willbearfruits/samplooler/app/screenshots/board-samplooler.png

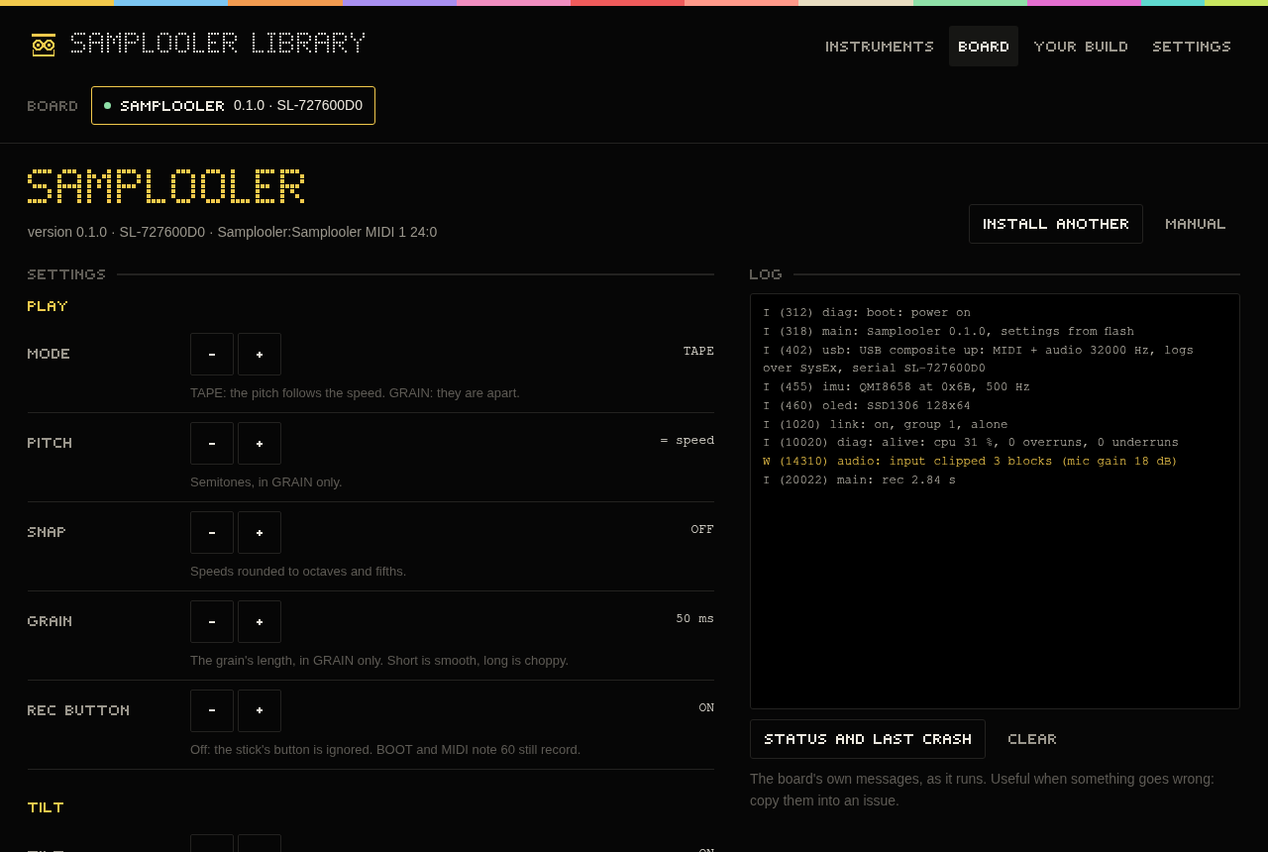
app/screenshots/board-samplooler.png
