willbearfruits/samplooler/app/screenshots/board.png

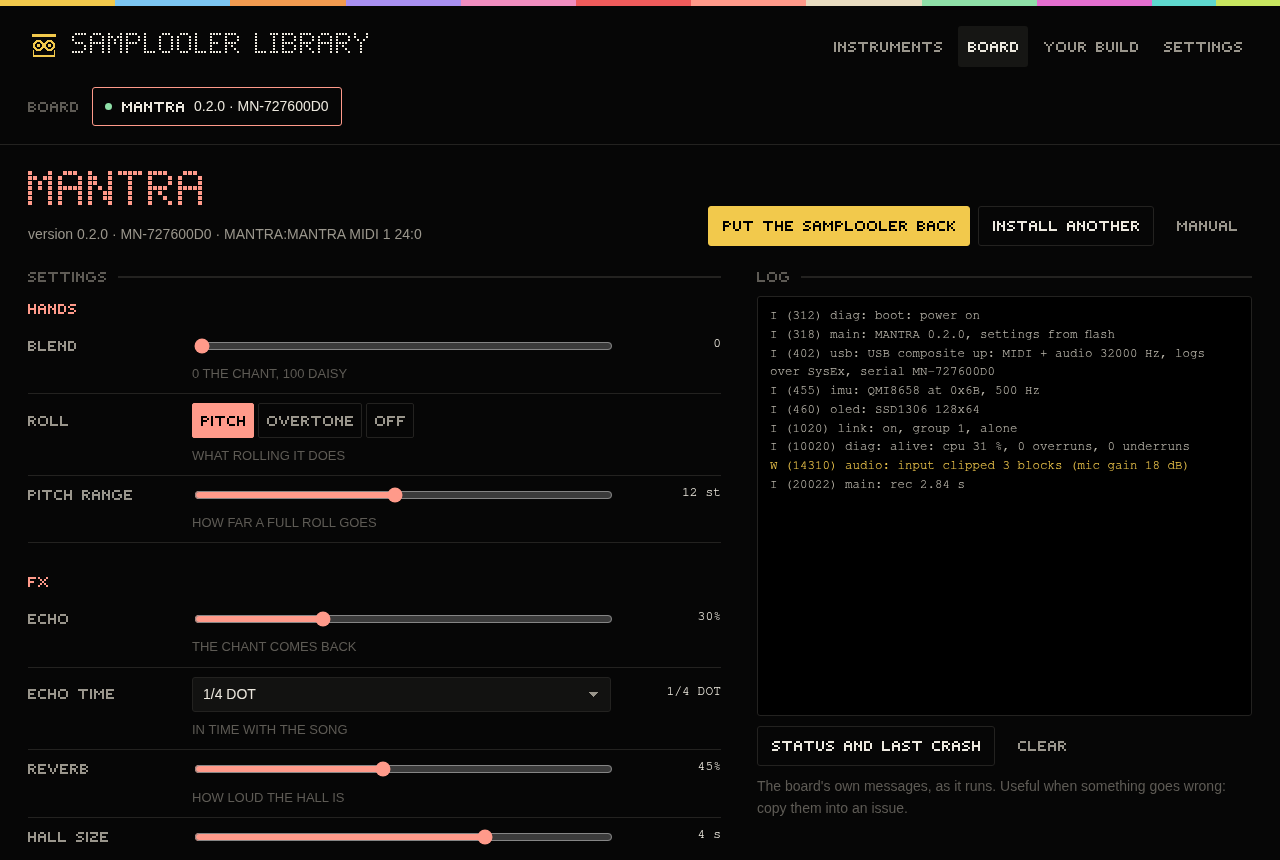
app/screenshots/board.png
