willbearfruits/samplooler/app/screenshots/instrument.png

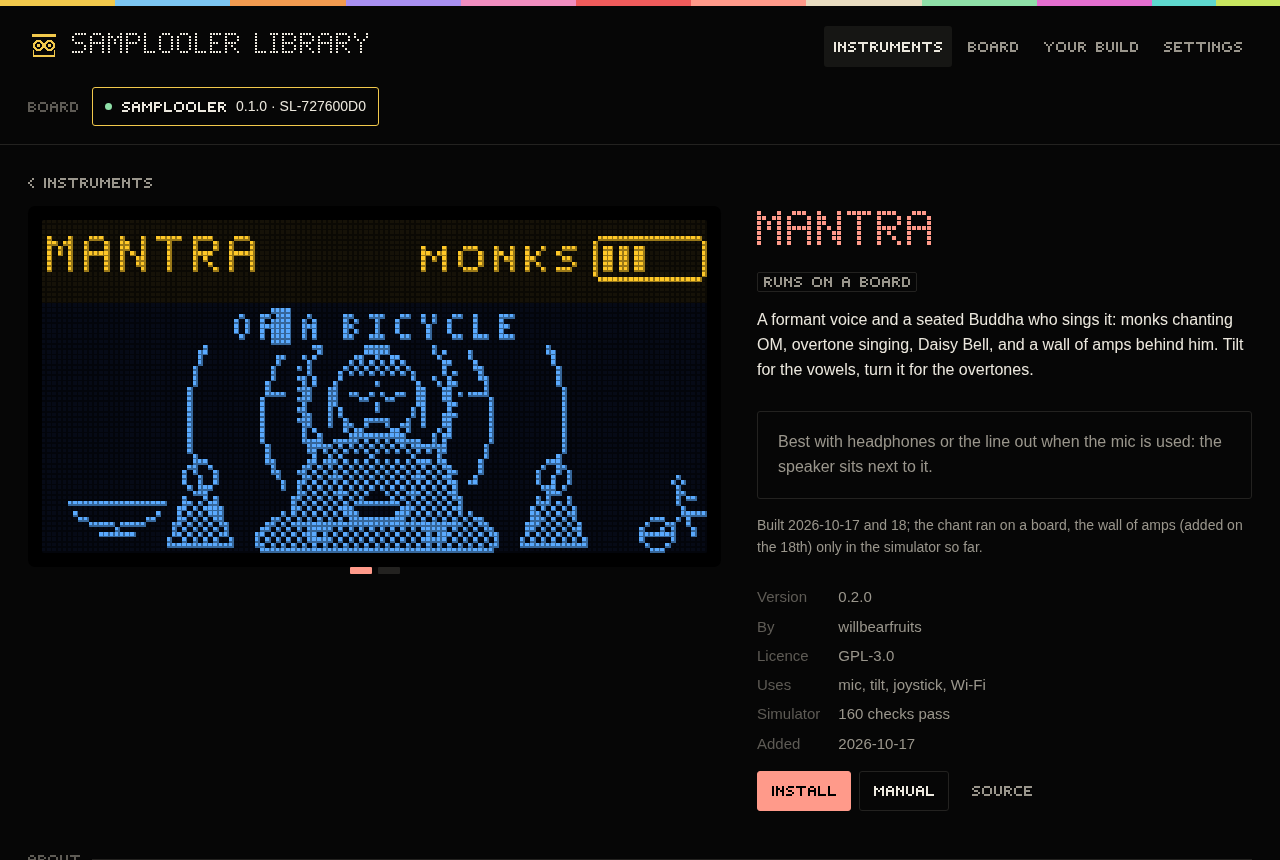
app/screenshots/instrument.png
