willbearfruits/samplooler/app/screenshots/library-update.png

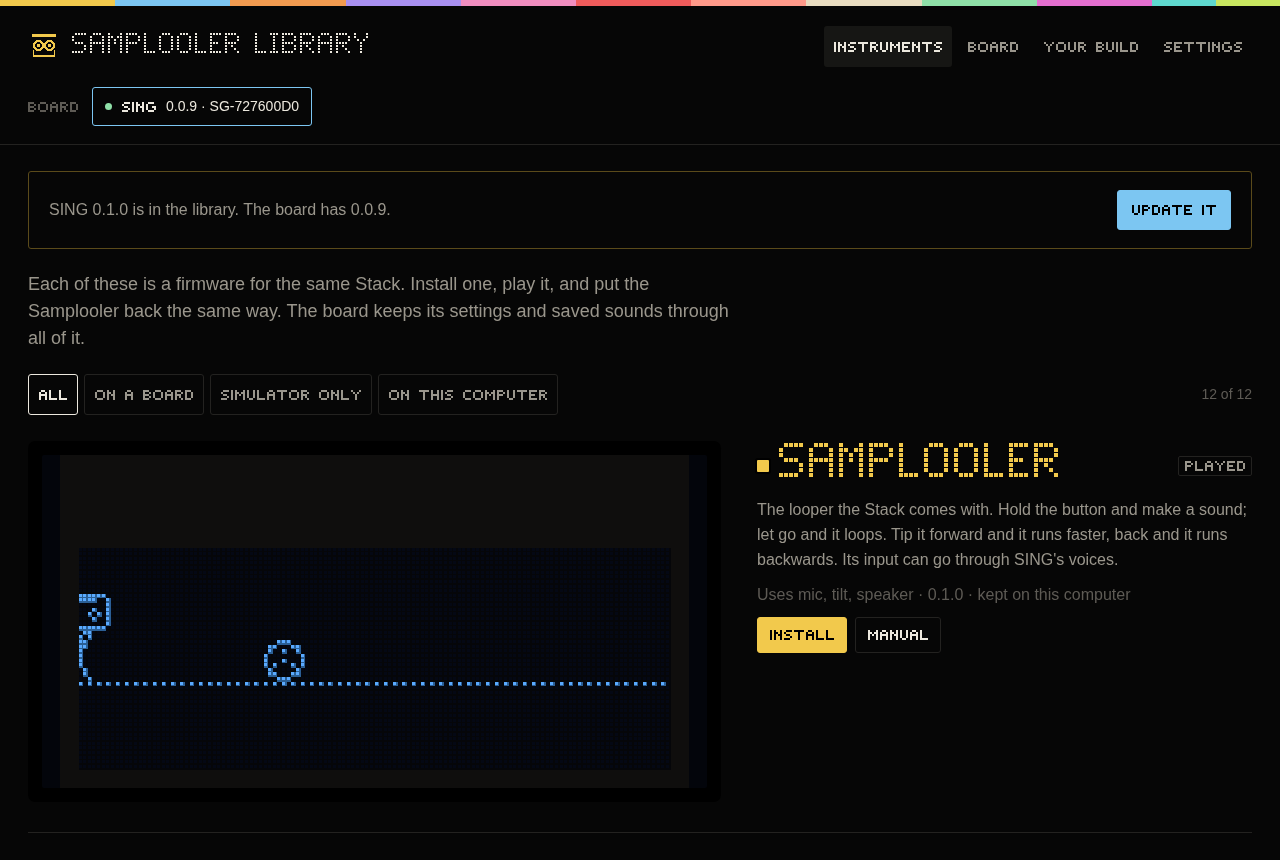
app/screenshots/library-update.png
