willbearfruits/samplooler/app/screenshots/settings.png

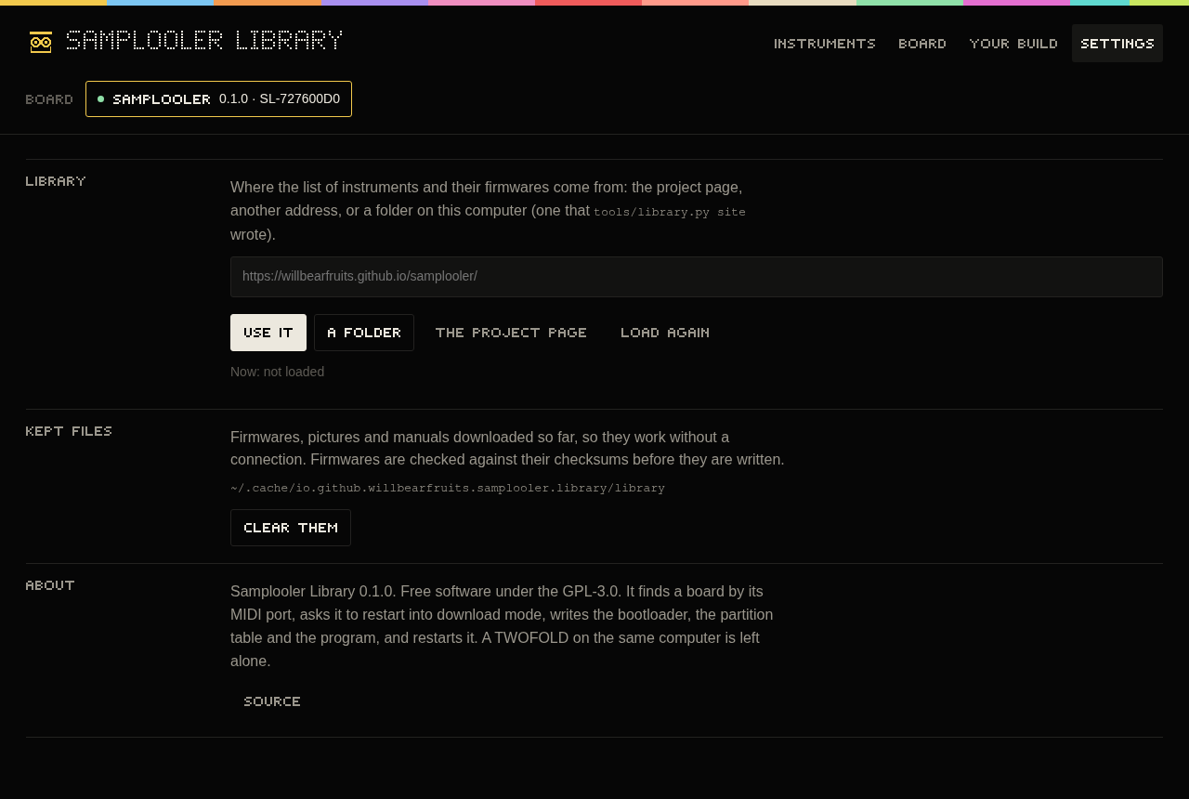
app/screenshots/settings.png
