willbearfruits/samplooler/app/screenshots/window-real.png

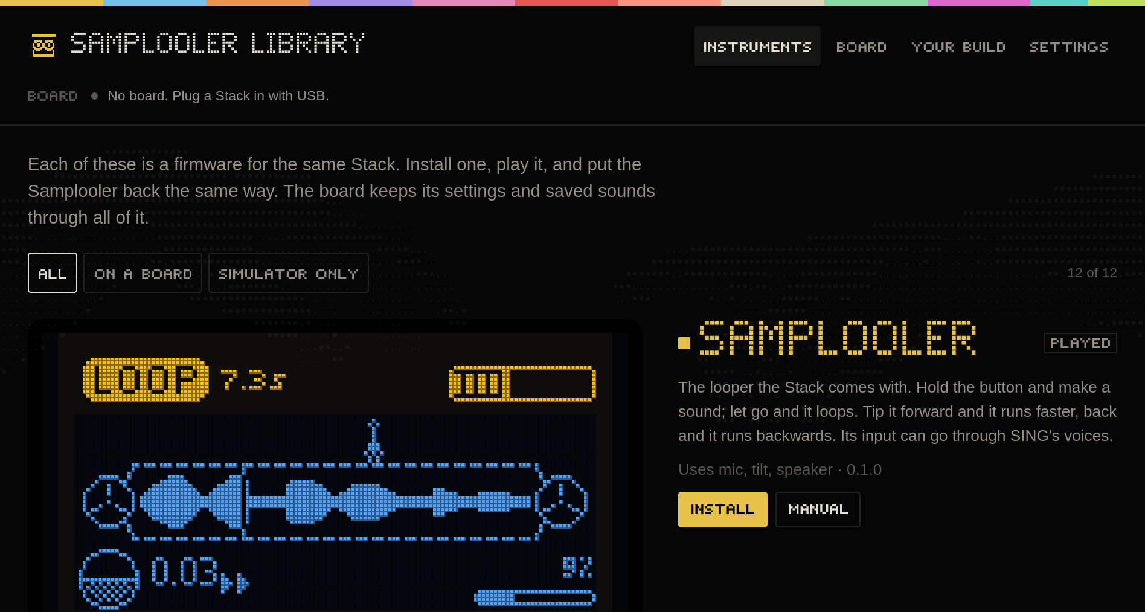
app/screenshots/window-real.png
