willbearfruits/samplooler/docs/pinout-1098.webp

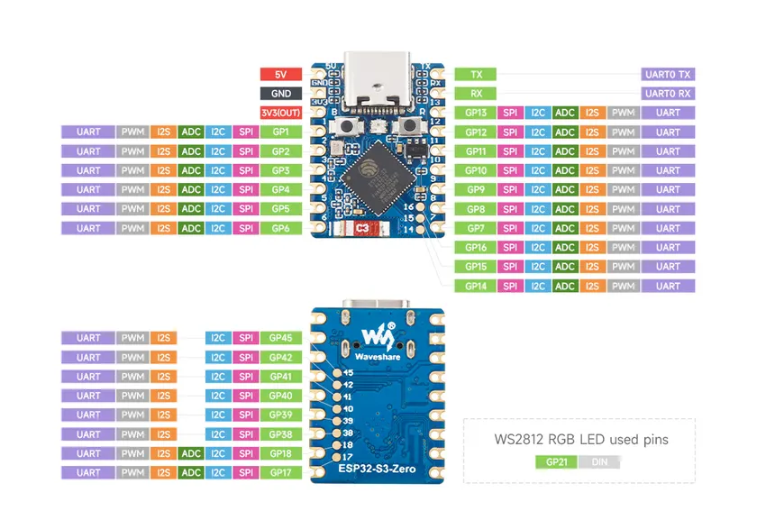
docs/pinout-1098.webp
