willbearfruits/samplooler/enclosure/out/plate_top.png

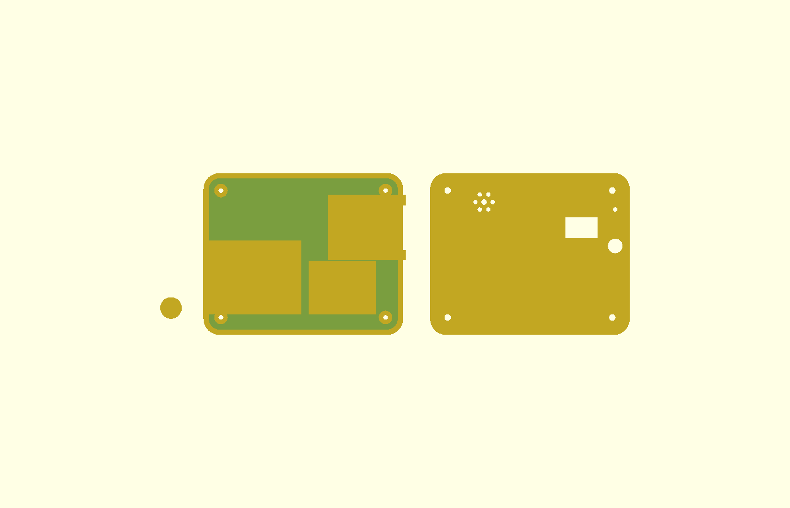
enclosure/out/plate_top.png
