willbearfruits/samplooler/enclosure/out/top.png

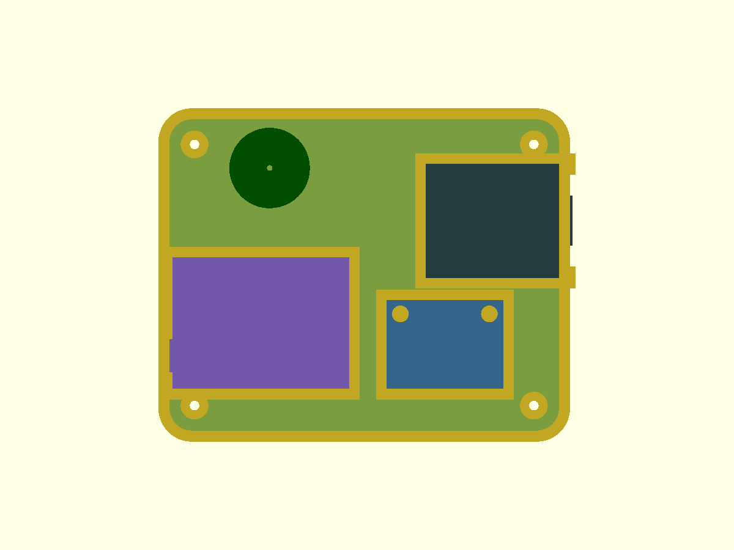
enclosure/out/top.png
