willbearfruits/samplooler/hardware/images/boards-plan.png

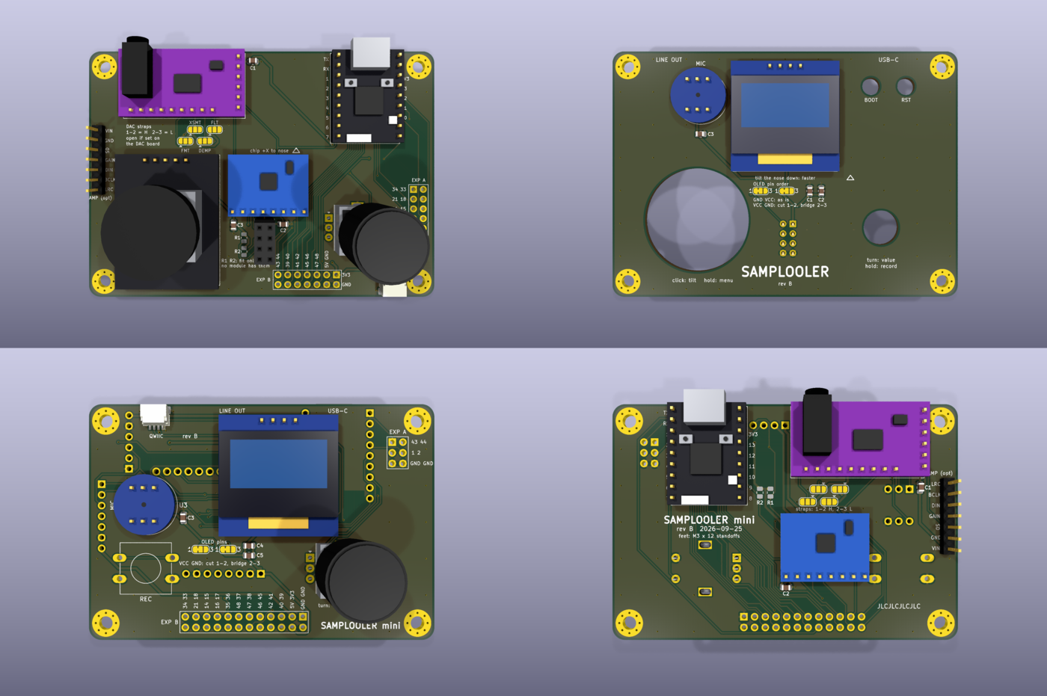
hardware/images/boards-plan.png
