willbearfruits/samplooler/hardware/images/bottom-3d.png

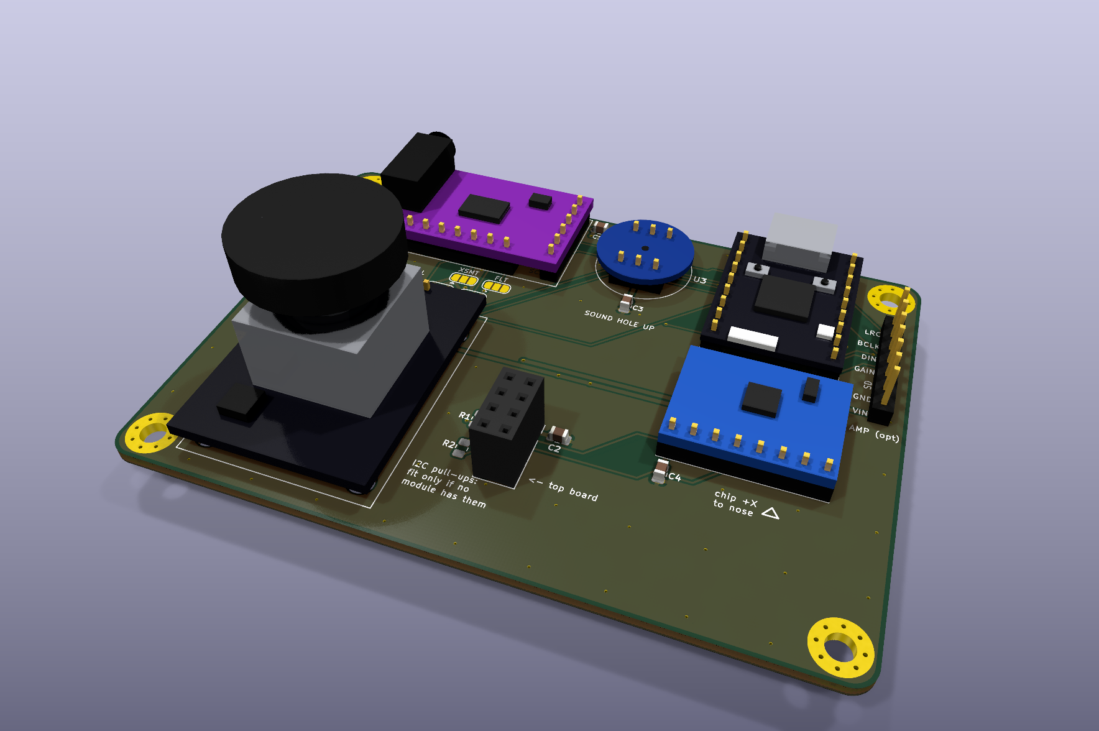
hardware/images/bottom-3d.png
