willbearfruits/samplooler/hardware/images/bottom-plan.png

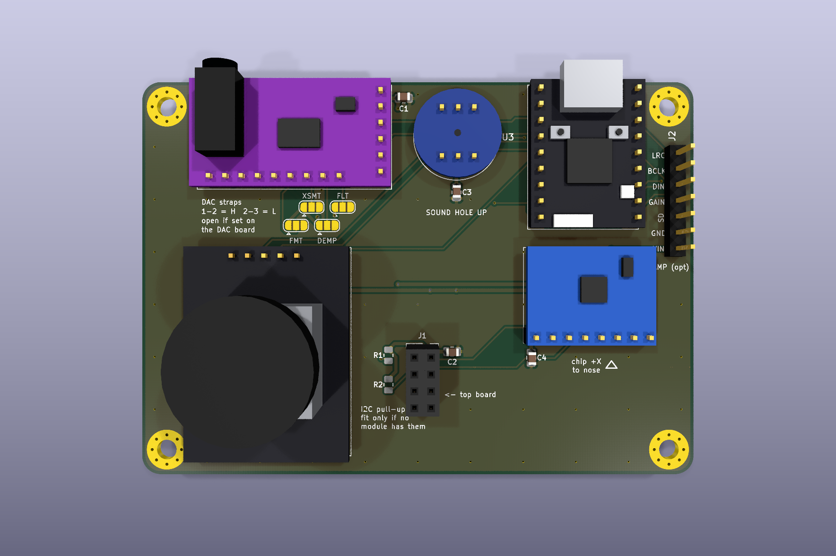
hardware/images/bottom-plan.png
