willbearfruits/samplooler/hardware/images/mini-3d-front-back.png

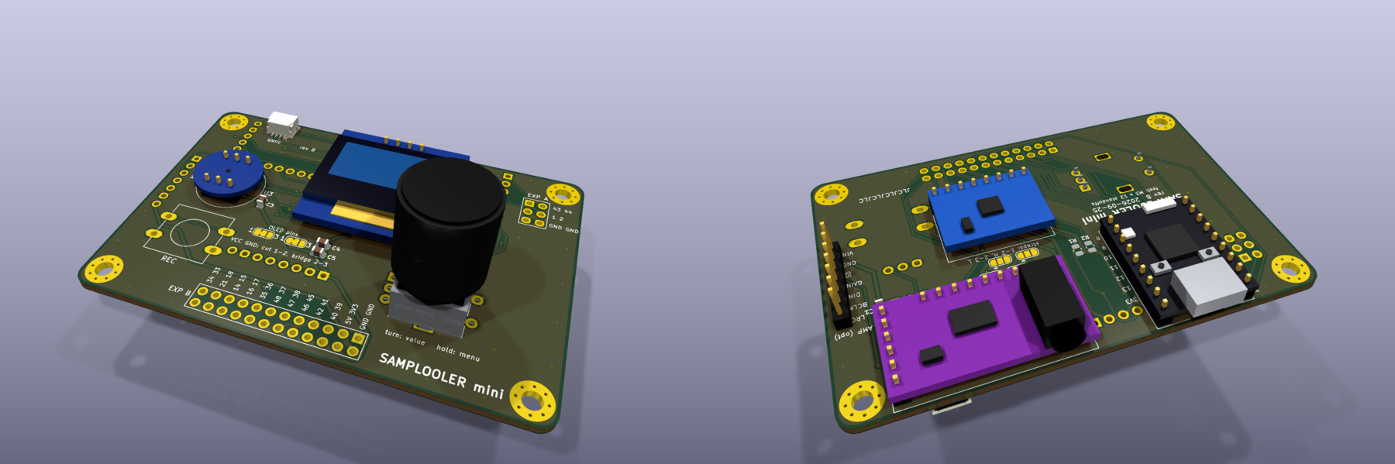
hardware/images/mini-3d-front-back.png
