willbearfruits/samplooler/hardware/images/mini-back-3d.png

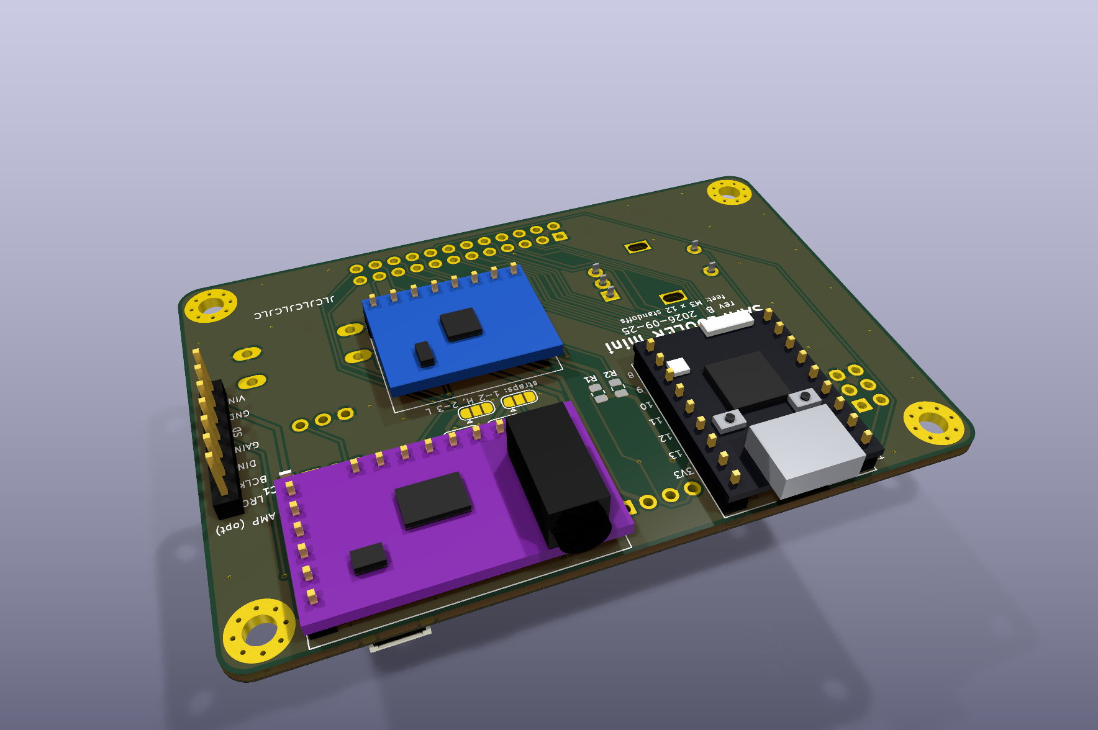
hardware/images/mini-back-3d.png
