willbearfruits/samplooler/hardware/images/mini-back-plan.png

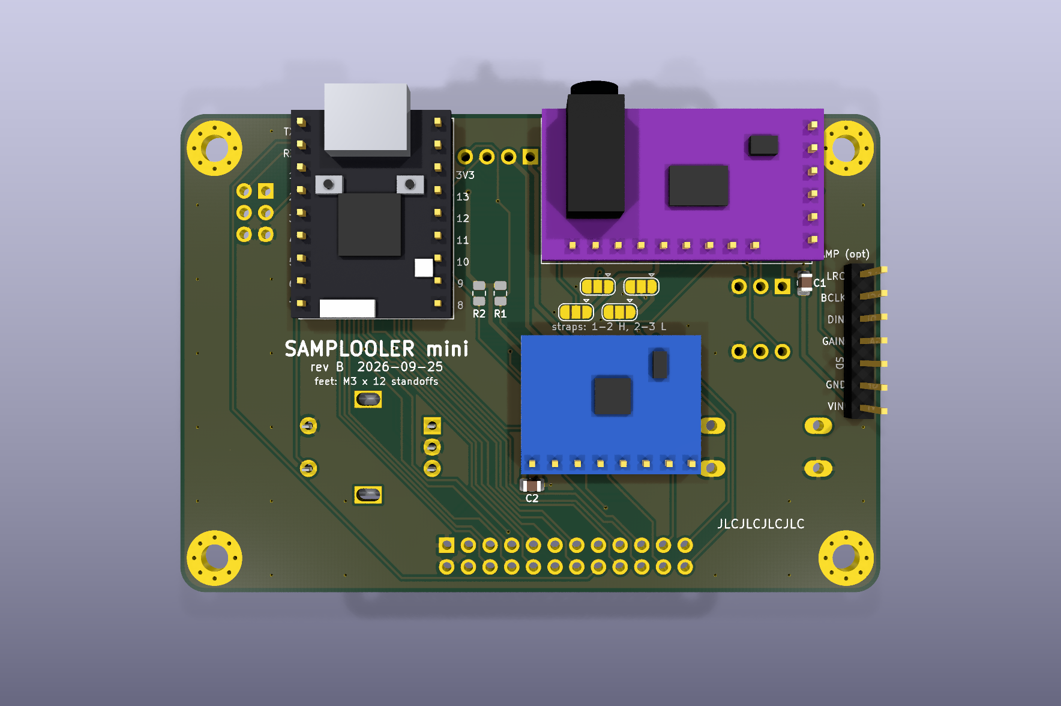
hardware/images/mini-back-plan.png
