willbearfruits/samplooler/hardware/images/mini-front-3d.png

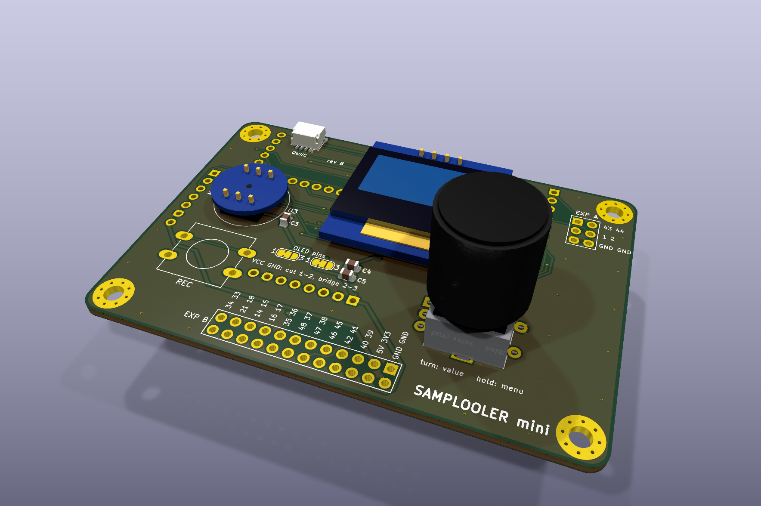
hardware/images/mini-front-3d.png
