willbearfruits/samplooler/hardware/images/mini-front-plan.png

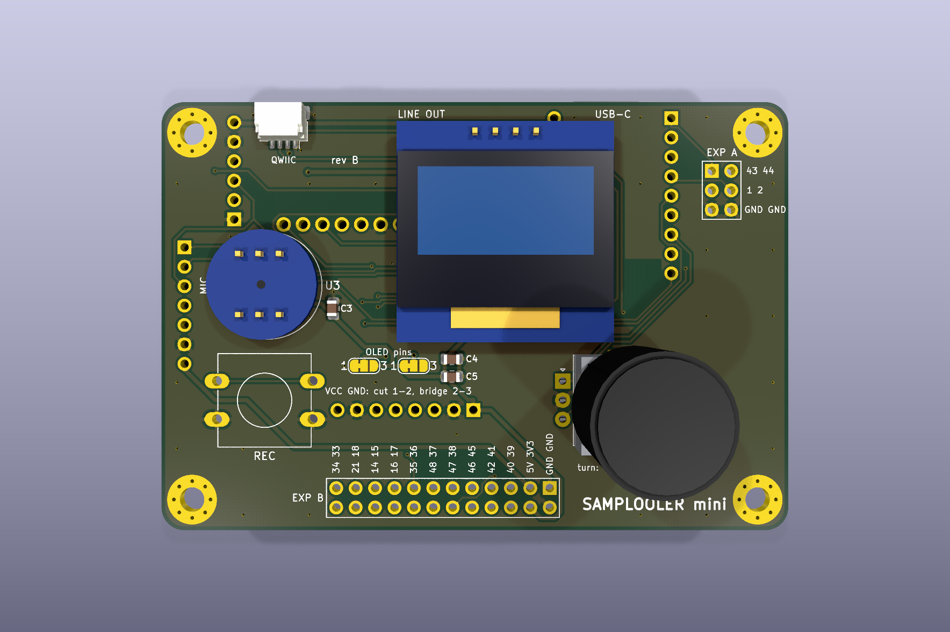
hardware/images/mini-front-plan.png
