willbearfruits/samplooler/hardware/images/mini-side.png

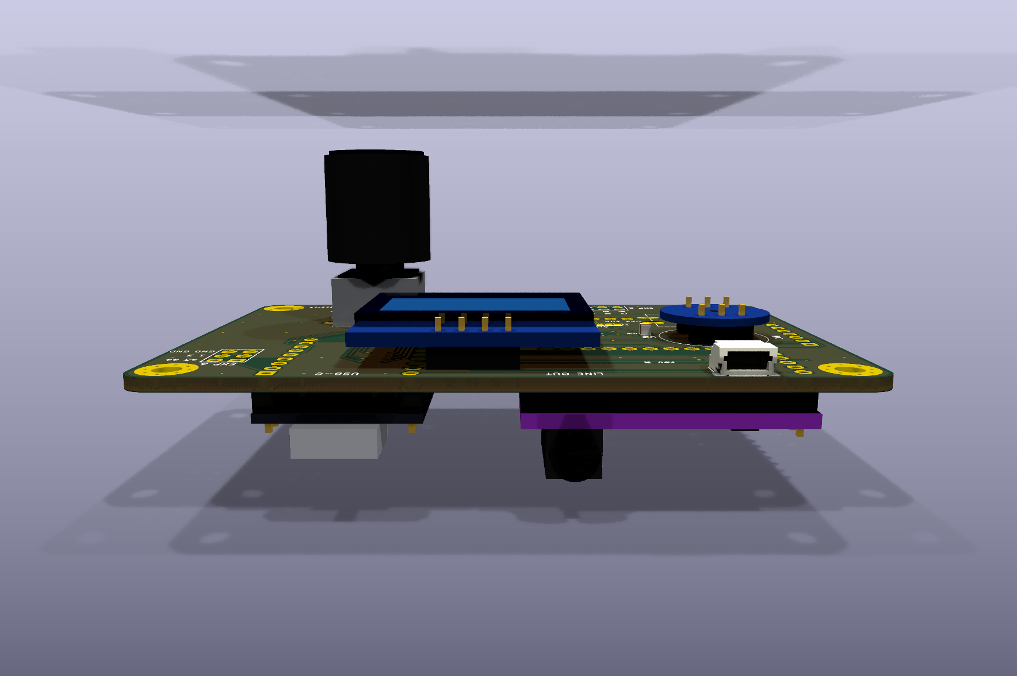
hardware/images/mini-side.png
