willbearfruits/samplooler/hardware/images/panel-mini-back.png

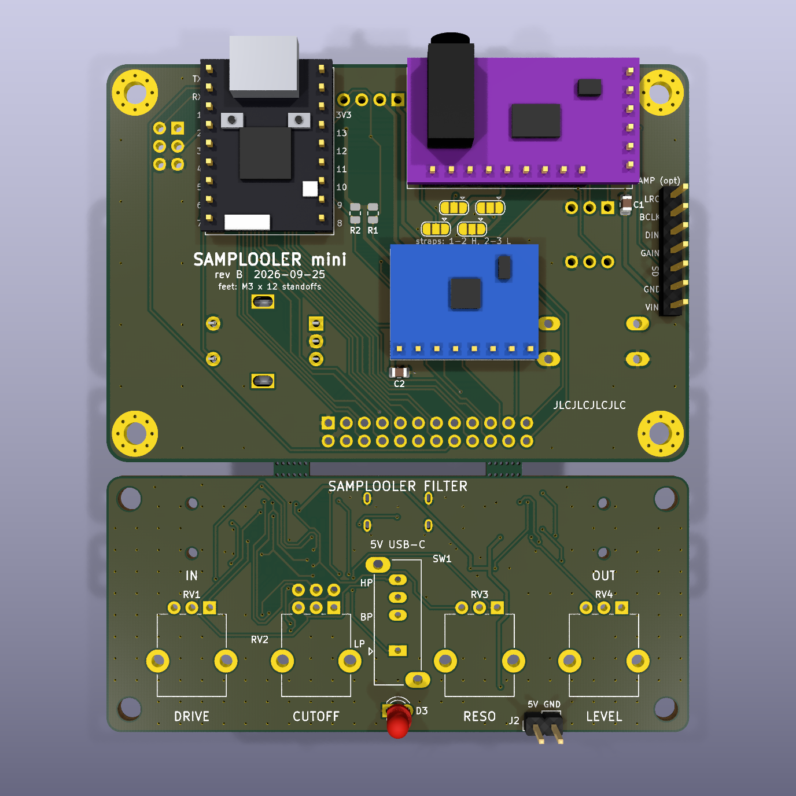
hardware/images/panel-mini-back.png
