willbearfruits/samplooler/hardware/images/panel-mini.png

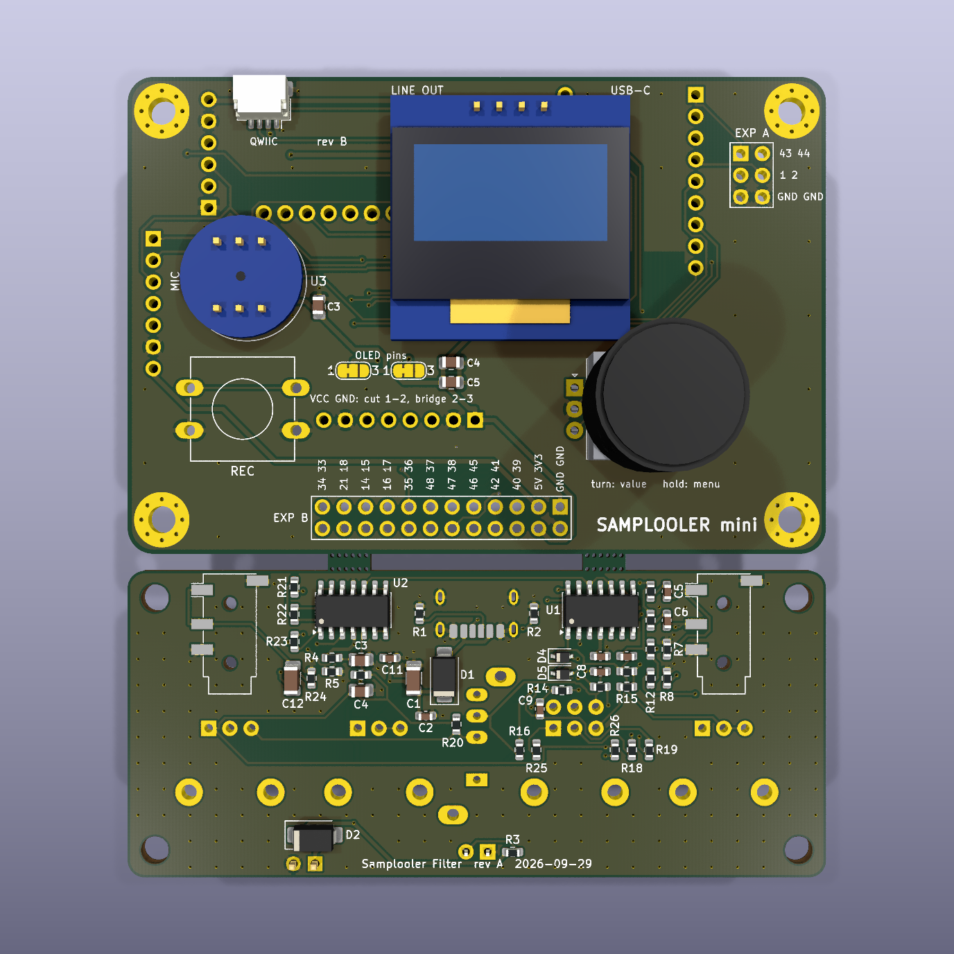
hardware/images/panel-mini.png
