willbearfruits/samplooler/hardware/images/panel-stack-back.png

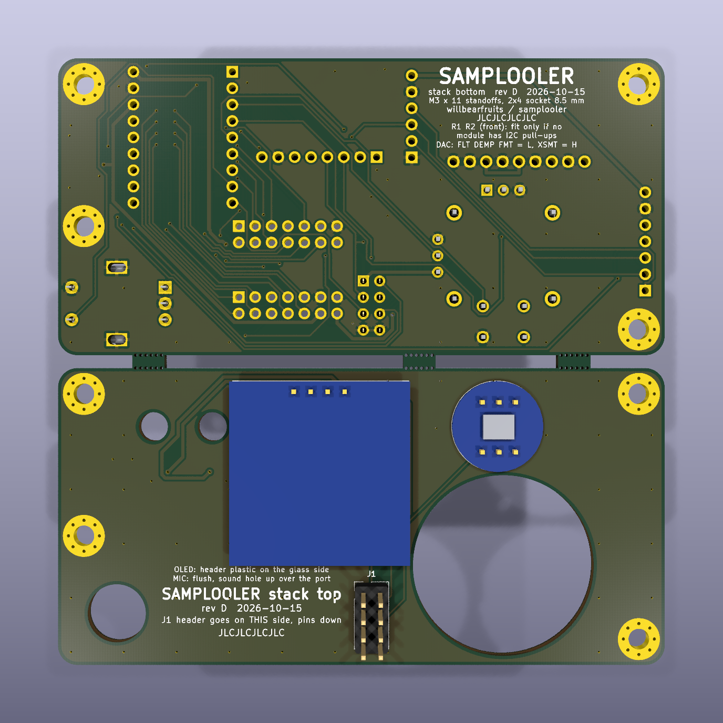
hardware/images/panel-stack-back.png
