willbearfruits/samplooler/hardware/images/top-3d.png

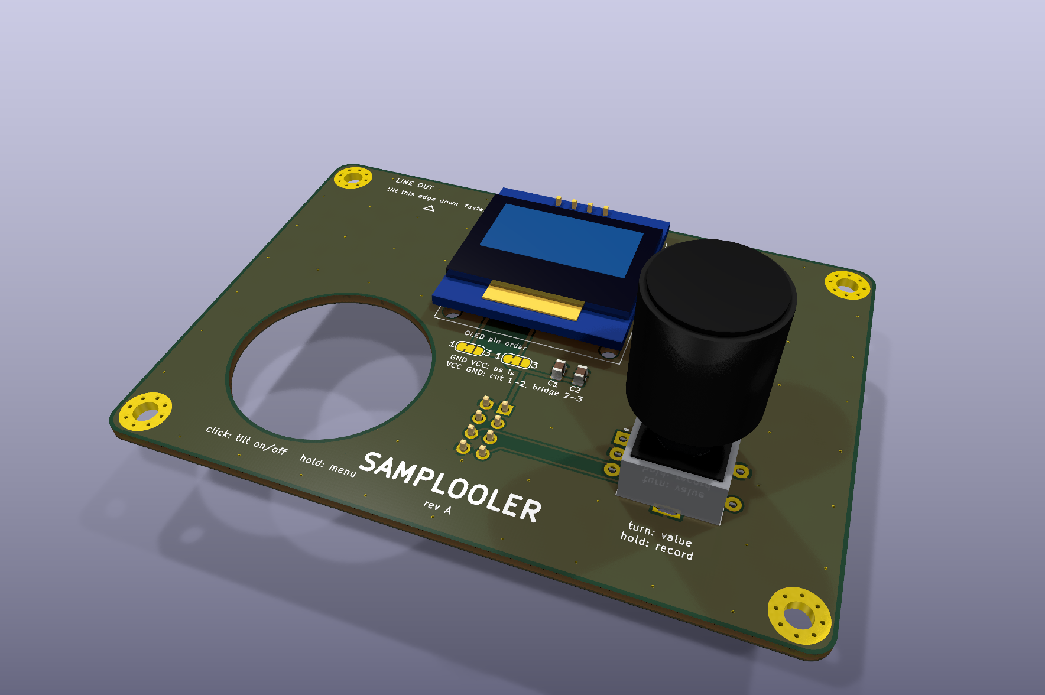
hardware/images/top-3d.png
