willbearfruits/samplooler/hardware/images/top-plan.png

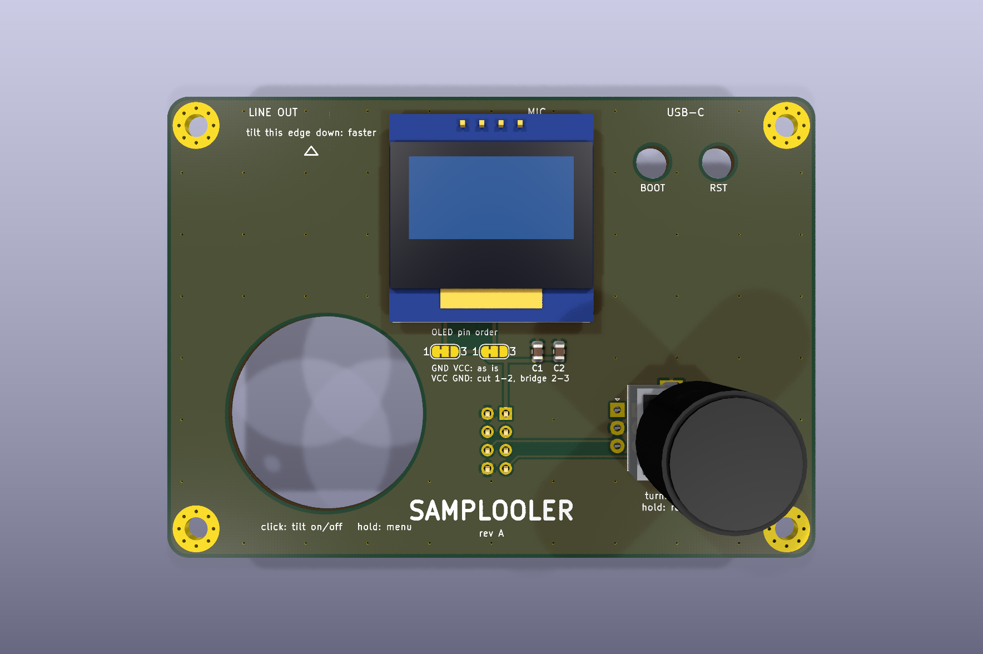
hardware/images/top-plan.png
