willbearfruits/samplooler/images/screens-c3.png

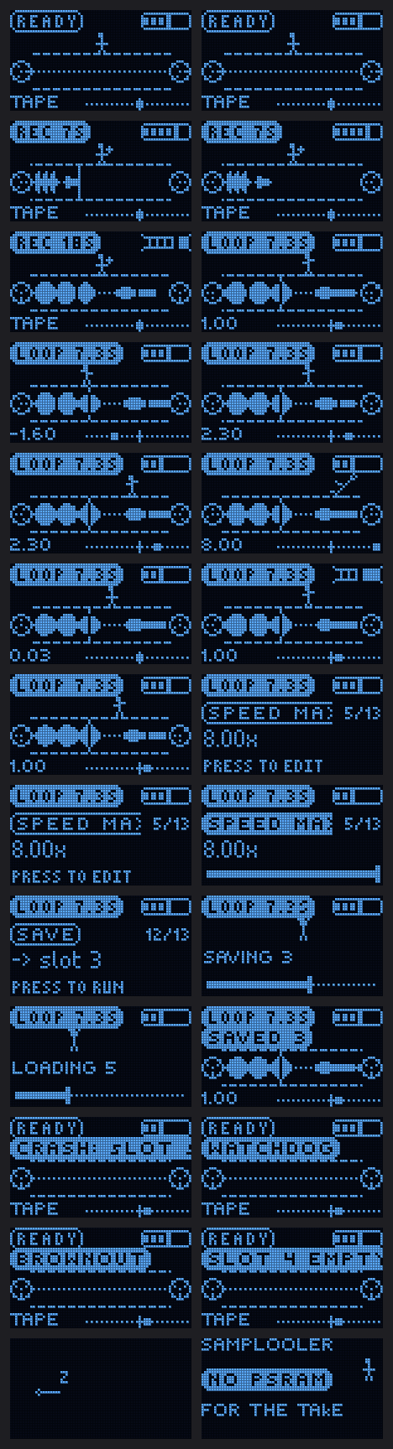
images/screens-c3.png
