willbearfruits/samplooler/images/screens-s3.png

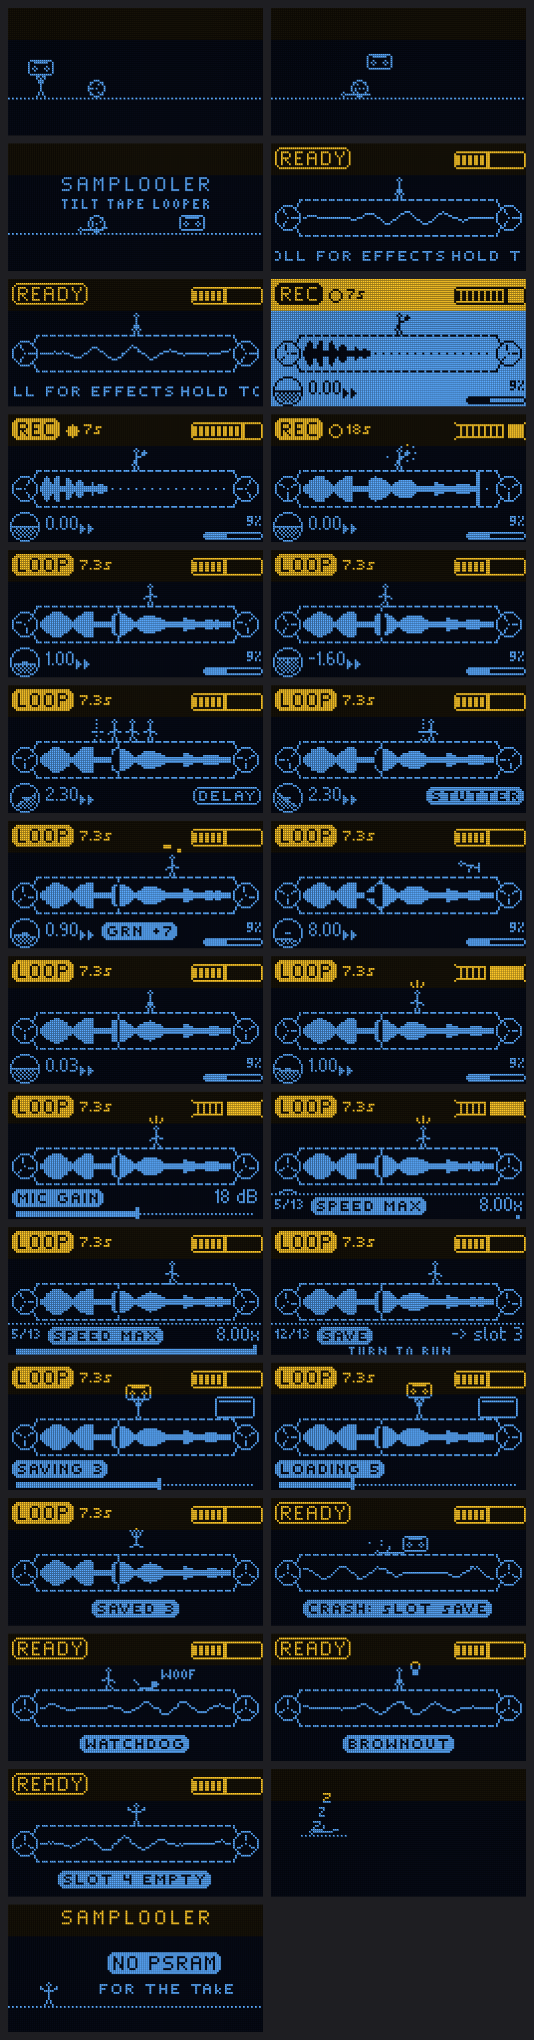
images/screens-s3.png
