willbearfruits/samplooler/instruments/band/images/band-bass-follow.gif

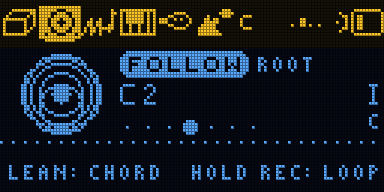
instruments/band/images/band-bass-follow.gif
