willbearfruits/samplooler/instruments/band/images/band-breath.gif

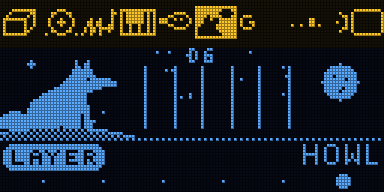
instruments/band/images/band-breath.gif
