willbearfruits/samplooler/instruments/band/images/band-drums.gif

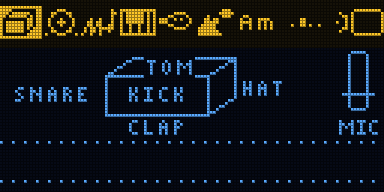
instruments/band/images/band-drums.gif
