willbearfruits/samplooler/instruments/band/images/band-howl_layer.gif

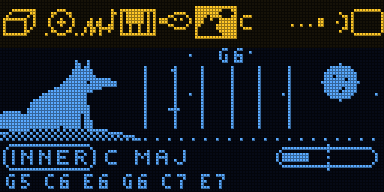
instruments/band/images/band-howl_layer.gif
