willbearfruits/samplooler/instruments/band/images/band-keys-comp.gif

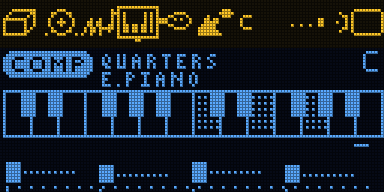
instruments/band/images/band-keys-comp.gif
