willbearfruits/samplooler/instruments/band/images/band-keys-sounds.gif

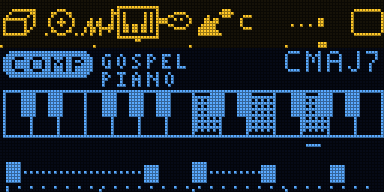
instruments/band/images/band-keys-sounds.gif
