willbearfruits/samplooler/instruments/band/images/band-lead-arp.gif

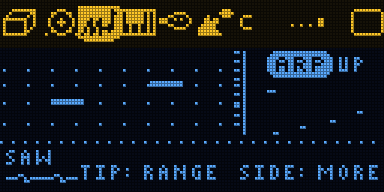
instruments/band/images/band-lead-arp.gif
