willbearfruits/samplooler/instruments/band/images/band-together.gif

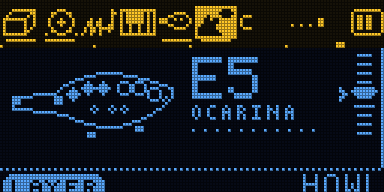
instruments/band/images/band-together.gif
