willbearfruits/samplooler/instruments/band/images/screens.png

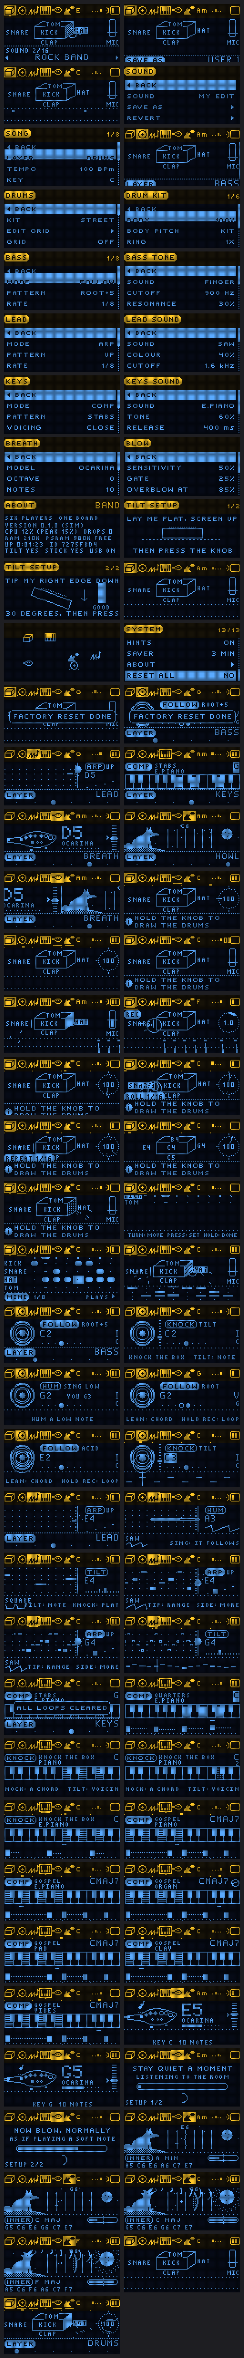
instruments/band/images/screens.png
