willbearfruits/samplooler/instruments/chirp/images/arrive.gif

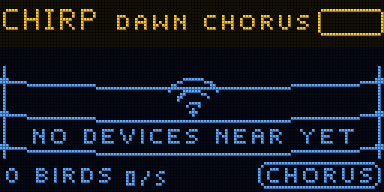
instruments/chirp/images/arrive.gif
