willbearfruits/samplooler/instruments/chirp/images/screens.png

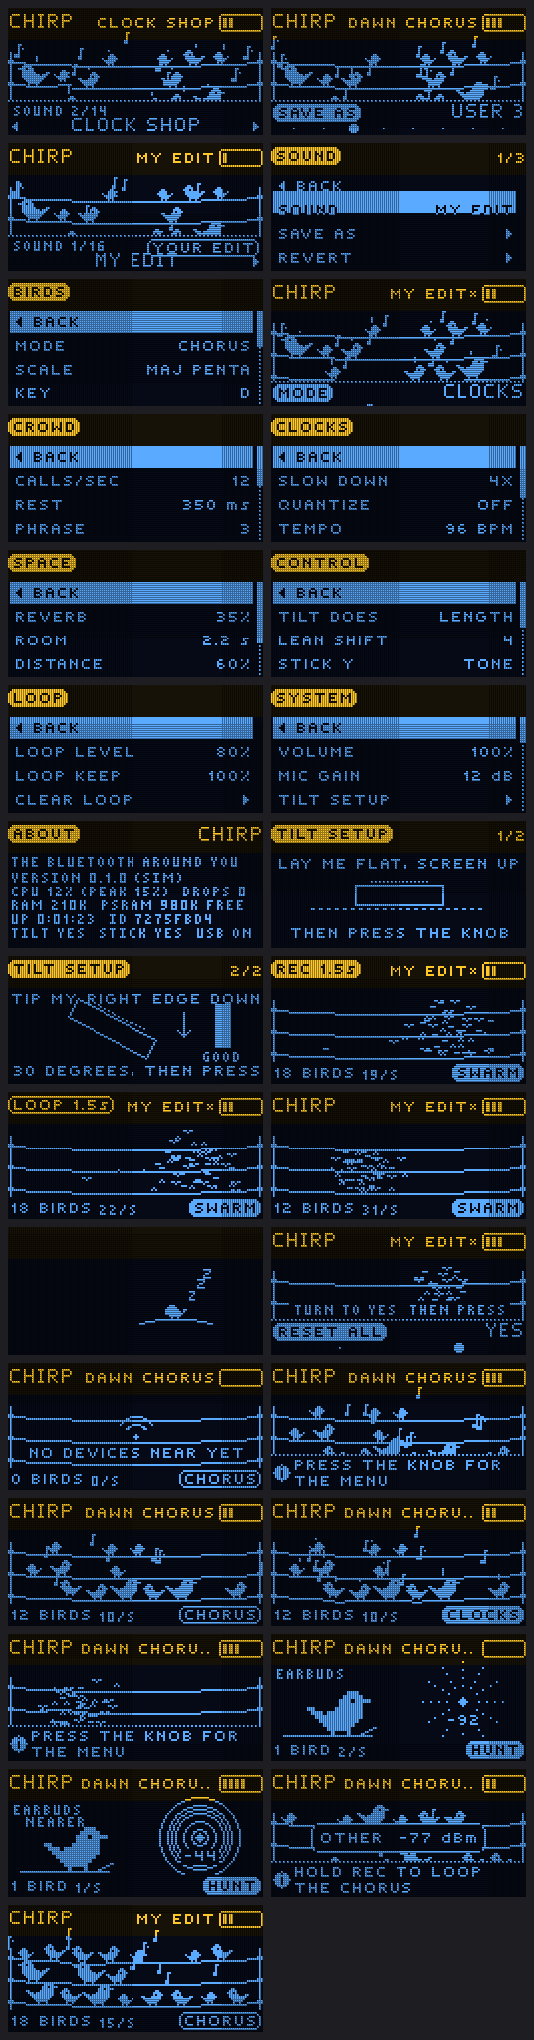
instruments/chirp/images/screens.png
