willbearfruits/samplooler/instruments/ether/images/hunt.gif

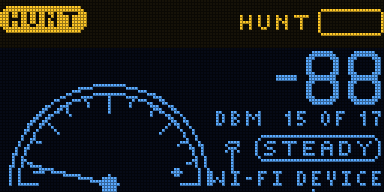
instruments/ether/images/hunt.gif
