willbearfruits/samplooler/instruments/ether/images/storm.gif

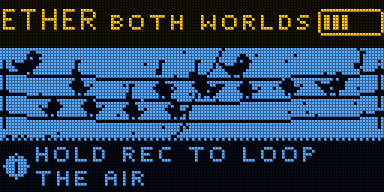
instruments/ether/images/storm.gif
