willbearfruits/samplooler/instruments/howl/images/play.gif

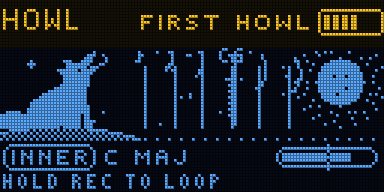
instruments/howl/images/play.gif
