willbearfruits/samplooler/instruments/howl/images/shepard.gif

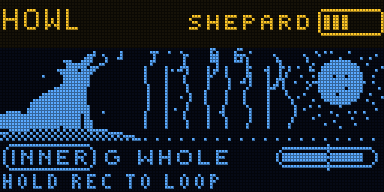
instruments/howl/images/shepard.gif
