willbearfruits/samplooler/instruments/huff/images/screens.png

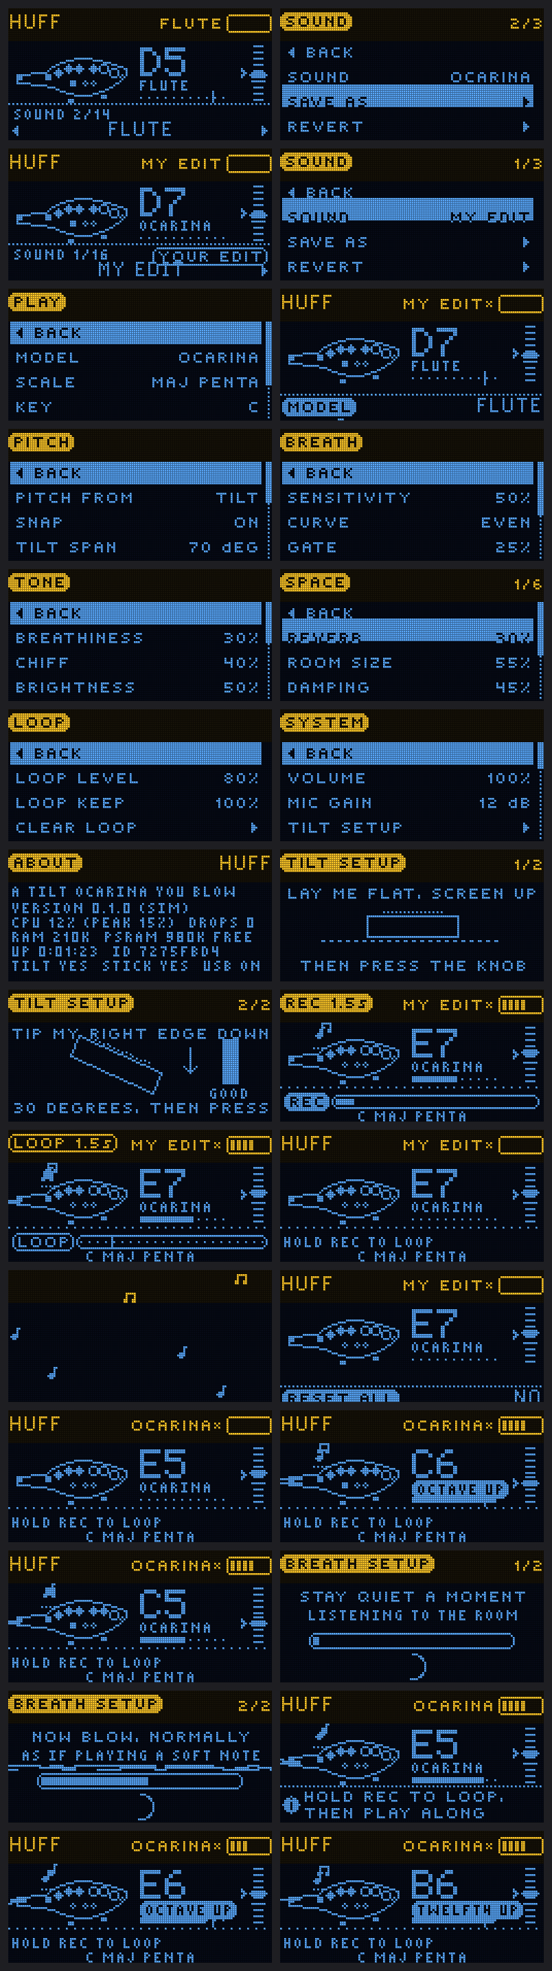
instruments/huff/images/screens.png
