willbearfruits/samplooler/instruments/jam/images/jam-bass-follow.gif

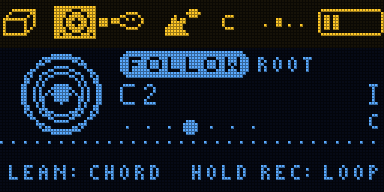
instruments/jam/images/jam-bass-follow.gif
