willbearfruits/samplooler/instruments/jam/images/jam-breath.gif

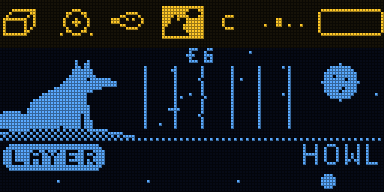
instruments/jam/images/jam-breath.gif
