willbearfruits/samplooler/instruments/jam/images/jam-drums-stick.gif

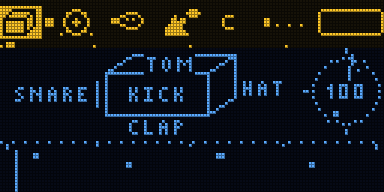
instruments/jam/images/jam-drums-stick.gif
