willbearfruits/samplooler/instruments/jam/images/jam-drums.gif

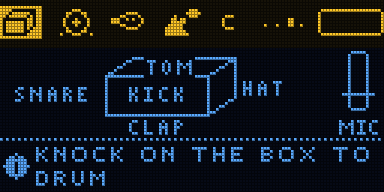
instruments/jam/images/jam-drums.gif
