willbearfruits/samplooler/instruments/jam/images/jam-howl_layer.gif

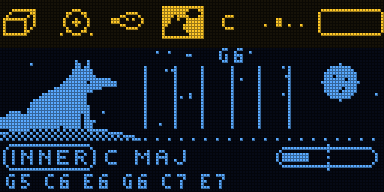
instruments/jam/images/jam-howl_layer.gif
