willbearfruits/samplooler/instruments/jam/images/screens.png

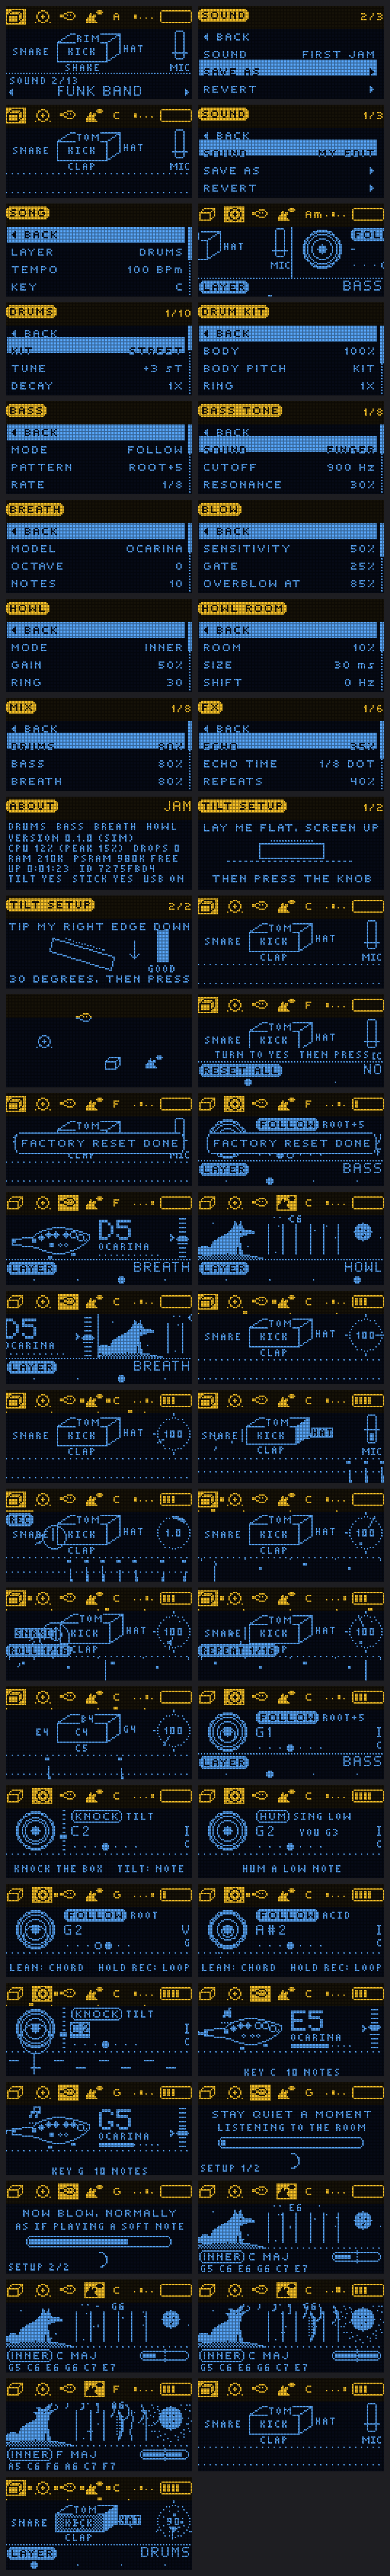
instruments/jam/images/screens.png
