willbearfruits/samplooler/instruments/knock/images/knock-marimba.gif

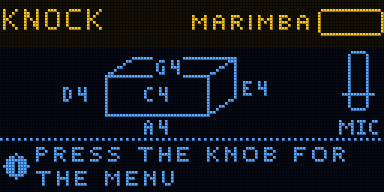
instruments/knock/images/knock-marimba.gif
