willbearfruits/samplooler/instruments/knock/images/knock-stick.gif

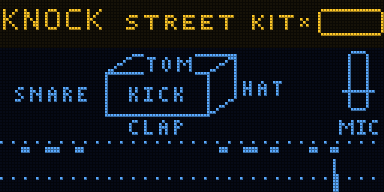
instruments/knock/images/knock-stick.gif
