willbearfruits/samplooler/instruments/knock/images/screens.png

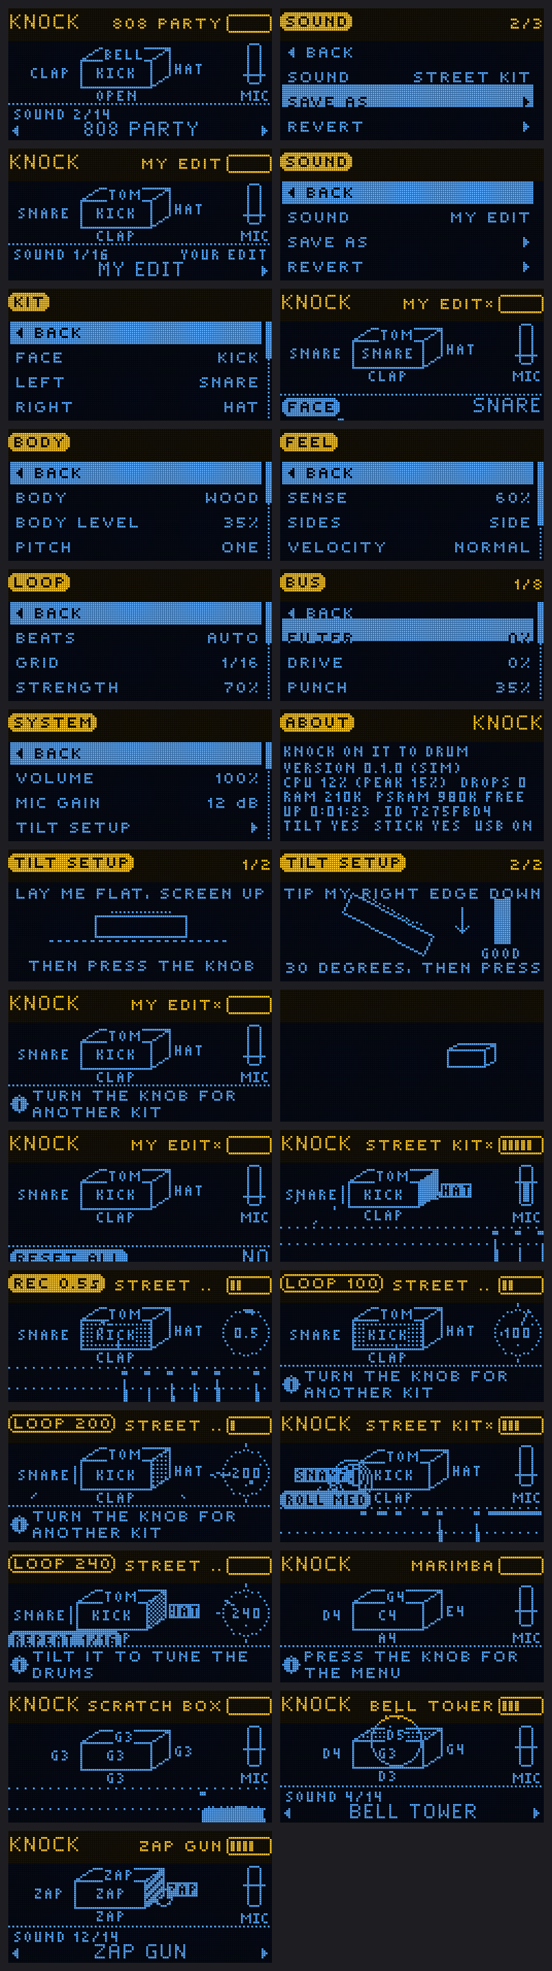
instruments/knock/images/screens.png
