willbearfruits/samplooler/instruments/mantra/images/mantra-daisy.gif

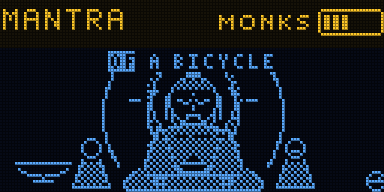
instruments/mantra/images/mantra-daisy.gif
