willbearfruits/samplooler/instruments/sing/images/screens.png

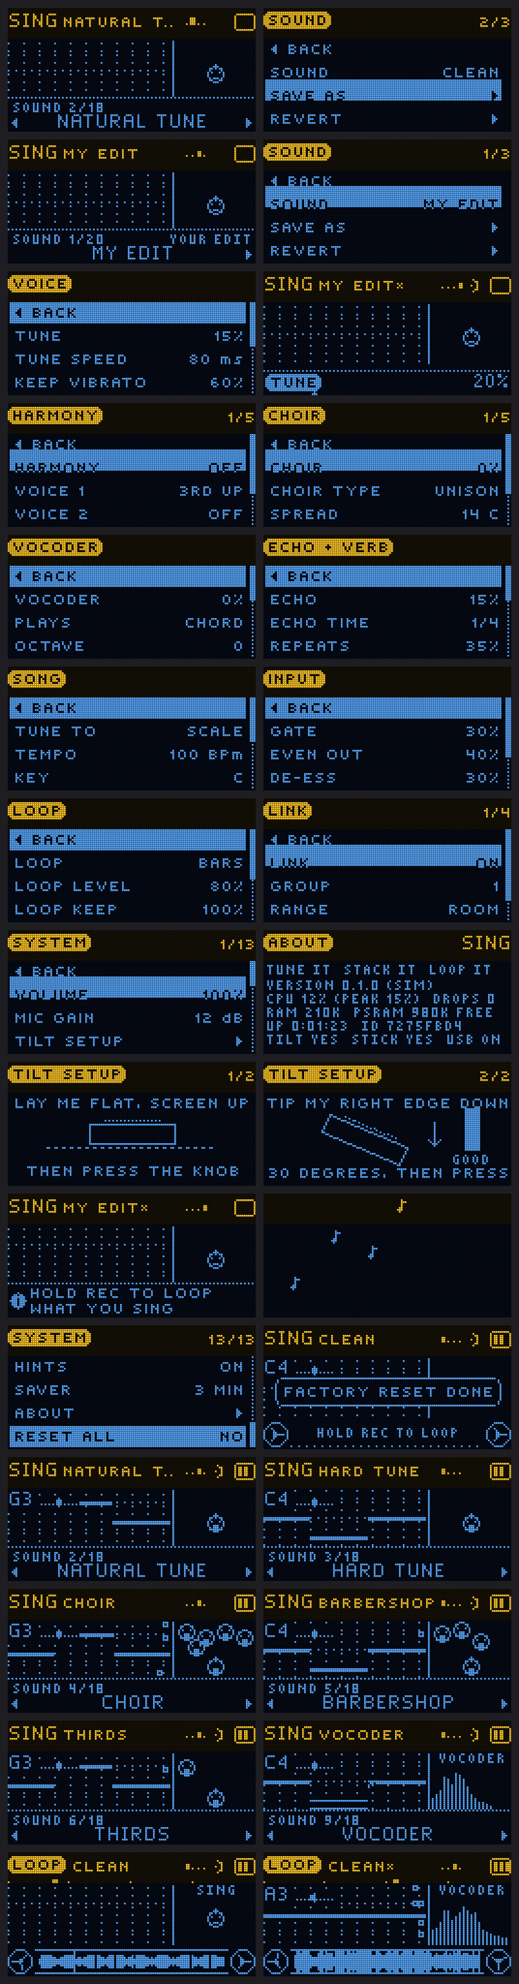
instruments/sing/images/screens.png
