willbearfruits/samplooler/instruments/sing/images/sing-sing.gif

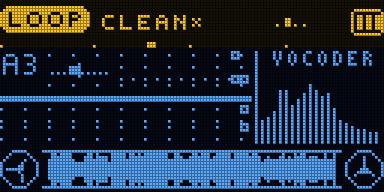
instruments/sing/images/sing-sing.gif
