willbearfruits/samplooler/instruments/sing/images/sing-tilt.gif

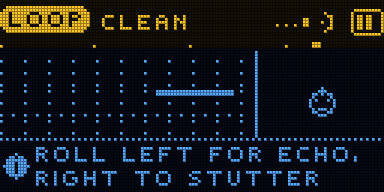
instruments/sing/images/sing-tilt.gif
