willbearfruits/samplooler/instruments/sniff/images/ghost.gif

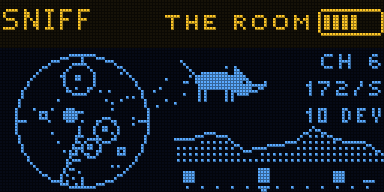
instruments/sniff/images/ghost.gif
