willbearfruits/samplooler/instruments/sniff/images/play-screens.png

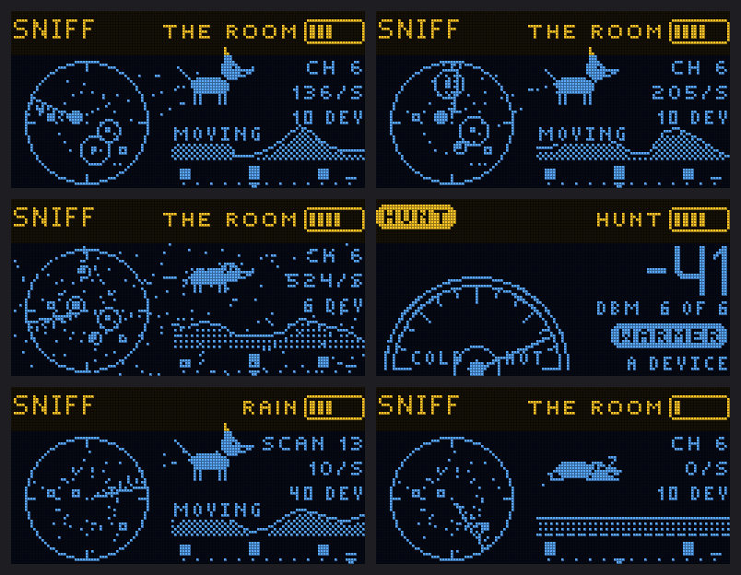
instruments/sniff/images/play-screens.png
