willbearfruits/samplooler/instruments/sniff/images/storm.gif

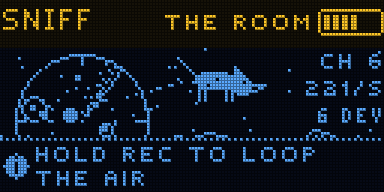
instruments/sniff/images/storm.gif
