willbearfruits/samplooler/instruments/wreck/images/wreck-beat-grid.gif

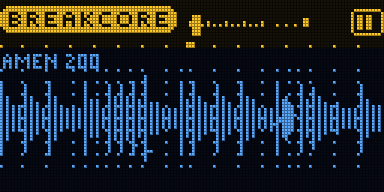
instruments/wreck/images/wreck-beat-grid.gif
