willbearfruits/samplooler/instruments/wreck/images/wreck-kit-sample.gif

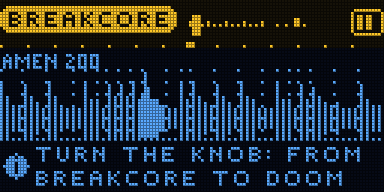
instruments/wreck/images/wreck-kit-sample.gif
