willbearfruits/samplooler/media/screens/sheet.png

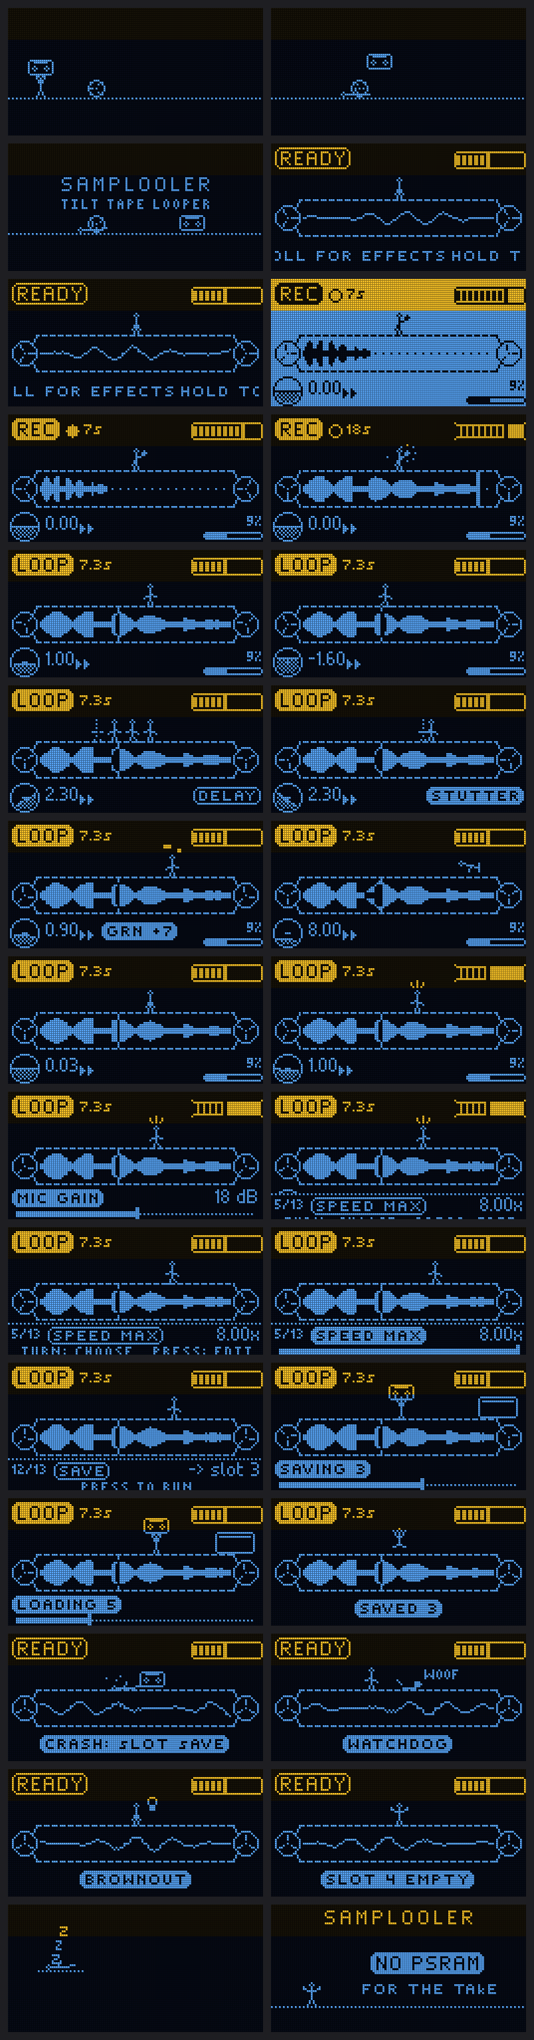
media/screens/sheet.png
