willbearfruits/samplooler/site/img/c3-case-open.png

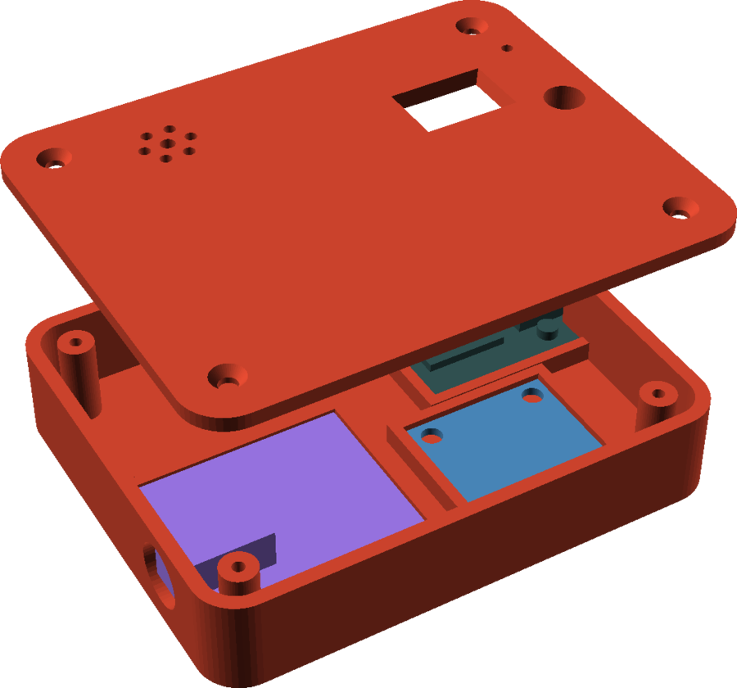
site/img/c3-case-open.png
