willbearfruits/samplooler/site/img/c3-case.png

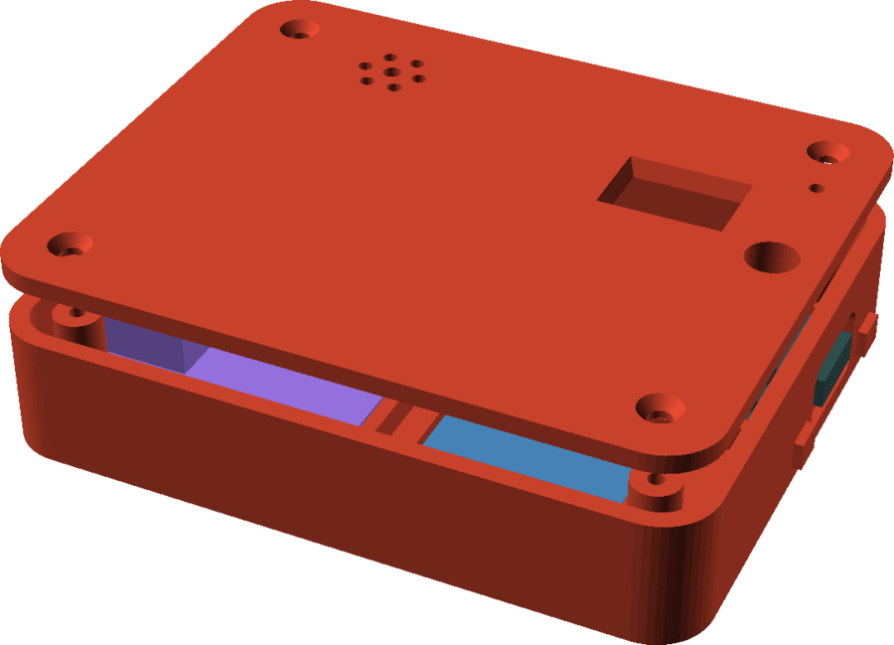
site/img/c3-case.png
