willbearfruits/samplooler/site/img/c3-looping.png

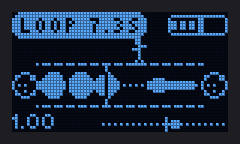
site/img/c3-looping.png
