willbearfruits/samplooler/site/img/c3-ready.png

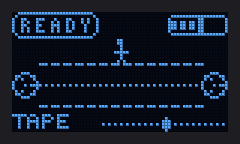
site/img/c3-ready.png
