willbearfruits/samplooler/site/img/c3-screen-5_play_delay.png

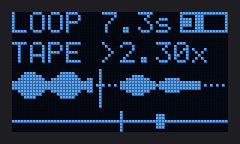
site/img/c3-screen-5_play_delay.png
