willbearfruits/samplooler/site/img/c3-screen-9_menu_open.png

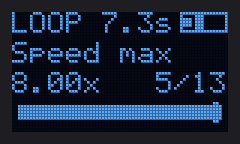
site/img/c3-screen-9_menu_open.png
