willbearfruits/samplooler/site/img/s3-delay.png

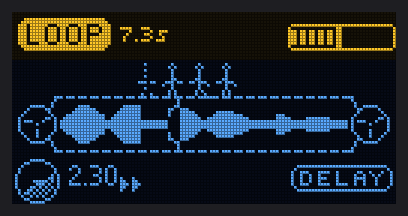
site/img/s3-delay.png
