willbearfruits/samplooler/site/img/s3-grain.png

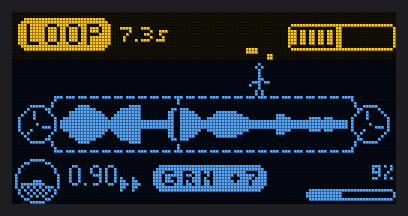
site/img/s3-grain.png
