willbearfruits/samplooler/site/img/screen-2_idle.png

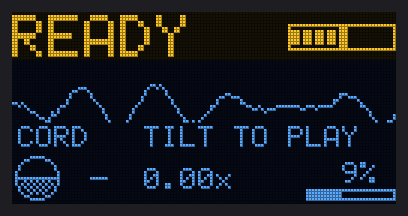
site/img/screen-2_idle.png
