willbearfruits/samplooler/site/img/screen-4_recording.png

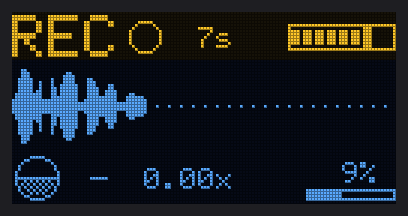
site/img/screen-4_recording.png
