willbearfruits/samplooler/site/img/screen-5_play_delay.png

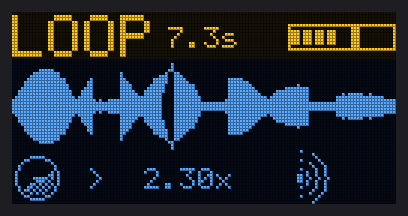
site/img/screen-5_play_delay.png
