willbearfruits/samplooler/site/img/screen-6_grain_stutter.png

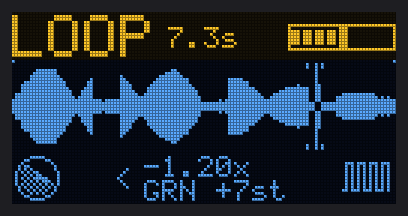
site/img/screen-6_grain_stutter.png
