willbearfruits/samplooler/site/img/screen-9_menu_save.png

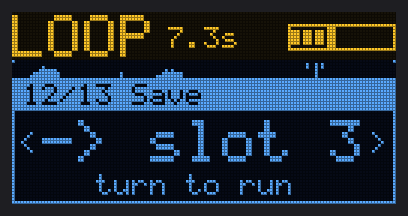
site/img/screen-9_menu_save.png
