willbearfruits/samplooler/site/img/screens-c3.png

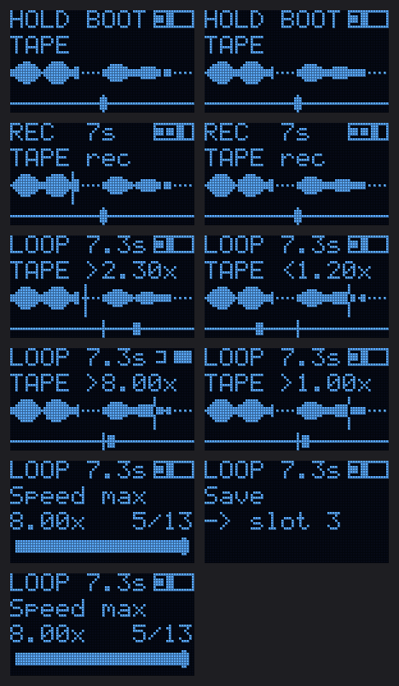
site/img/screens-c3.png
