willbearfruits/samplooler/site/img/showcase.jpg

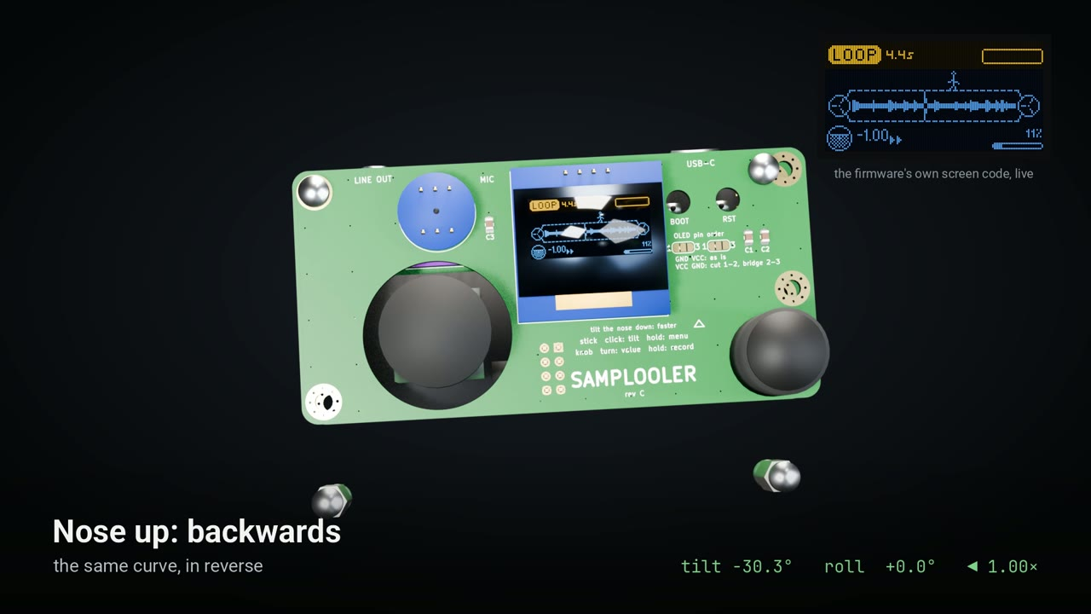
site/img/showcase.jpg
