willbearfruits/samplooler/site/img/tour-poster.png

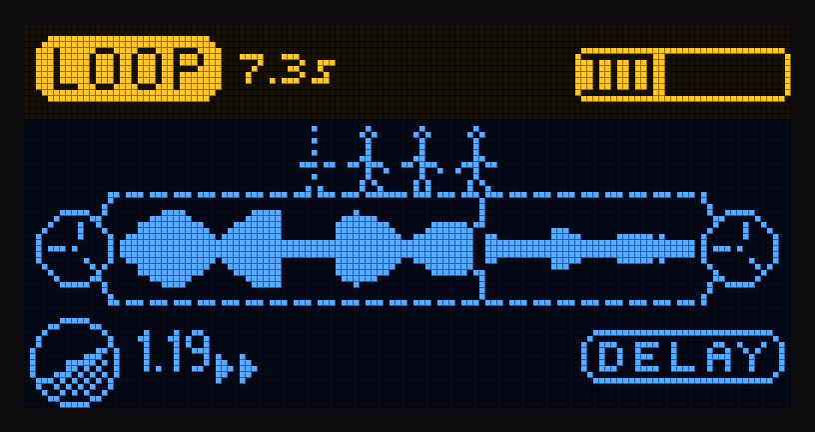
site/img/tour-poster.png
