willbearfruits/samplooler/hardware/fab/samplooler-panel-mini-bom.csv

Comment | Designator | Footprint | LCSC Part #
100R | FR25,FR26,FR6 | R_0603_1608Metric | C22775
100k | FR20,FR7,FR8 | R_0603_1608Metric | C25803
100n | FC10,FC11,FC2 | C_0603_1608Metric | C14663
100n | MC2,MC3,MC5 | C_0805_2012Metric | C49678
100p | FC7 | C_0603_1608Metric | C14858
10k | FR14,FR15,FR22,FR4,FR5 | R_0603_1608Metric | C25804
10u | FC3,FC4,MC1,MC4 | C_0805_2012Metric | C15850
1N4148W | FD4,FD5 | D_SOD-323 | C2128
1k5 | FR17 | R_0603_1608Metric | C22843
1u | FC5,FC6 | C_0603_1608Metric | C15849
22k | FR10,FR21,FR9 | R_0603_1608Metric | C31850
2k2 | FR11,FR12,FR3 | R_0603_1608Metric | C4190
3.3n | FC8,FC9 | C_0603_1608Metric | C190576
33k | FR13 | R_0603_1608Metric | C4216
470R | FR16 | R_0603_1608Metric | C23179
47R | FR23 | R_0603_1608Metric | C23182
47k | FR24 | R_0603_1608Metric | C25819
47u | FC1,FC12 | C_1206_3216Metric | C96123
4k7 | FR18,FR19 | R_0603_1608Metric | C23162
5k1 | FR1,FR2 | R_0603_1608Metric | C23186
IN/OUT | FJ3,FJ4 | Jack_3.5mm_PJ320D_Horizontal | C431535
MCP6004 | FU1,FU2 | SOIC-14_3.9x8.7mm_P1.27mm | C7378
SS14 | FD1,FD2 | D_SMA | C2480
USB-C (power) | FJ1 | USB_C_Receptacle_HRO_TYPE-C-31-M-17_NoSilkOverPegs | C283540
