willbearfruits/samplooler/hardware/fab/samplooler-panel-stack-bom.csv

Comment | Designator | Footprint | LCSC Part #
100n | BC3,TC2,TC3 | C_0805_2012Metric | C49678
10u | BC1,BC2,TC1 | C_0805_2012Metric | C15850
