willbearfruits/samplooler/hardware/fab/samplooler-mini-bom.csv

Comment | Designator | Footprint | LCSC Part #
100n | C2,C3,C5 | C_0805_2012Metric | C49678
10u | C1,C4 | C_0805_2012Metric | C15850
