willbearfruits/samplooler/hardware/fab/samplooler-stack-bottom-bom.csv

Comment | Designator | Footprint | LCSC Part #
100n | C3 | C_0805_2012Metric | C49678
10u | C1,C2 | C_0805_2012Metric | C15850
