willbearfruits/samplooler/(list of files, cad)

Other CAD files:
enclosure/samplooler.scad
tools/showcase/parts.scad
