willbearfruits/samplooler/app/screenshots/build.png

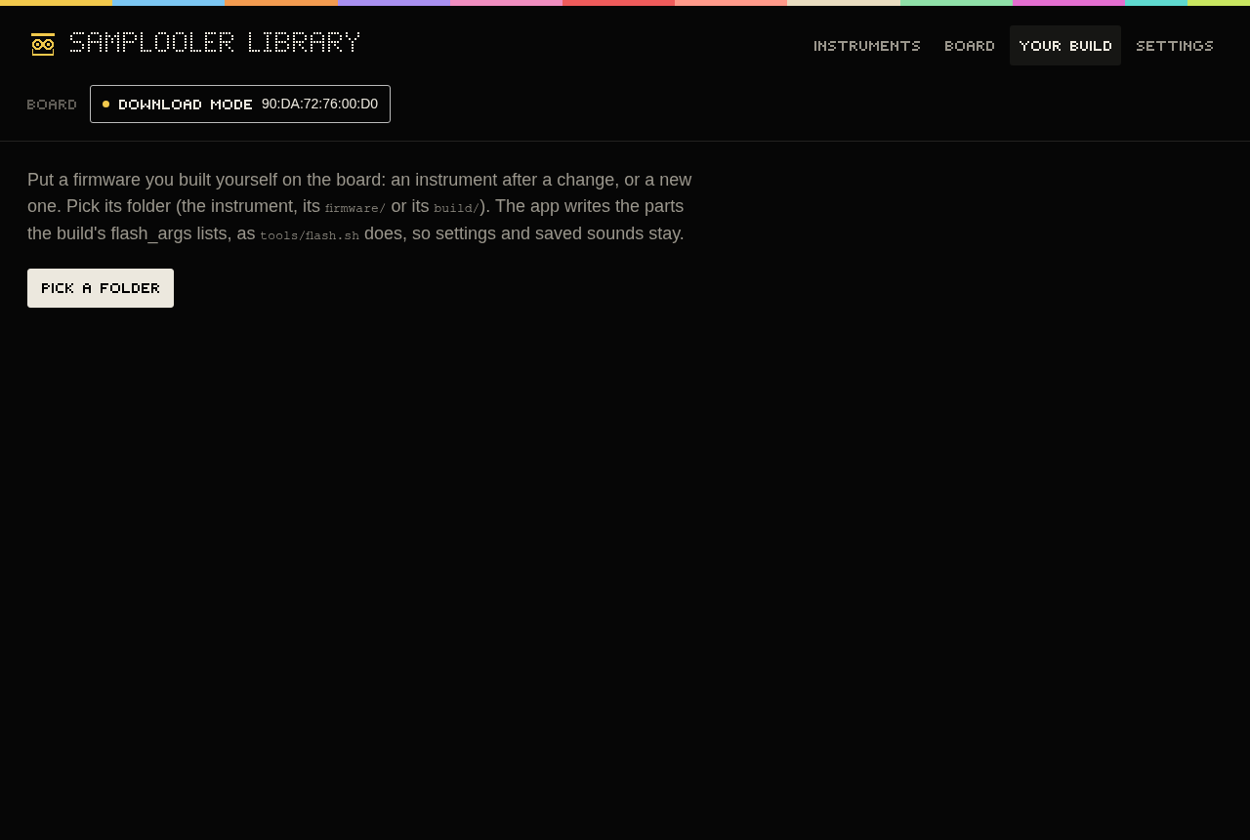
app/screenshots/build.png
