willbearfruits/samplooler/app/screenshots/install-error.png

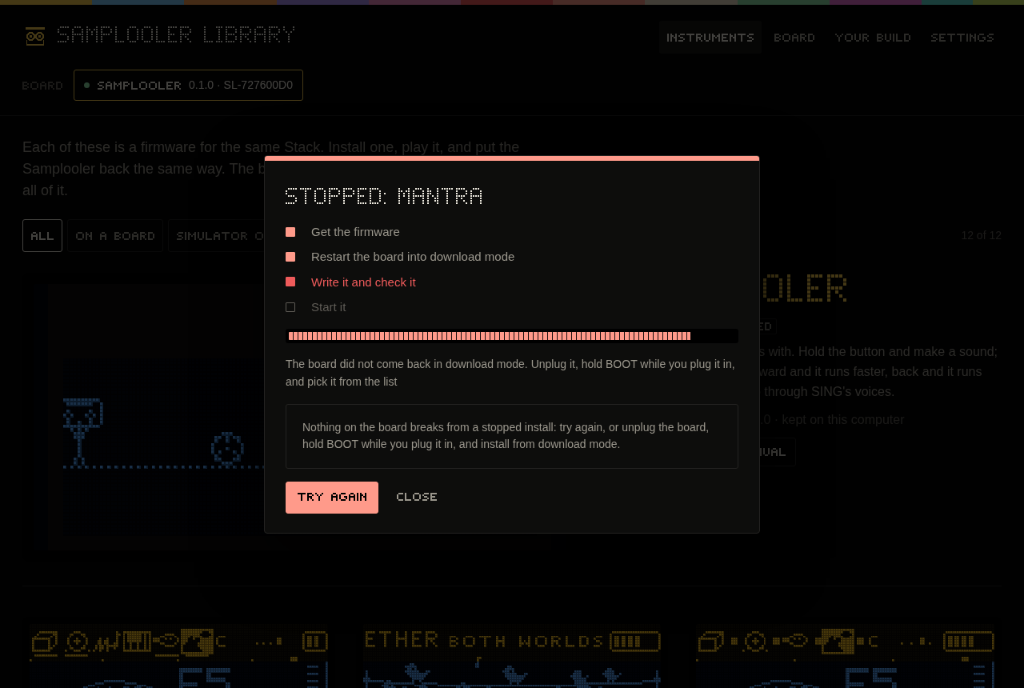
app/screenshots/install-error.png
