willbearfruits/samplooler/app/screenshots/install.png

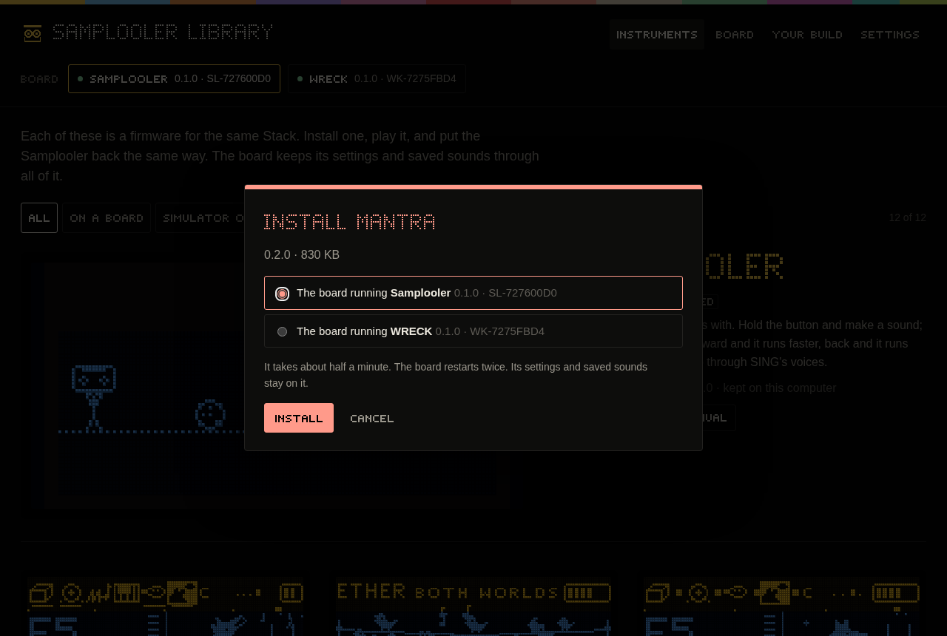
app/screenshots/install.png
