willbearfruits/samplooler/app/screenshots/installing.png

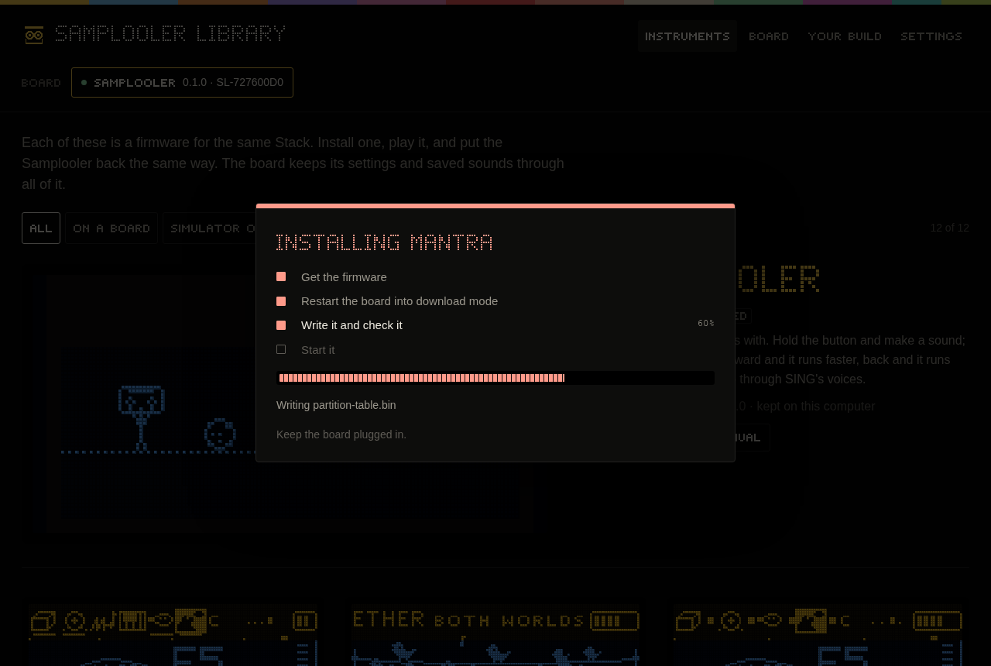
app/screenshots/installing.png
