willbearfruits/samplooler/app/screenshots/manual.png

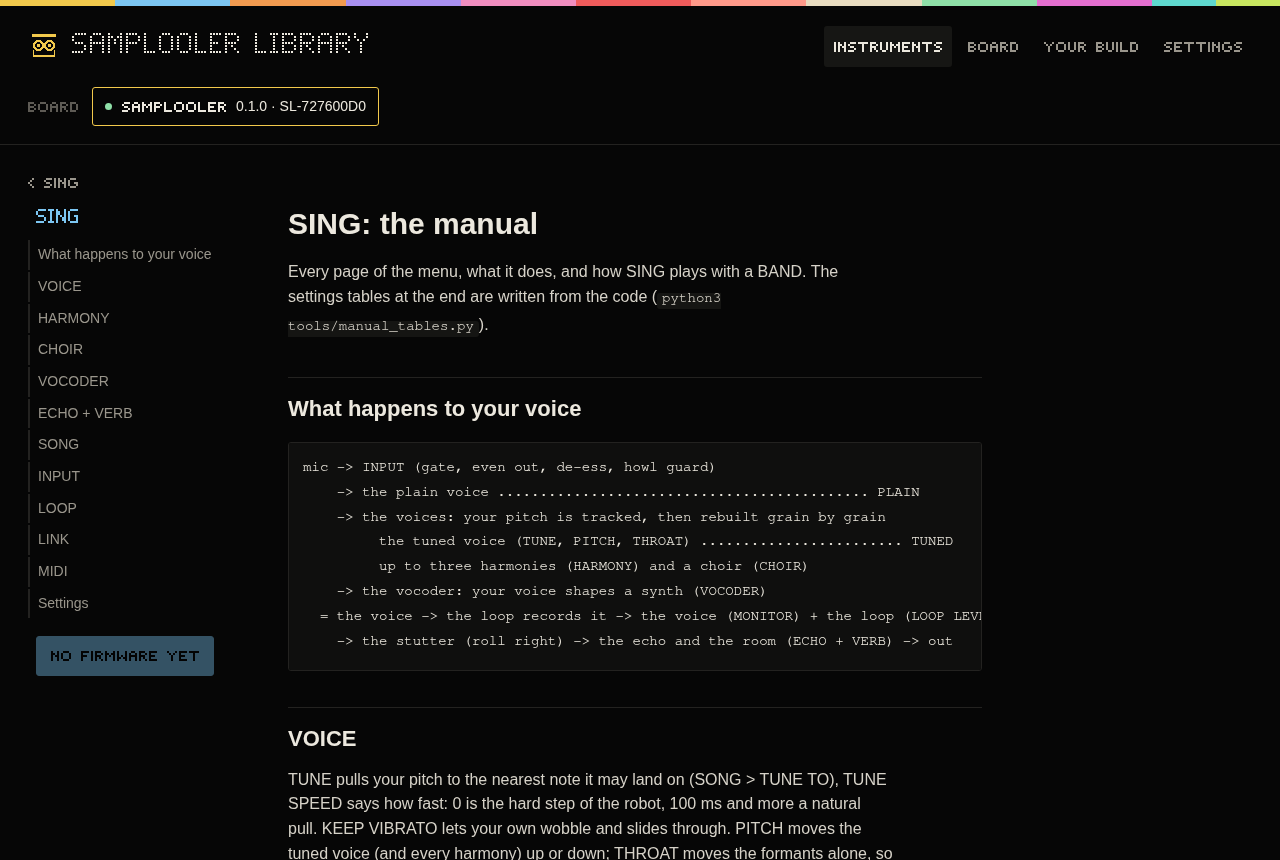
app/screenshots/manual.png
