willbearfruits/samplooler/enclosure/out/assembly.png

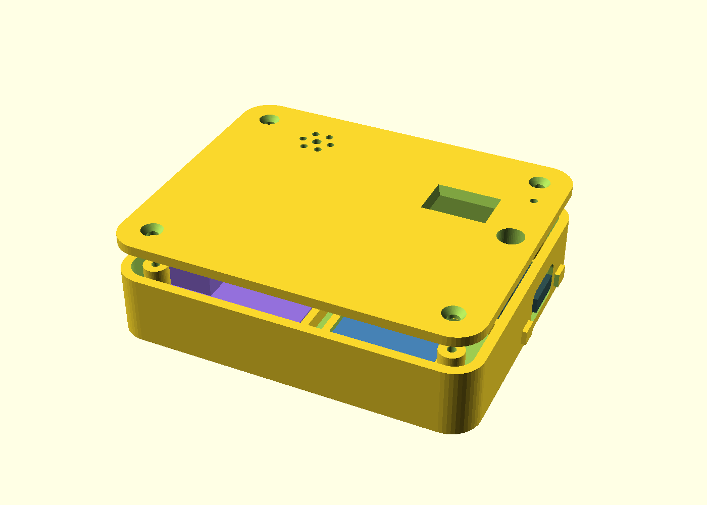
enclosure/out/assembly.png
