willbearfruits/samplooler/instruments/huff/images/breath-setup.gif

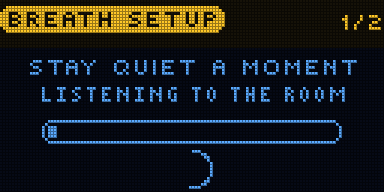
instruments/huff/images/breath-setup.gif
