willbearfruits/samplooler/hardware/fab/samplooler-stack-top-schematic.pdf

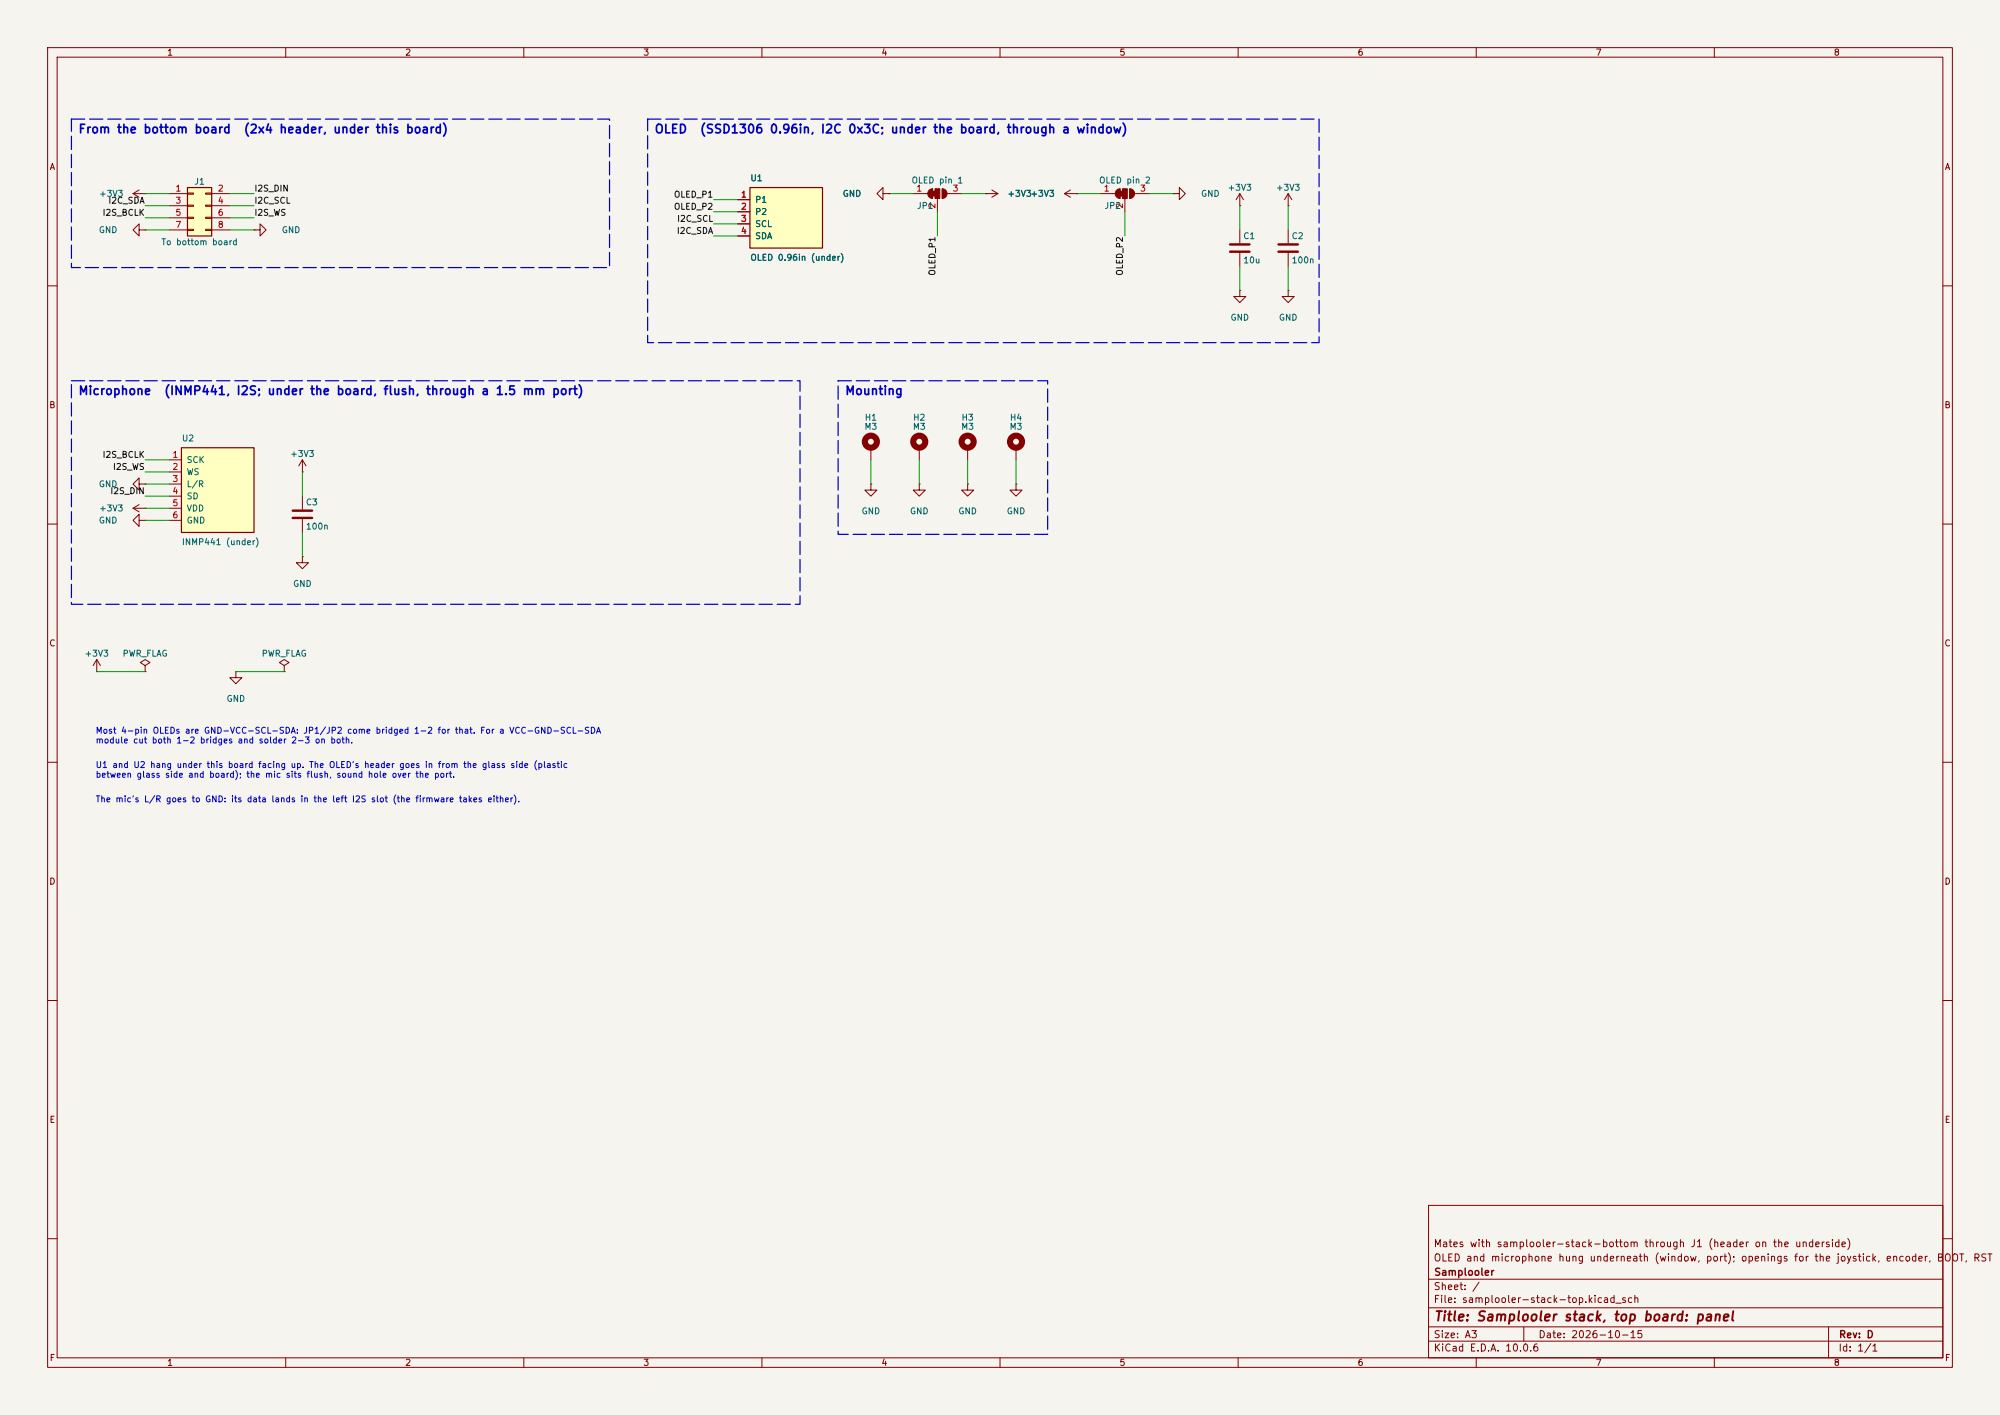
[picture p124: page 1]

Microphone (INMP441, I2S; under the board, flush, through a 1.5 mm port) Most 4-pin OLEDs are GND-VCC-SCL-SDA: JP1/JP2 come bridged 1-2 for that. For a VCC-GND-SCL-SDA module cut both 1-2 bridges and solder 2-3 on both. U1 and U2 hang under this board facing up. The OLED's header goes in from the glass side (plastic between glass side and board); the mic sits flush, sound hole over the port. The mic's L/R goes to GND: its data lands in the left I2S slot (the firmware takes either).

Mates with samplooler-stack-bottom through J1 (header on the underside)
OLED and microphone hung underneath (window, port); openings for the joystick, encoder, BOOT, RST
Samplooler
Sheet: /
File: samplooler-stack-top.kicad_sch
Title: Samplooler stack, top board: panel

Size: A3 | Rev: D | F Date: 2026-10-15
KiCad E.D.A. 10.0.6 | Id: 1/1
