willbearfruits/samplooler/hardware/fab/samplooler-mini-schematic.pdf

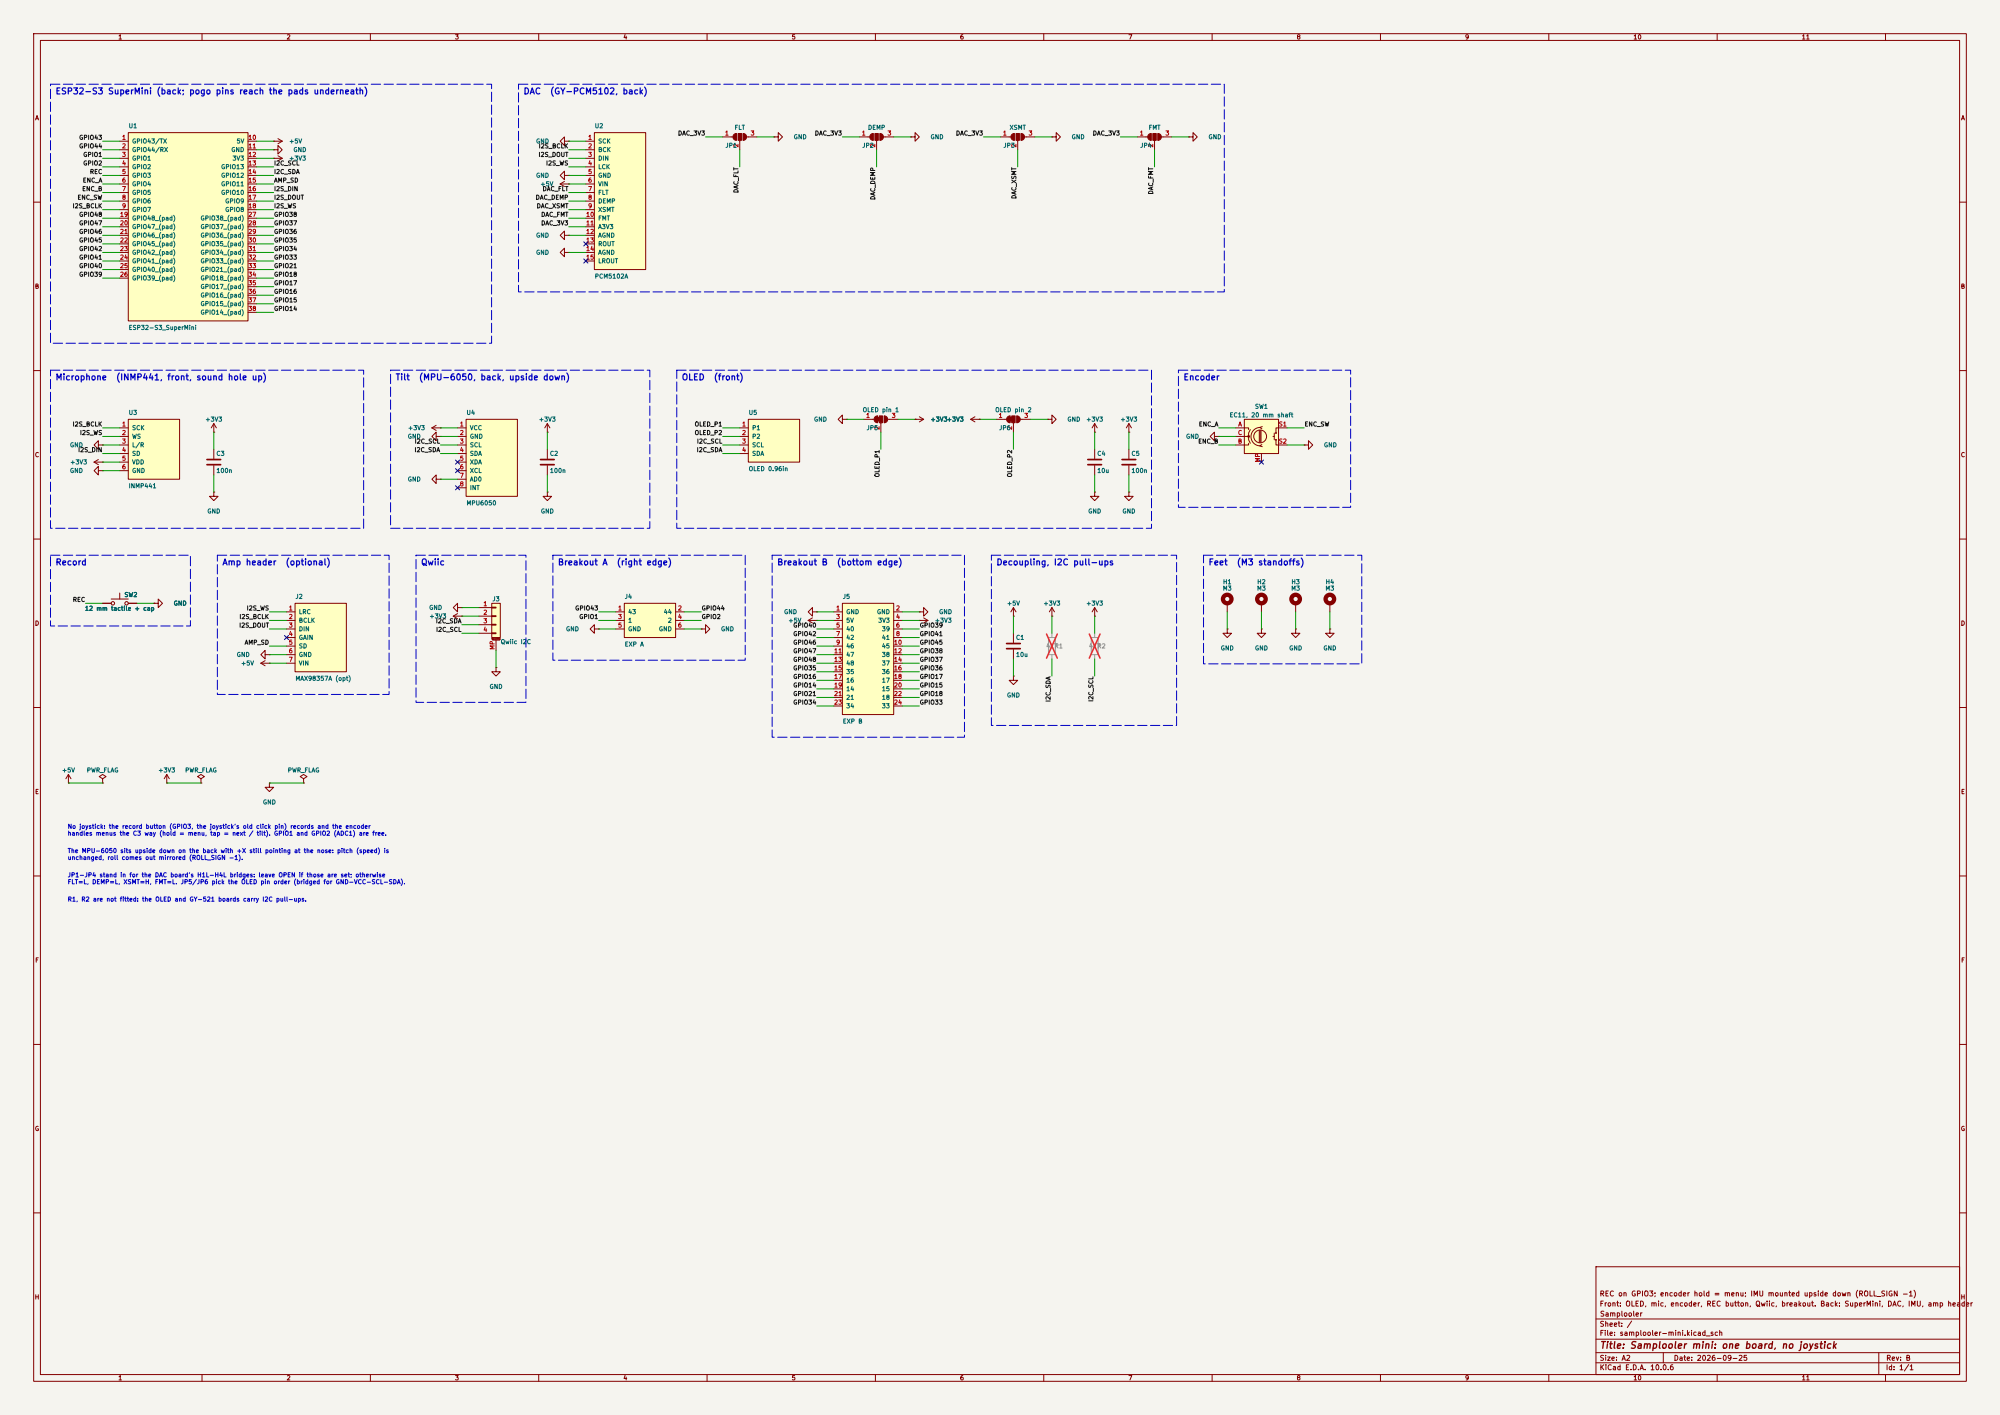
[picture p125: page 1]

Tilt (MPU-6050, back, upside down)

No joystick: the record button (GPIO3, the joystick's old click pin) records and the encoder handles menus the C3 way (hold = menu, tap = next / tilt). GPIO1 and GPIO2 (ADC1) are free. The MPU-6050 sits upside down on the back with +X still pointing at the nose: pitch (speed) is unchanged, roll comes out mirrored (ROLL_SIGN -1).

JP1-JP4 stand in for the DAC board's H1L-H4L bridges: leave OPEN if those are set; otherwise
FLT=L, DEMP=L, XSMT=H, FMT=L. JP5/JP6 pick the OLED pin order (bridged for GND-VCC-SCL-SDA).

R1, R2 are not fitted: the OLED and GY-521 boards carry I2C pull-ups.

REC on GPIO3; encoder hold = menu; IMU mounted upside down (ROLL_SIGN -1)
Front: OLED, mic, encoder, REC button, Qwiic, breakout. Back: SuperMini, DAC, IMU, amp header
Samplooler
Sheet: /
File: samplooler-mini.kicad_sch
Title: Samplooler mini: one board, no joystick

Size: A2 | Rev: B
KiCad E.D.A. 10.0.6 | Id: 1/1
