willbearfruits/samplooler/hardware/fab/samplooler-top-schematic.pdf

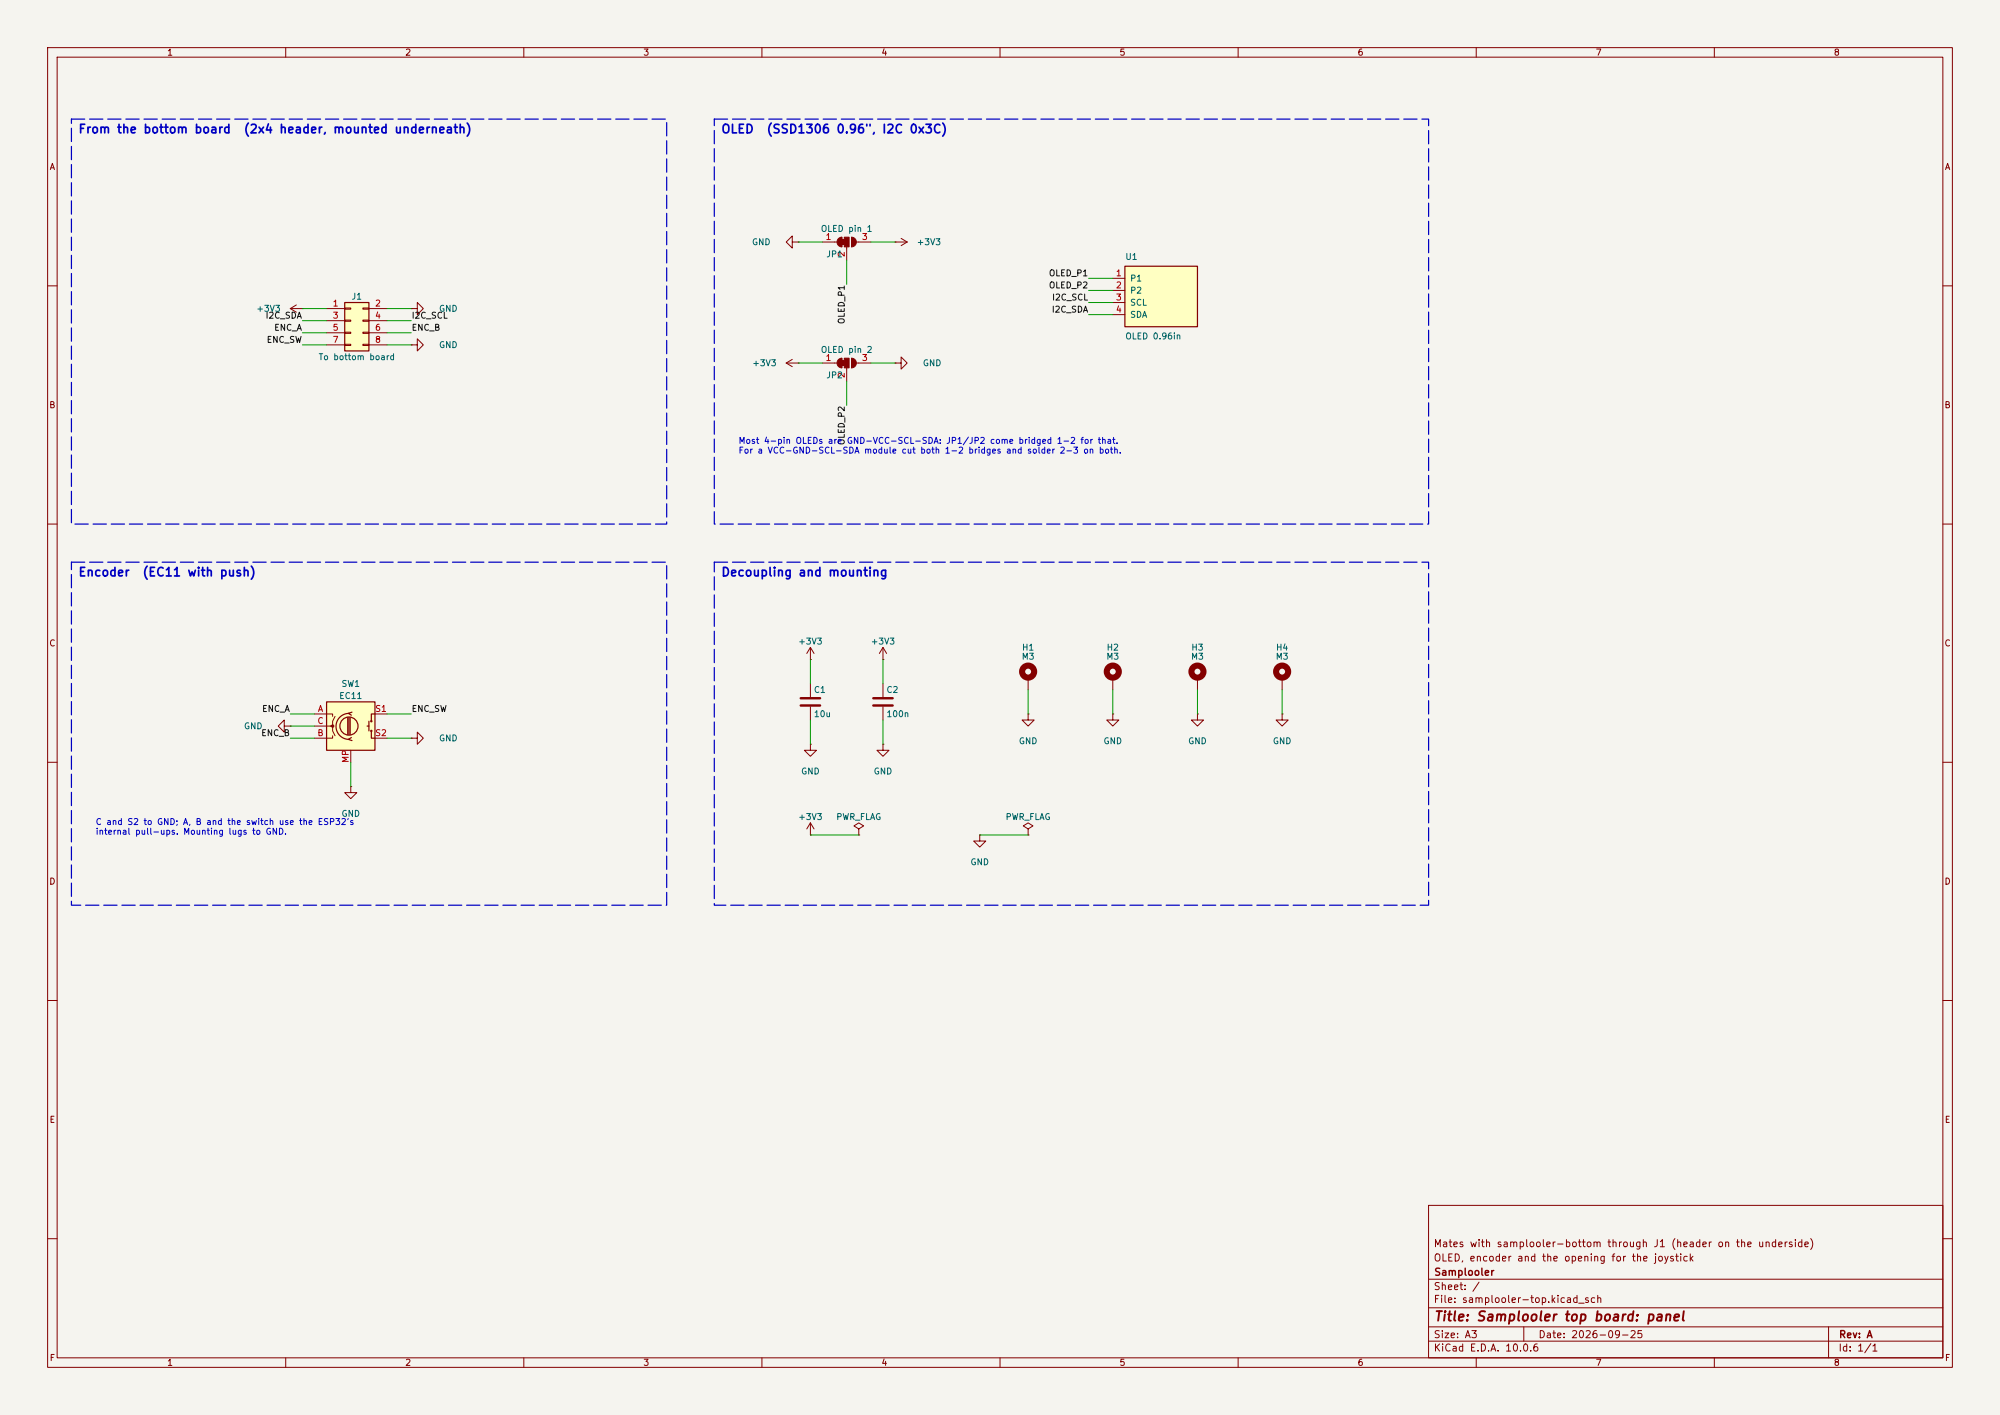
[picture p127: page 1]

internal pull-ups. Mounting lugs to GND. Encoder (EC11 with push)

C and S2 to GND; A, B and the switch use the ESP32's

Mates with samplooler-bottom through J1 (header on the underside)
OLED, encoder and the opening for the joystick
Samplooler
Sheet: /
File: samplooler-top.kicad_sch
Title: Samplooler top board: panel

Size: A3 | Rev: A | F Date: 2026-09-25
KiCad E.D.A. 10.0.6 | Id: 1/1
