willbearfruits/samplooler/hardware/stack-bottom/samplooler-stack-bottom.kicad_pcb

## KiCad design hardware/stack-bottom/samplooler-stack-bottom.kicad_pcb (2026-10-17)

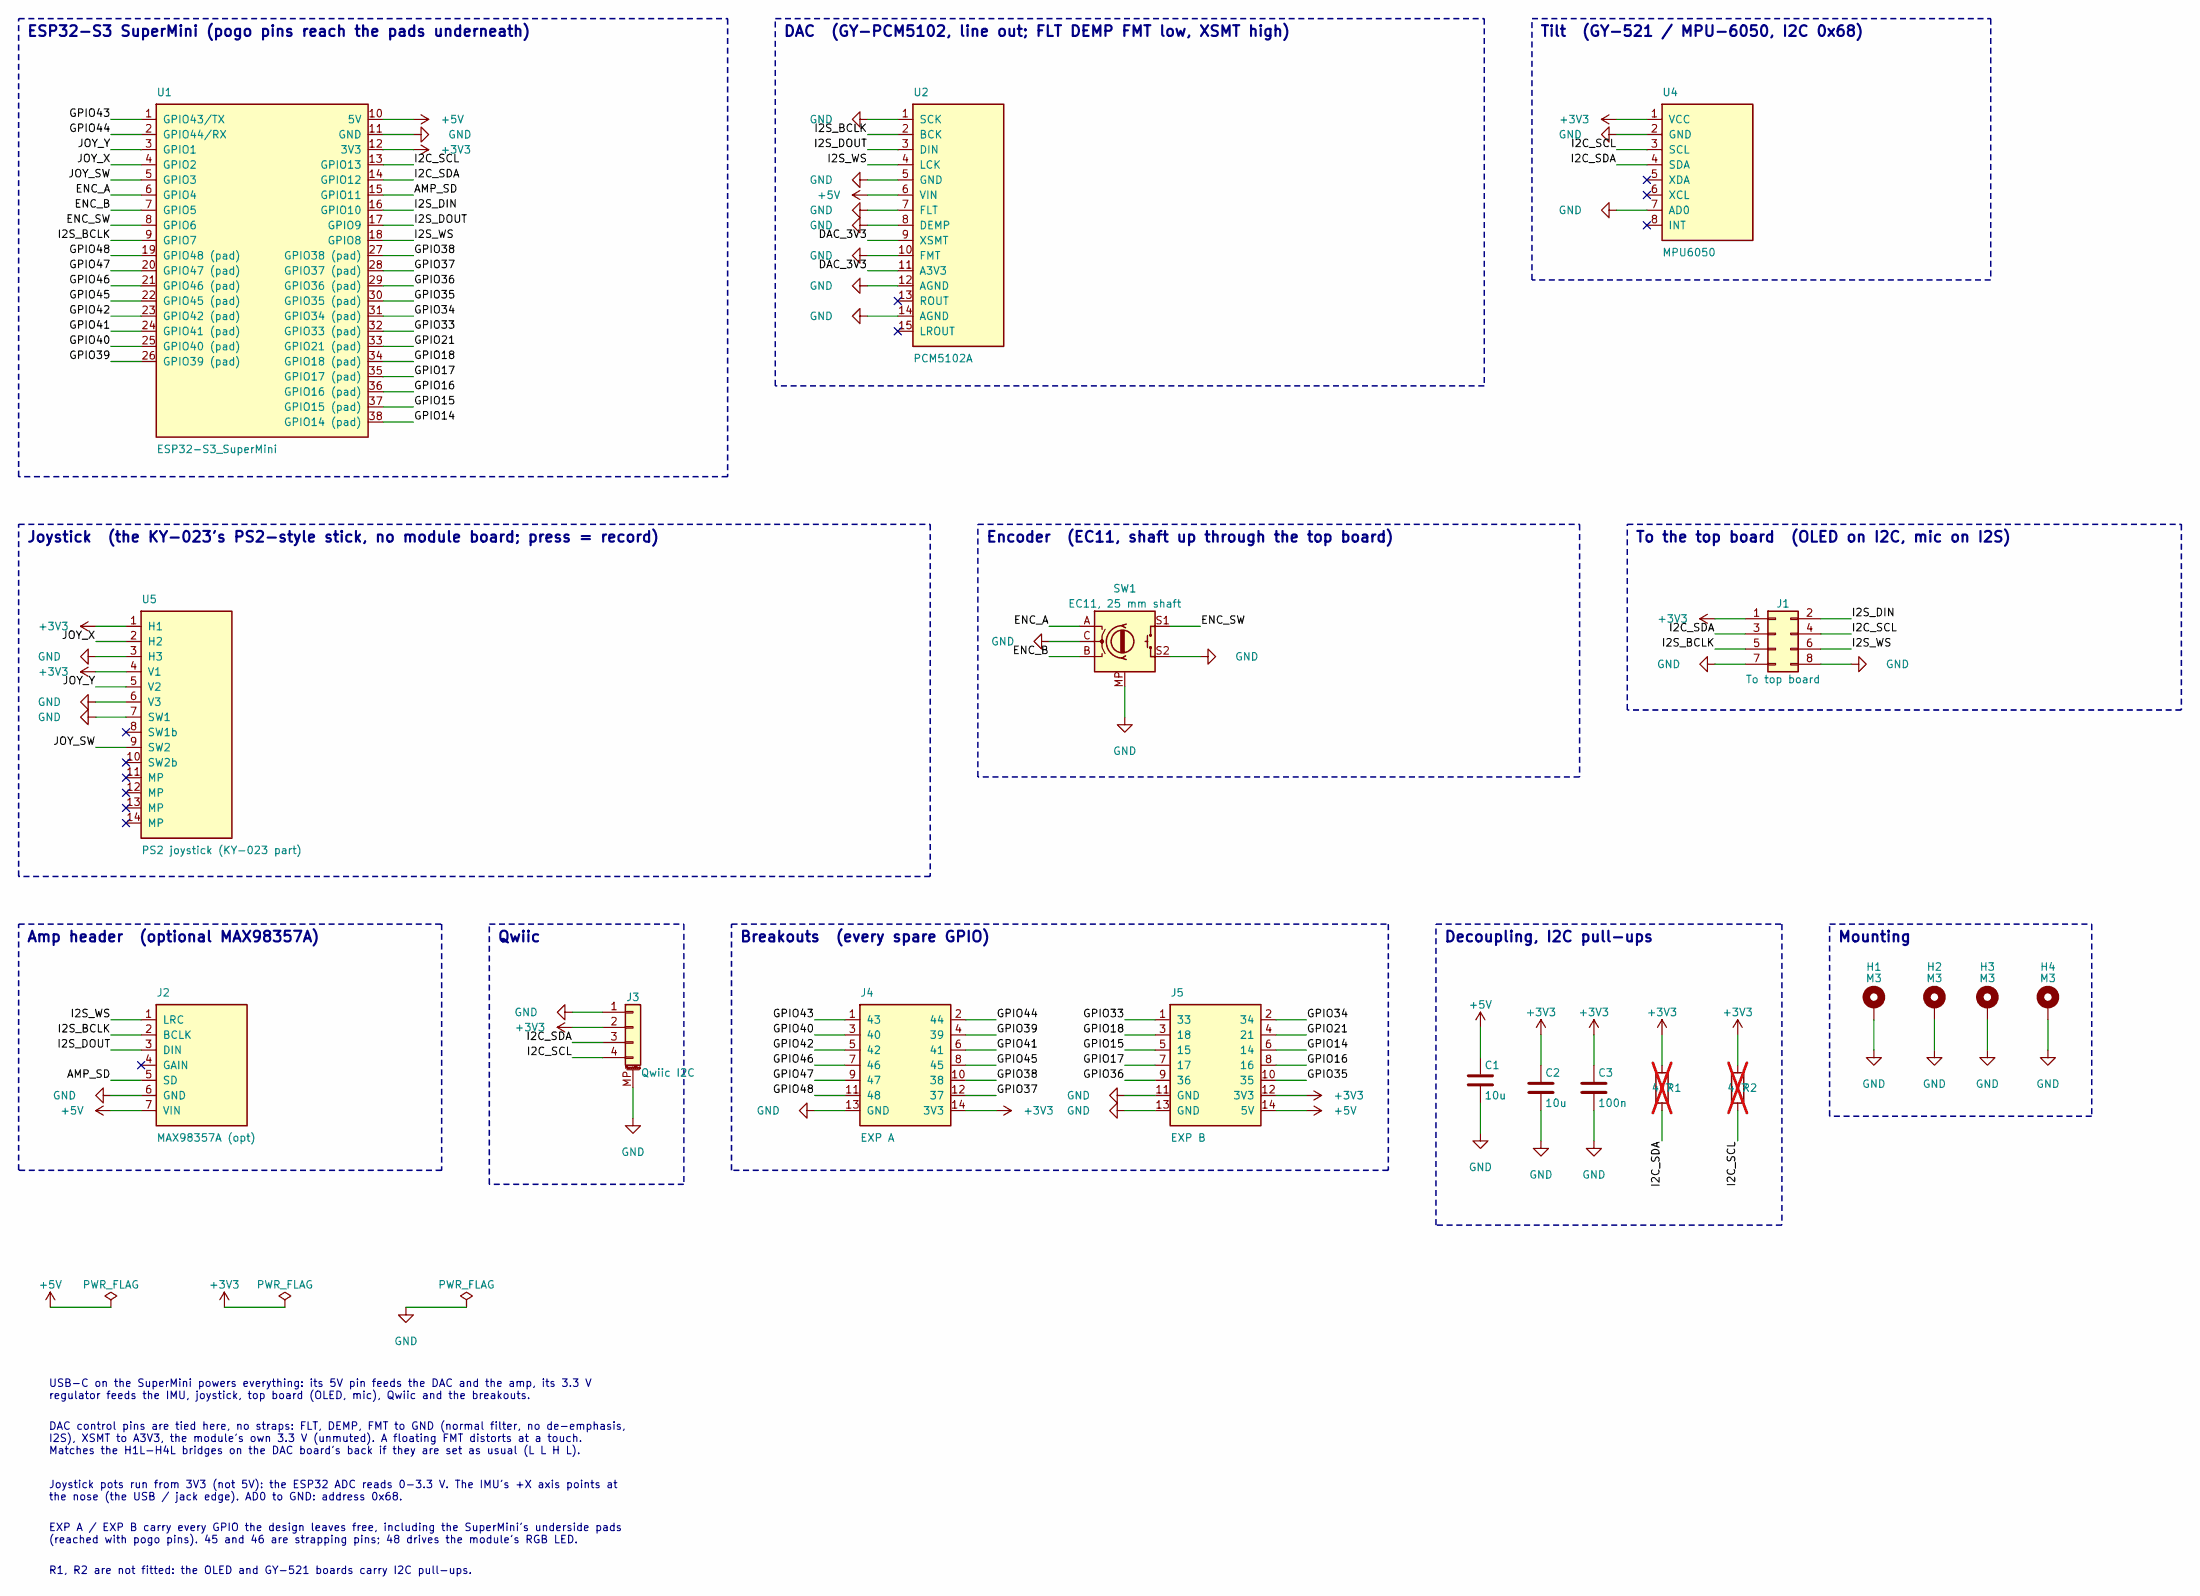
[picture p128: schematic samplooler-stack-bottom.kicad_sch, Samplooler stack, bottom board: modules]

Parts:
C1, C2: 10u; C_0805_2012Metric; LCSC C15850
C3: 100n; C_0805_2012Metric; LCSC C49678
H1, H2, H3, H4: M3; MountingHole_3.2mm_M3_Pad_Via
J1: To top board; PinSocket_2x04_P2.54mm_Vertical
J2: MAX98357A (opt); MAX98357A_Breakout
J3: Qwiic I2C; JST_SH_SM04B-SRSS-TB_1x04-1MP_P1.00mm_Horizontal
J4: EXP A; EXP_A_2x7_Stack
J5: EXP B; EXP_B_2x7_Stack
R1, R2: 4k7; R_0805_2012Metric; LCSC C17673; not fitted
SW1: EC11, 25 mm shaft; RotaryEncoder_Alps_EC11E-Switch_Vertical_H20mm
U1: ESP32-S3_SuperMini
U2: PCM5102A; GY-PCM5102
U4: MPU6050; GY-521_MPU6050
U5: PS2 joystick (KY-023 part); PS2_Joystick

Connections:
+3V3: C2.1, C3.1, J1.1, J3.2, J4.14 (3V3), J5.12 (3V3), R1.1, R2.1, U1.12 (3V3), U4.1 (VCC), U5.1 (H1), U5.4 (V1)
+5V: C1.1, J2.7 (VIN), J5.14 (5V), U1.10 (5V), U2.6 (VIN)
/AMP_SD: J2.5 (SD), U1.15 (11)
/DAC_3V3: U2.9 (XSMT), U2.11 (A3V3)
/ENC_A: SW1.A, U1.6 (4)
/ENC_B: SW1.B, U1.7 (5)
/ENC_SW: SW1.S1, U1.8 (6)
/GPIO14: J5.6 (14), U1.38 (GPIO14)
/GPIO15: J5.5 (15), U1.37 (GPIO15)
/GPIO16: J5.8 (16), U1.36 (GPIO16)
/GPIO17: J5.7 (17), U1.35 (GPIO17)
/GPIO18: J5.3 (18), U1.34 (GPIO18)
/GPIO21: J5.4 (21), U1.33 (GPIO21)
/GPIO33: J5.1 (33), U1.32 (GPIO33)
/GPIO34: J5.2 (34), U1.31 (GPIO34)
/GPIO35: J5.10 (35), U1.30 (GPIO35)
/GPIO36: J5.9 (36), U1.29 (GPIO36)
/GPIO37: J4.12 (37), U1.28 (GPIO37)
/GPIO38: J4.10 (38), U1.27 (GPIO38)
/GPIO39: J4.4 (39), U1.26 (GPIO39)
/GPIO40: J4.3 (40), U1.25 (GPIO40)
/GPIO41: J4.6 (41), U1.24 (GPIO41)
/GPIO42: J4.5 (42), U1.23 (GPIO42)
/GPIO43: J4.1 (43), U1.1 (TX)
/GPIO44: J4.2 (44), U1.2 (RX)
/GPIO45: J4.8 (45), U1.22 (GPIO45)
/GPIO46: J4.7 (46), U1.21 (GPIO46)
/GPIO47: J4.9 (47), U1.20 (GPIO47)
/GPIO48: J4.11 (48), U1.19 (GPIO48)
/I2C_SCL: J1.4, J3.4, R2.2, U1.13, U4.3 (SCL)
/I2C_SDA: J1.3, J3.3, R1.2, U1.14 (12), U4.4 (SDA)
/I2S_BCLK: J1.5, J2.2 (BCLK), U1.9 (7), U2.2 (BCK)
/I2S_DIN: J1.2, U1.16 (10)
/I2S_DOUT: J2.3 (DIN), U1.17 (9), U2.3 (DIN)
/I2S_WS: J1.6, J2.1 (LRC), U1.18 (8), U2.4 (LCK)
/JOY_SW: U1.5 (3), U5.9 (SW2)
/JOY_X: U1.4 (2), U5.2 (H2)
/JOY_Y: U1.3 (1), U5.5 (V2)
GND: C1.2, C2.2, C3.2, H1.1, H2.1, H3.1, H4.1, J1.7, J1.8, J2.6 (GND), J3.1, J3.MP (MountPin), J4.13 (GND), J5.11 (GND), J5.13 (GND), SW1.C, SW1.MP, SW1.S2, U1.11 (GND), U2.1 (SCK), U2.5 (GND), U2.7 (FLT), U2.8 (DEMP), U2.10 (FMT), U2.12 (AGND), U2.14 (AGND), U4.2 (GND), U4.7 (AD0), U5.3 (H3), U5.6 (V3), U5.7 (SW1)

Notes on the sheet:
ESP32-S3 SuperMini (pogo pins reach the pads underneath)
DAC (GY-PCM5102, line out; FLT DEMP FMT low, XSMT high)
Tilt (GY-521 / MPU-6050, I2C 0x68)
Joystick (the KY-023's PS2-style stick, no module board; press = record)
Encoder (EC11, shaft up through the top board)
To the top board (OLED on I2C, mic on I2S)
Amp header (optional MAX98357A)
Qwiic
Breakouts (every spare GPIO)
Decoupling, I2C pull-ups
Mounting
USB-C on the SuperMini powers everything: its 5V pin feeds the DAC and the amp, its 3.3 V regulator feeds the IMU, joystick, top board (OLED, mic), Qwiic and the breakouts.
DAC control pins are tied here, no straps: FLT, DEMP, FMT to GND (normal filter, no de-emphasis, I2S), XSMT to A3V3, the module's own 3.3 V (unmuted). A floating FMT distorts at a touch. Matches the H1L-H4L bridges on the DAC board's back if they are set as usual (L L H L).
Joystick pots run from 3V3 (not 5V): the ESP32 ADC reads 0-3.3 V. The IMU's +X axis points at the nose (the USB / jack edge). AD0 to GND: address 0x68.
EXP A / EXP B carry every GPIO the design leaves free, including the SuperMini's underside pads (reached with pogo pins). 45 and 46 are strapping pins; 48 drives the module's RGB LED.
R1, R2 are not fitted: the OLED and GY-521 boards carry I2C pull-ups.

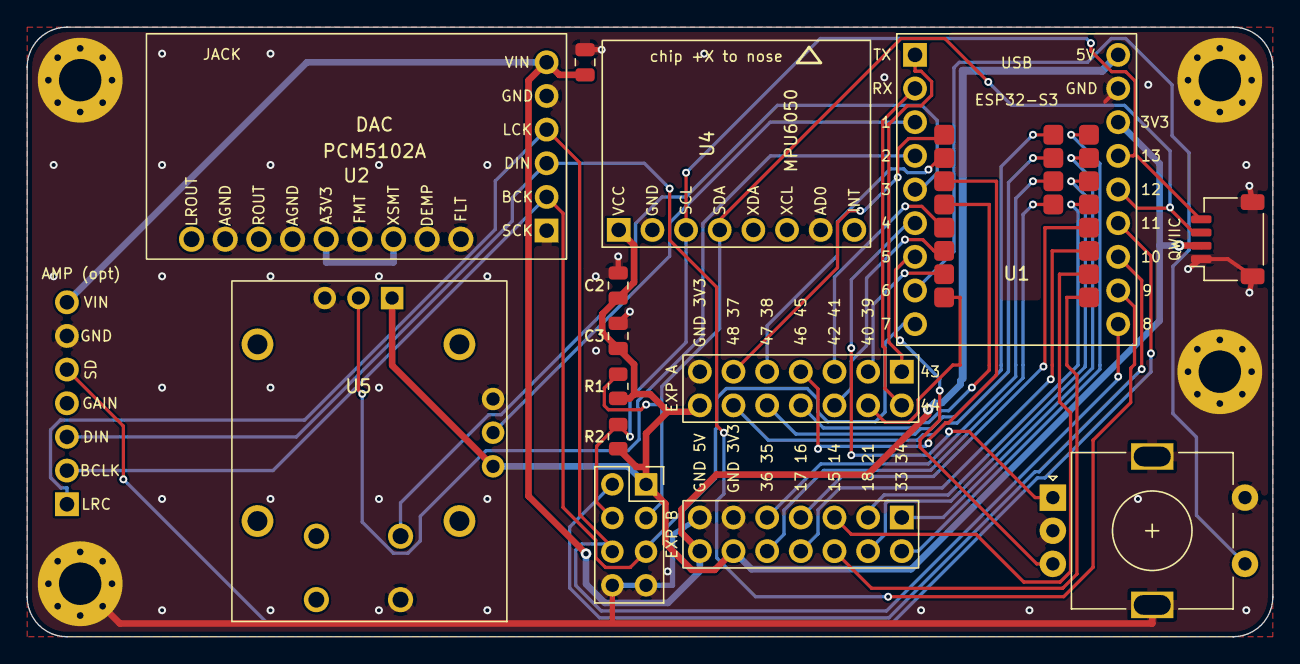
[picture p129: board samplooler-stack-bottom.kicad_pcb from above]

Board: 2 copper layers, 94.0 x 46.0 mm, 19 parts (0 on the bottom side), 39 nets.
