willbearfruits/samplooler/hardware/stack-top/samplooler-stack-top.kicad_pcb

## KiCad design hardware/stack-top/samplooler-stack-top.kicad_pcb (2026-10-17)

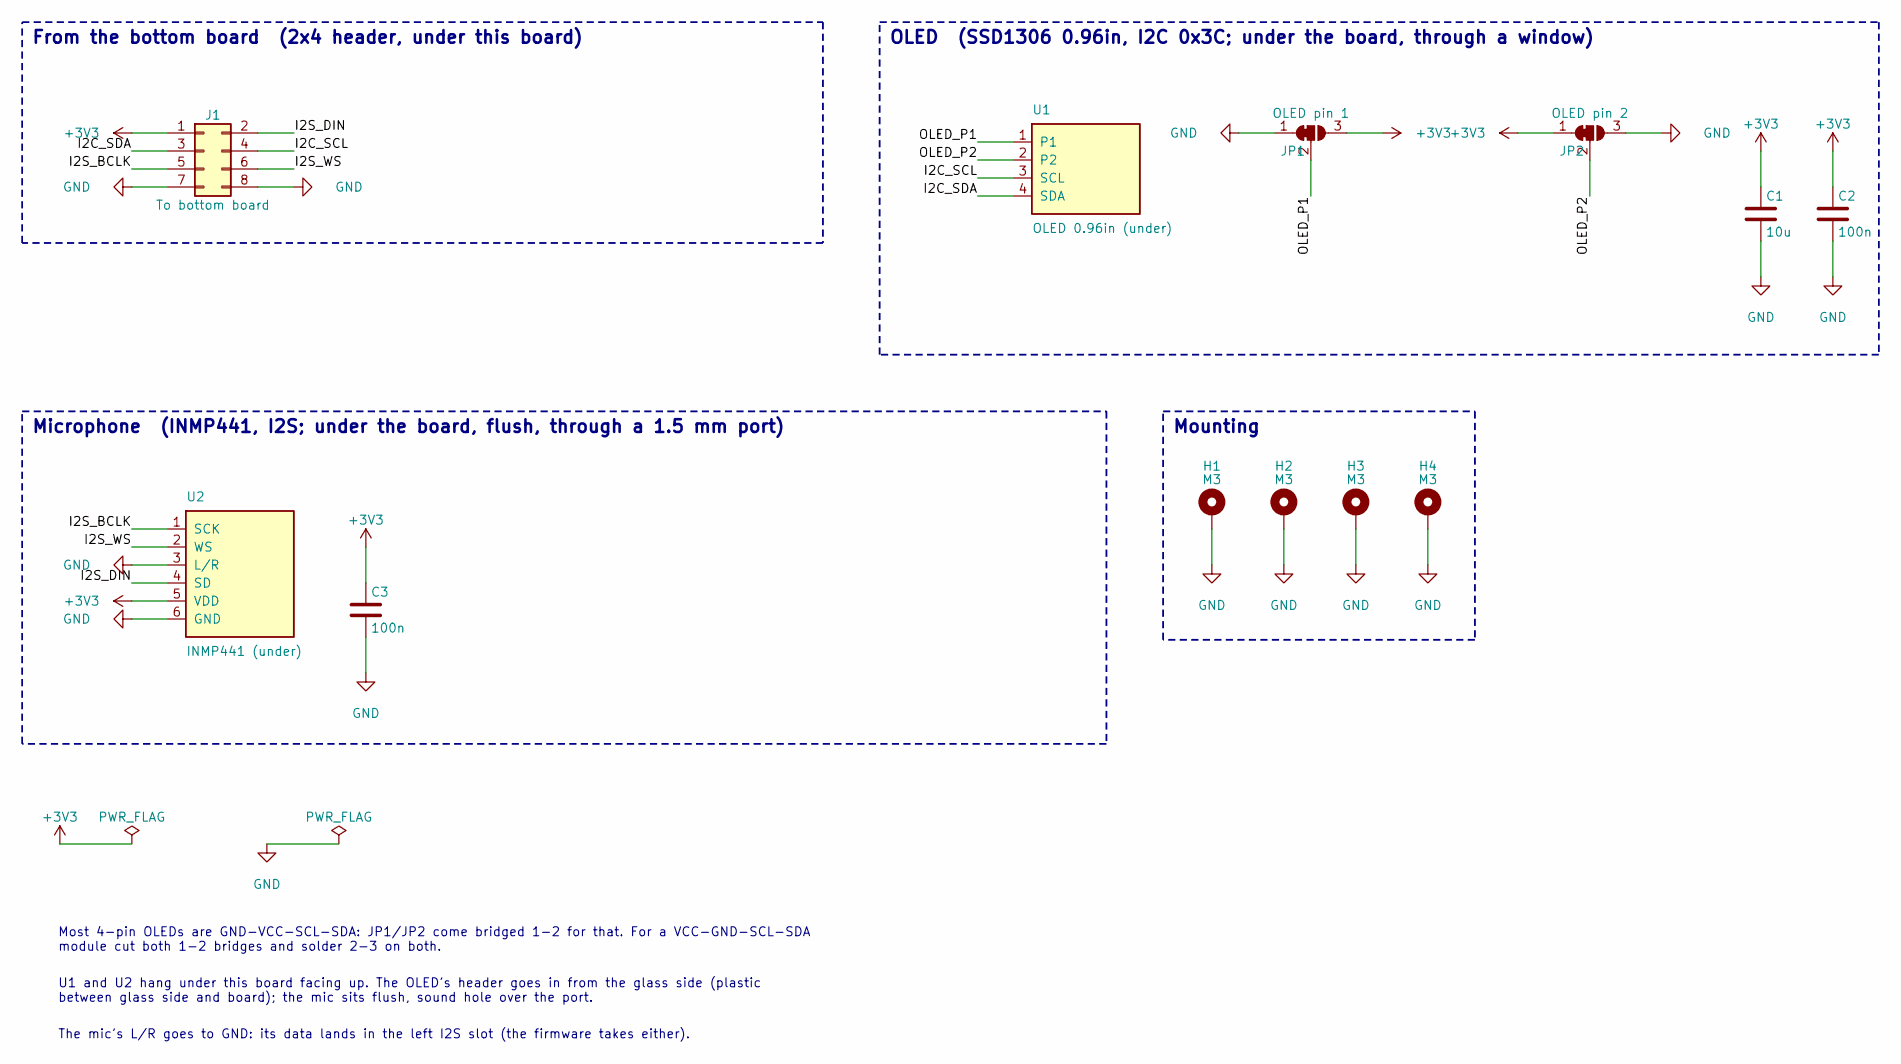
[picture p130: schematic samplooler-stack-top.kicad_sch, Samplooler stack, top board: panel]

Parts:
C1: 10u; C_0805_2012Metric; LCSC C15850
C2, C3: 100n; C_0805_2012Metric; LCSC C49678
H1, H2, H3, H4: M3; MountingHole_3.2mm_M3_Pad_Via
J1: To bottom board; PinHeader_2x04_P2.54mm_Vertical
JP1: OLED pin 1; SolderJumper-3_P1.3mm_Bridged12_RoundedPad1.0x1.5mm_NumberL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
JP2: OLED pin 2; SolderJumper-3_P1.3mm_Bridged12_RoundedPad1.0x1.5mm_NumberL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
U1: OLED 0.96in (under); SSD1306_0.96in_I2C_Under
U2: INMP441 (under); INMP441_Round_Under

Connections:
+3V3: C1.1, C2.1, C3.1, J1.1, JP1.3 (B), JP2.1 (A), U2.5 (VDD)
/I2C_SCL: J1.4, U1.3 (SCL)
/I2C_SDA: J1.3, U1.4 (SDA)
/I2S_BCLK: J1.5, U2.1 (SCK)
/I2S_DIN: J1.2, U2.4 (SD)
/I2S_WS: J1.6, U2.2 (WS)
/OLED_P1: JP1.2 (C), U1.1
/OLED_P2: JP2.2 (C), U1.2
GND: C1.2, C2.2, C3.2, H1.1, H2.1, H3.1, H4.1, J1.7, J1.8, JP1.1 (A), JP2.3 (B), U2.3 (L/R), U2.6 (GND)

Notes on the sheet:
From the bottom board (2x4 header, under this board)
OLED (SSD1306 0.96in, I2C 0x3C; under the board, through a window)
Microphone (INMP441, I2S; under the board, flush, through a 1.5 mm port)
Mounting
Most 4-pin OLEDs are GND-VCC-SCL-SDA: JP1/JP2 come bridged 1-2 for that. For a VCC-GND-SCL-SDA module cut both 1-2 bridges and solder 2-3 on both.
U1 and U2 hang under this board facing up. The OLED's header goes in from the glass side (plastic between glass side and board); the mic sits flush, sound hole over the port.
The mic's L/R goes to GND: its data lands in the left I2S slot (the firmware takes either).

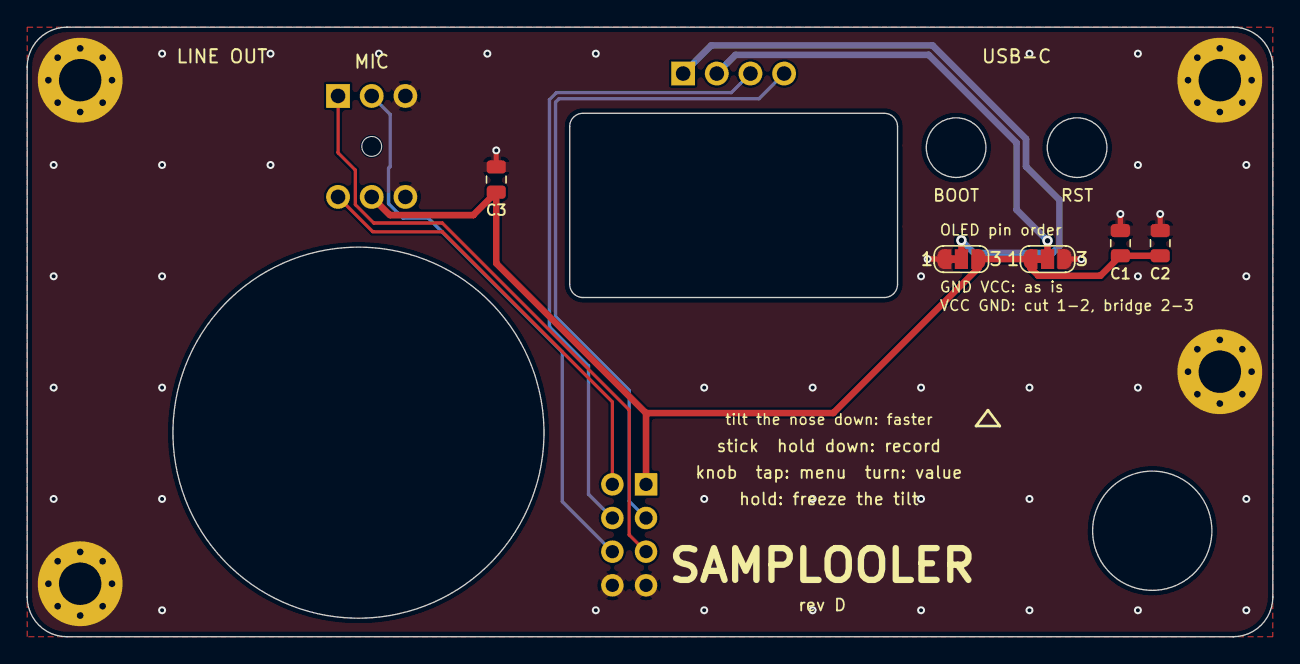
[picture p131: board samplooler-stack-top.kicad_pcb from above]

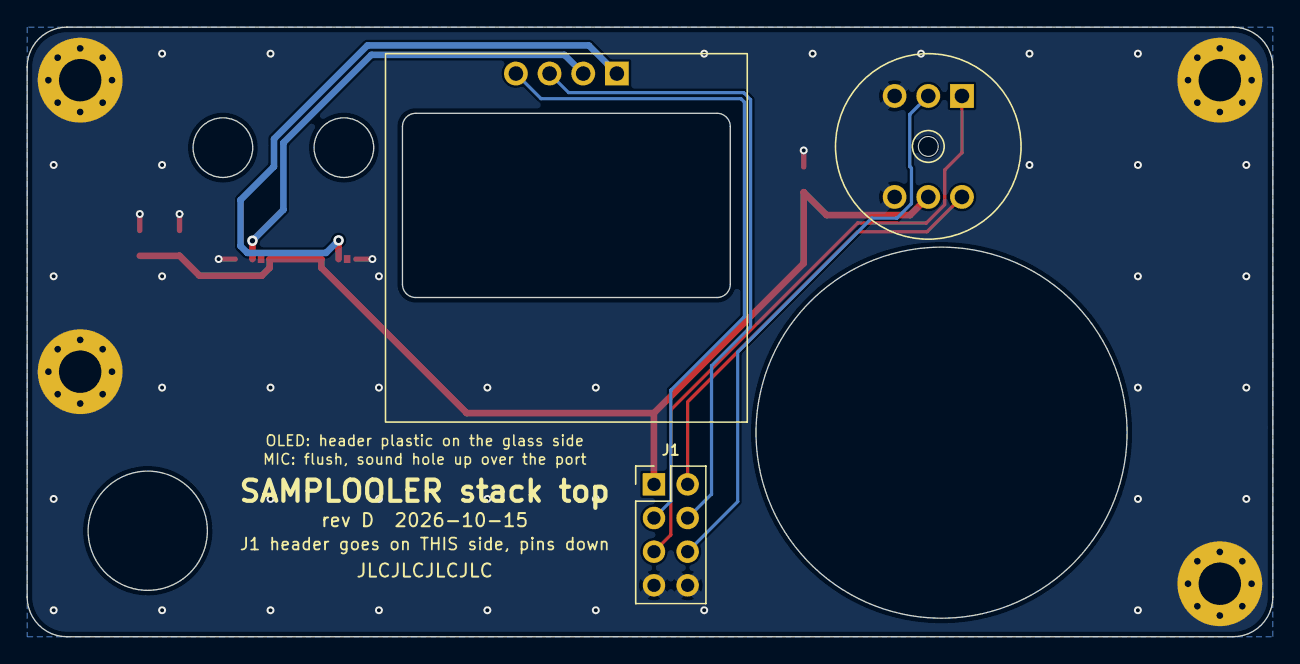
[picture p132: board samplooler-stack-top.kicad_pcb from below]

Board: 2 copper layers, 94.0 x 46.0 mm, 12 parts (3 on the bottom side), 9 nets.
