willbearfruits/samplooler/hardware/mini/samplooler-mini.kicad_pcb

## KiCad design hardware/mini/samplooler-mini.kicad_pcb (2026-09-25)

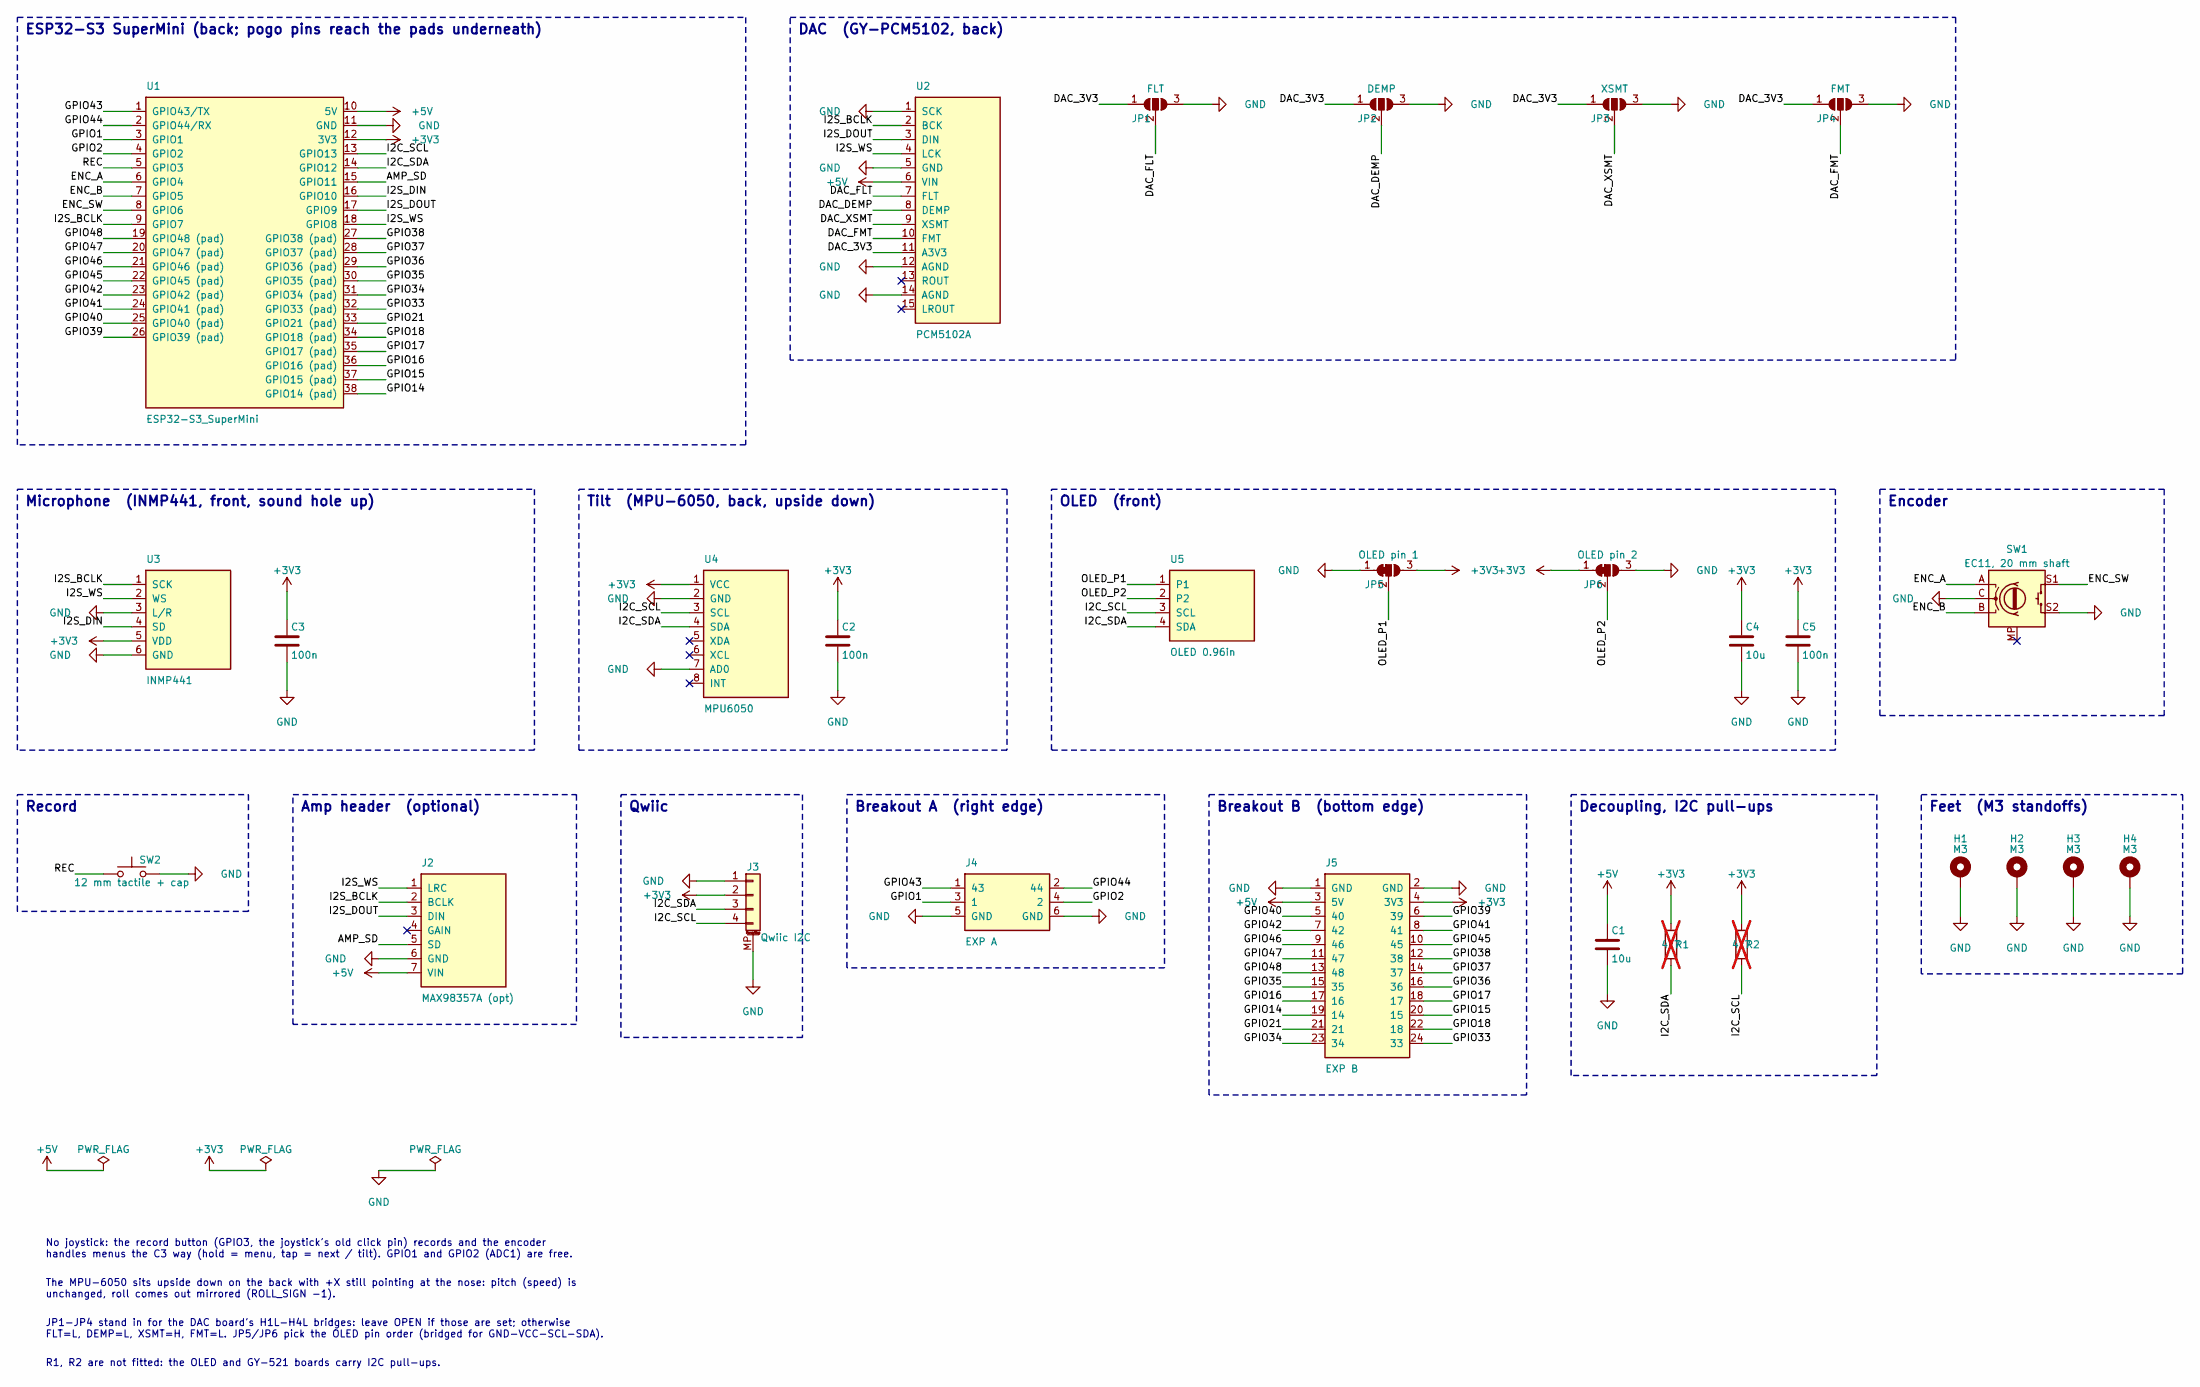
[picture p133: schematic samplooler-mini.kicad_sch, Samplooler mini: one board, no joystick]

Parts:
C1, C4: 10u; C_0805_2012Metric; LCSC C15850
C2, C3, C5: 100n; C_0805_2012Metric; LCSC C49678
H1, H2, H3, H4: M3; MountingHole_3.2mm_M3_Pad_Via
J2: MAX98357A (opt); MAX98357A_Breakout
J3: Qwiic I2C; JST_SH_SM04B-SRSS-TB_1x04-1MP_P1.00mm_Horizontal
J4: EXP A; EXP_A_2x3_Mini
J5: EXP B; EXP_B_2x12_Mini
JP1: FLT; SolderJumper-3_P1.3mm_Open_RoundedPad1.0x1.5mm
JP2: DEMP; SolderJumper-3_P1.3mm_Open_RoundedPad1.0x1.5mm
JP3: XSMT; SolderJumper-3_P1.3mm_Open_RoundedPad1.0x1.5mm
JP4: FMT; SolderJumper-3_P1.3mm_Open_RoundedPad1.0x1.5mm
JP5: OLED pin 1; SolderJumper-3_P1.3mm_Bridged12_RoundedPad1.0x1.5mm_NumberL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
JP6: OLED pin 2; SolderJumper-3_P1.3mm_Bridged12_RoundedPad1.0x1.5mm_NumberL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
R1, R2: 4k7; R_0805_2012Metric; LCSC C17673; not fitted
SW1: EC11, 20 mm shaft; RotaryEncoder_Alps_EC11E-Switch_Vertical_H20mm
SW2: 12 mm tactile + cap; SW_PUSH-12mm
U1: ESP32-S3_SuperMini
U2: PCM5102A; GY-PCM5102
U3: INMP441; INMP441_Round
U4: MPU6050; GY-521_MPU6050
U5: OLED 0.96in; SSD1306_0.96in_I2C_NoHoles

Connections:
+3V3: C2.1, C3.1, C4.1, C5.1, J3.2, J5.4 (3V3), JP5.3 (B), JP6.1 (A), R1.1, R2.1, U1.12 (3V3), U3.5 (VDD), U4.1 (VCC)
+5V: C1.1, J2.7 (VIN), J5.3 (5V), U1.10 (5V), U2.6 (VIN)
/AMP_SD: J2.5 (SD), U1.15 (11)
/DAC_3V3: JP1.1 (A), JP2.1 (A), JP3.1 (A), JP4.1 (A), U2.11 (A3V3)
/DAC_DEMP: JP2.2 (C), U2.8 (DEMP)
/DAC_FLT: JP1.2 (C), U2.7 (FLT)
/DAC_FMT: JP4.2 (C), U2.10 (FMT)
/DAC_XSMT: JP3.2 (C), U2.9 (XSMT)
/ENC_A: SW1.A, U1.6 (4)
/ENC_B: SW1.B, U1.7 (5)
/ENC_SW: SW1.S1, U1.8 (6)
/GPIO1: J4.3 (1), U1.3 (1)
/GPIO2: J4.4 (2), U1.4 (2)
/GPIO14: J5.19 (14), U1.38 (GPIO14)
/GPIO15: J5.20 (15), U1.37 (GPIO15)
/GPIO16: J5.17 (16), U1.36 (GPIO16)
/GPIO17: J5.18 (17), U1.35 (GPIO17)
/GPIO18: J5.22 (18), U1.34 (GPIO18)
/GPIO21: J5.21, U1.33 (GPIO21)
/GPIO33: J5.24 (33), U1.32 (GPIO33)
/GPIO34: J5.23 (34), U1.31 (GPIO34)
/GPIO35: J5.15 (35), U1.30 (GPIO35)
/GPIO36: J5.16 (36), U1.29 (GPIO36)
/GPIO37: J5.14 (37), U1.28 (GPIO37)
/GPIO38: J5.12 (38), U1.27 (GPIO38)
/GPIO39: J5.6 (39), U1.26 (GPIO39)
/GPIO40: J5.5 (40), U1.25 (GPIO40)
/GPIO41: J5.8 (41), U1.24 (GPIO41)
/GPIO42: J5.7 (42), U1.23 (GPIO42)
/GPIO43: J4.1 (43), U1.1 (TX)
/GPIO44: J4.2 (44), U1.2 (RX)
/GPIO45: J5.10 (45), U1.22 (GPIO45)
/GPIO46: J5.9 (46), U1.21 (GPIO46)
/GPIO47: J5.11 (47), U1.20 (GPIO47)
/GPIO48: J5.13 (48), U1.19 (GPIO48)
/I2C_SCL: J3.4, R2.2, U1.13, U4.3 (SCL), U5.3 (SCL)
/I2C_SDA: J3.3, R1.2, U1.14 (12), U4.4 (SDA), U5.4 (SDA)
/I2S_BCLK: J2.2 (BCLK), U1.9 (7), U2.2 (BCK), U3.1 (SCK)
/I2S_DIN: U1.16 (10), U3.4 (SD)
/I2S_DOUT: J2.3 (DIN), U1.17 (9), U2.3 (DIN)
/I2S_WS: J2.1 (LRC), U1.18 (8), U2.4 (LCK), U3.2 (WS)
/OLED_P1: JP5.2 (C), U5.1
/OLED_P2: JP6.2 (C), U5.2
/REC: SW2.1, U1.5 (3)
GND: C1.2, C2.2, C3.2, C4.2, C5.2, H1.1, H2.1, H3.1, H4.1, J2.6 (GND), J3.1, J3.MP (MountPin), J4.5 (GND), J4.6 (GND), J5.1 (GND), J5.2 (GND), JP1.3 (B), JP2.3 (B), JP3.3 (B), JP4.3 (B), JP5.1 (A), JP6.3 (B), SW1.C, SW1.S2, SW2.2, U1.11 (GND), U2.1 (SCK), U2.5 (GND), U2.12 (AGND), U2.14 (AGND), U3.3 (L/R), U3.6 (GND), U4.2 (GND), U4.7 (AD0)

Notes on the sheet:
ESP32-S3 SuperMini (back; pogo pins reach the pads underneath)
DAC (GY-PCM5102, back)
Microphone (INMP441, front, sound hole up)
Tilt (MPU-6050, back, upside down)
OLED (front)
Encoder
Record
Amp header (optional)
Qwiic
Breakout A (right edge)
Breakout B (bottom edge)
Decoupling, I2C pull-ups
Feet (M3 standoffs)
No joystick: the record button (GPIO3, the joystick's old click pin) records and the encoder handles menus the C3 way (hold = menu, tap = next / tilt). GPIO1 and GPIO2 (ADC1) are free.
The MPU-6050 sits upside down on the back with +X still pointing at the nose: pitch (speed) is unchanged, roll comes out mirrored (ROLL_SIGN -1).
JP1-JP4 stand in for the DAC board's H1L-H4L bridges: leave OPEN if those are set; otherwise FLT=L, DEMP=L, XSMT=H, FMT=L. JP5/JP6 pick the OLED pin order (bridged for GND-VCC-SCL-SDA).
R1, R2 are not fitted: the OLED and GY-521 boards carry I2C pull-ups.

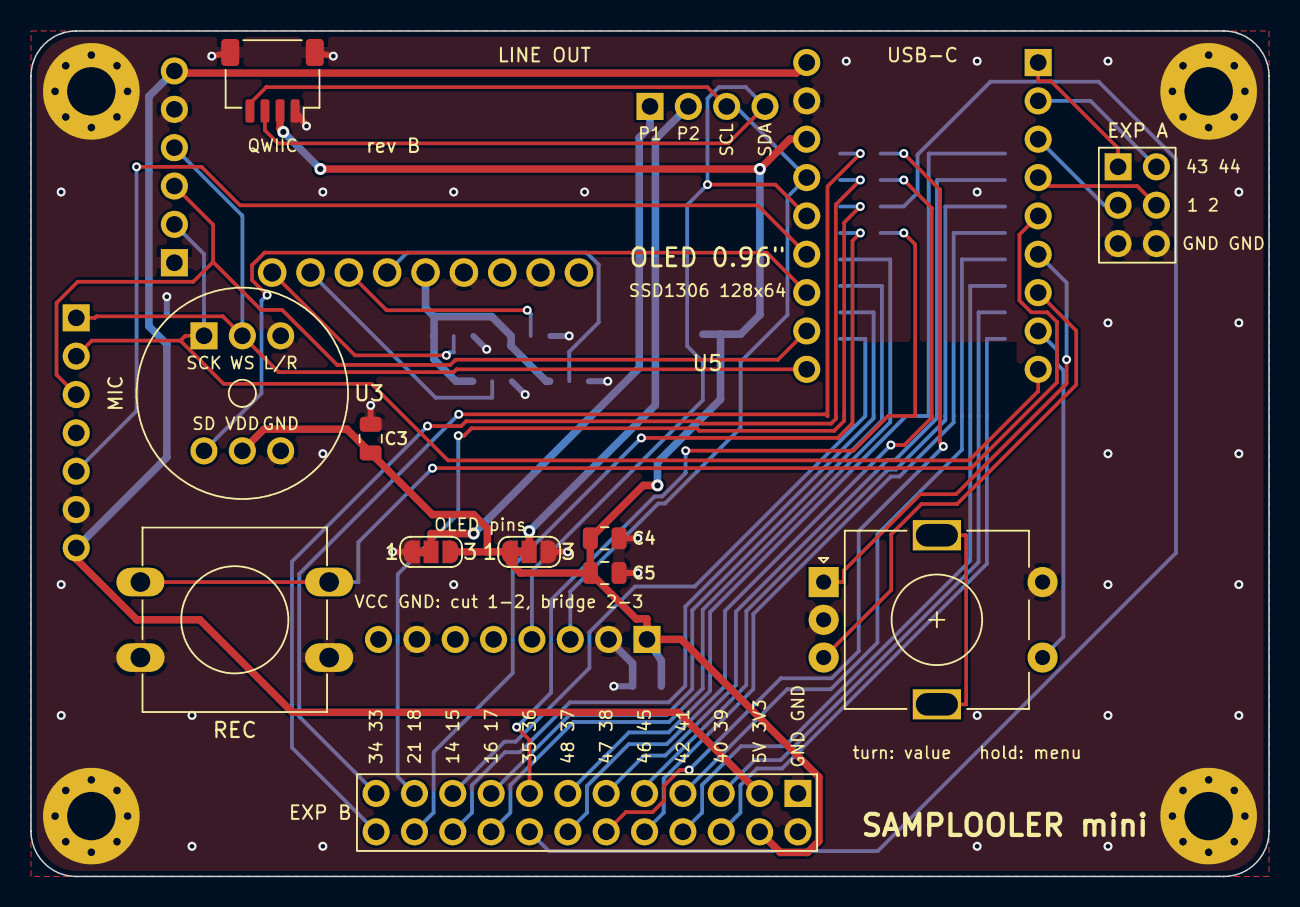
[picture p134: board samplooler-mini.kicad_pcb from above]

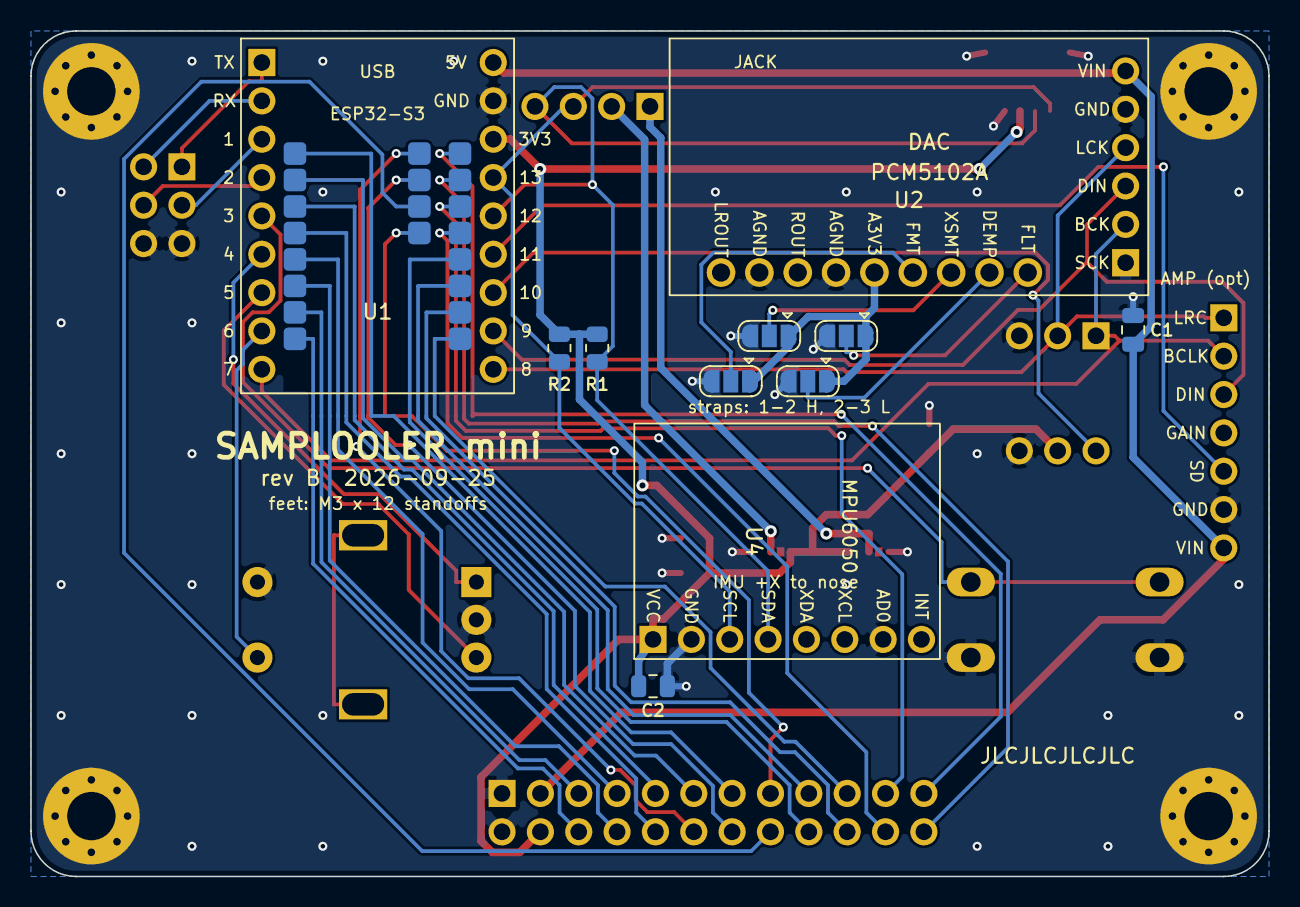
[picture p135: board samplooler-mini.kicad_pcb from below]

Board: 2 copper layers, 82.0 x 56.0 mm, 28 parts (12 on the bottom side), 45 nets.
