willbearfruits/samplooler/hardware/panel-mini/samplooler-panel-mini.kicad_pcb

## KiCad design hardware/panel-mini/samplooler-panel-mini.kicad_pcb (2026-10-08)

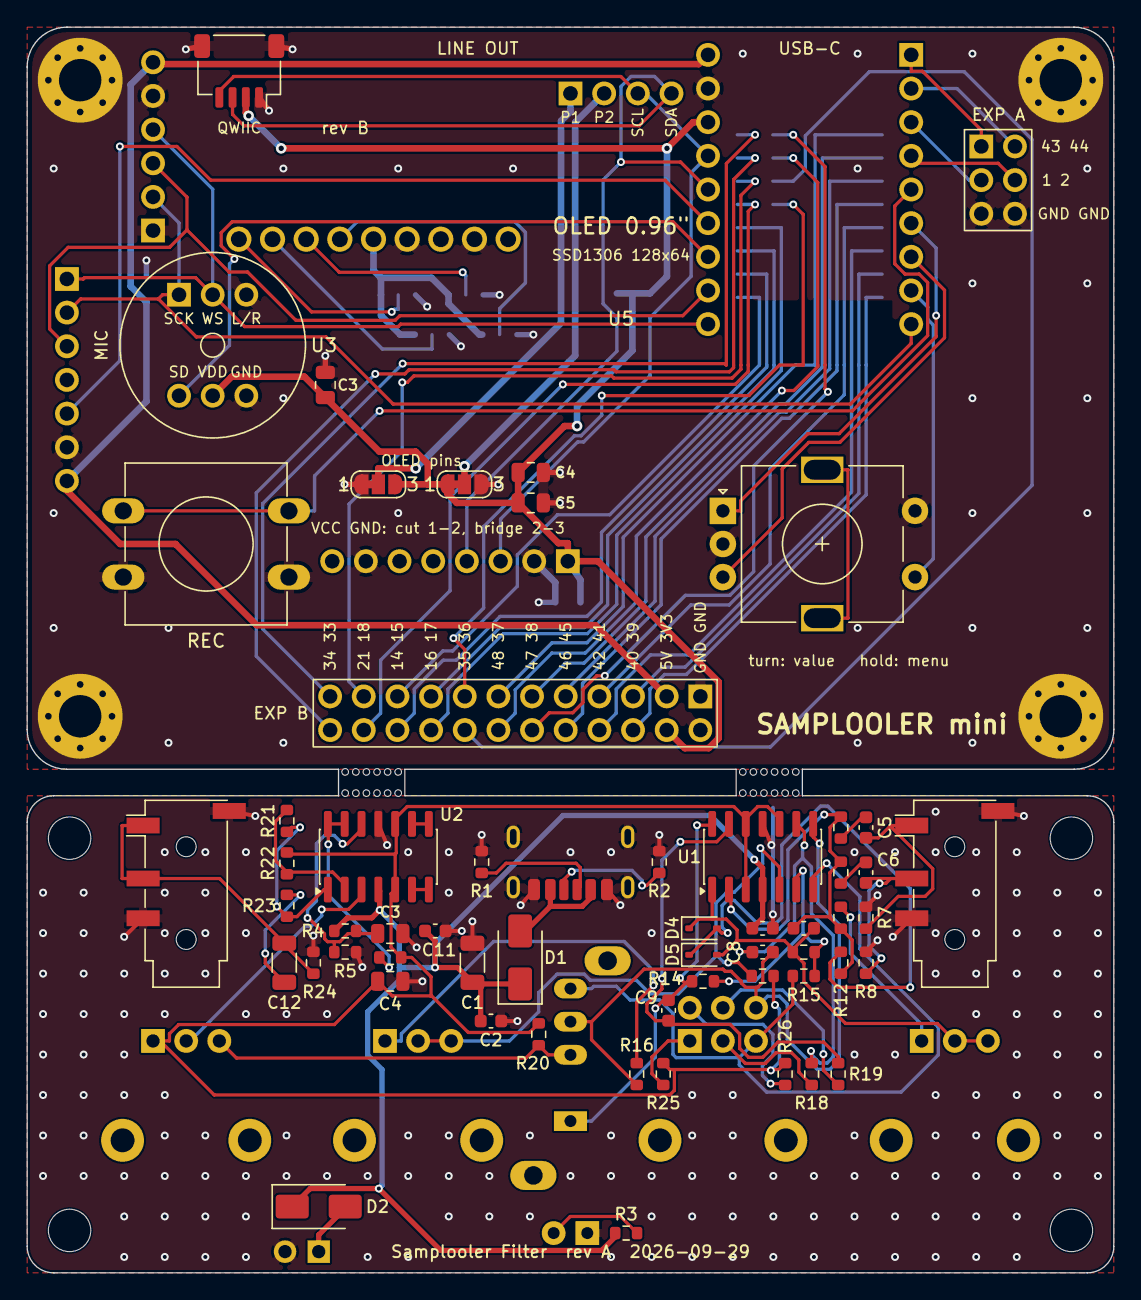
[picture p136: board samplooler-panel-mini.kicad_pcb from above]

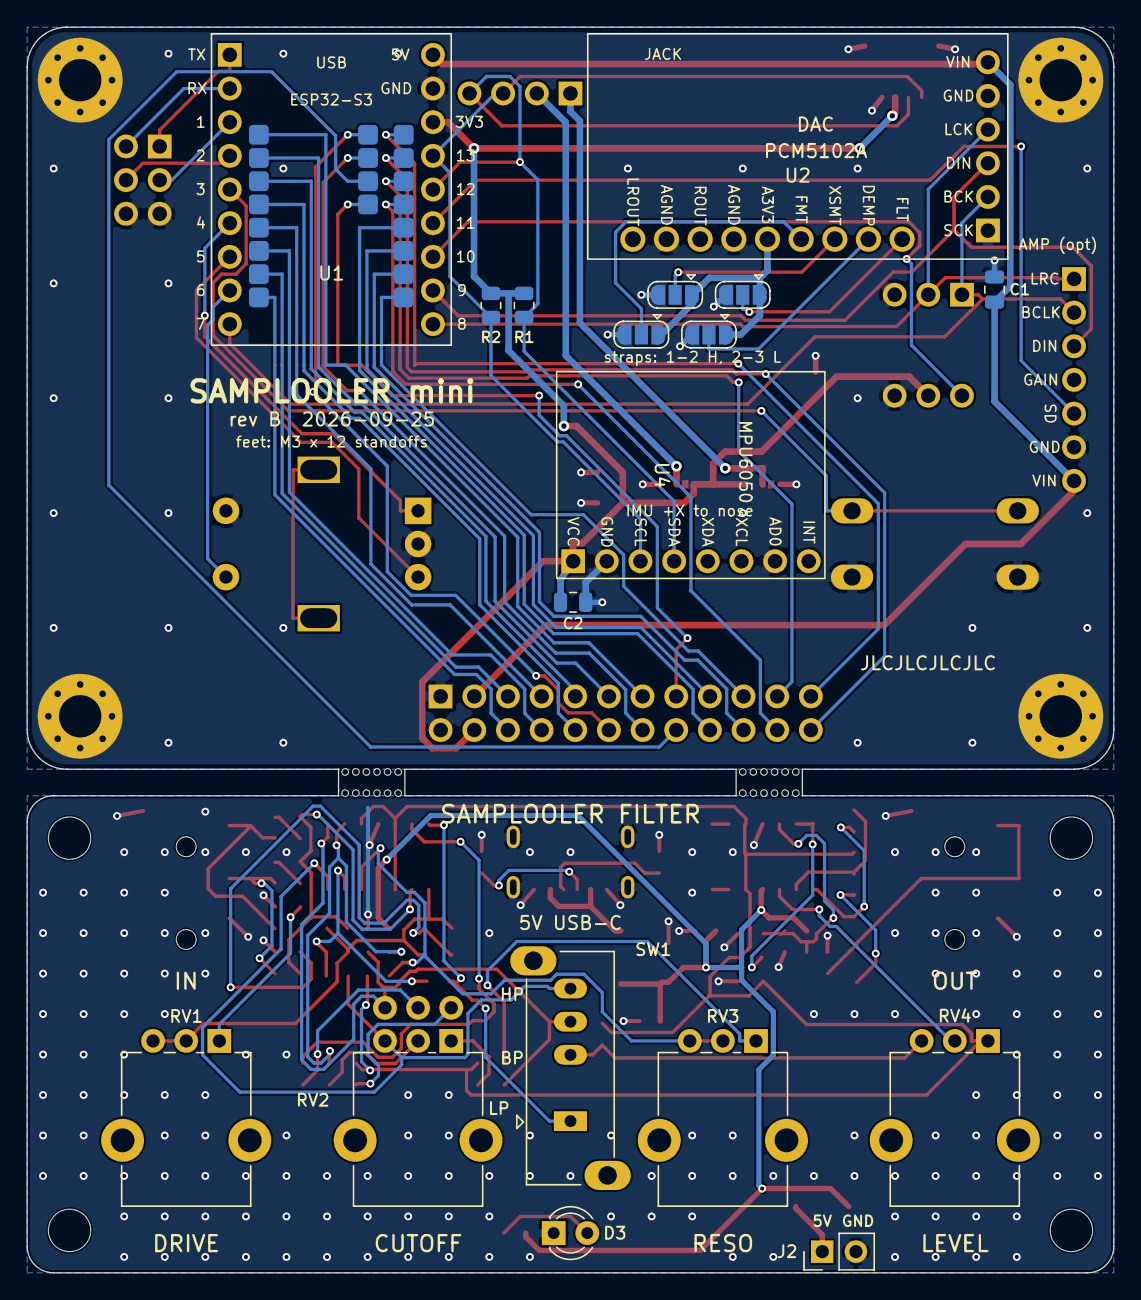
[picture p137: board samplooler-panel-mini.kicad_pcb from below]

Board: 2 copper layers, 82.0 x 94.0 mm, 86 parts (19 on the bottom side), 81 nets.

Parts:
C1, C12: 47u; C_1206_3216Metric
C1#2, C3, C4, C4#2: 10u; C_0805_2012Metric
C2, C10, C11: 100n; C_0603_1608Metric
C2#2, C3#2, C5#2: 100n; C_0805_2012Metric
C5, C6: 1u; C_0603_1608Metric
C7: 100p; C_0603_1608Metric
C8, C9: 3.3n; C_0603_1608Metric
D1, D2: SS14; D_SMA
D3: LED 3mm; LED_D3.0mm
D4, D5: 1N4148W; D_SOD-323
H1, H2, H3#2, H4: M3; MountingHole_3.2mm_M3_Pad_Via
H1#2, H2#2, H3, H4#2: M3; MountingHole_3.2mm_M3
J1: USB-C (power); USB_C_Receptacle_HRO_TYPE-C-31-M-17_NoSilkOverPegs
J2: 5V IN; PinHeader_1x02_P2.54mm_Vertical
J2#2: MAX98357A (opt); MAX98357A_Breakout
J3: IN; Jack_3.5mm_PJ320D_Horizontal
J3#2: Qwiic I2C; JST_SH_SM04B-SRSS-TB_1x04-1MP_P1.00mm_Horizontal
J4: OUT; Jack_3.5mm_PJ320D_Horizontal
J4#2: EXP A; EXP_A_2x3_Mini
J5: EXP B; EXP_B_2x12_Mini
JP1: FLT; SolderJumper-3_P1.3mm_Open_RoundedPad1.0x1.5mm
JP2: DEMP; SolderJumper-3_P1.3mm_Open_RoundedPad1.0x1.5mm
JP3: XSMT; SolderJumper-3_P1.3mm_Open_RoundedPad1.0x1.5mm
JP4: FMT; SolderJumper-3_P1.3mm_Open_RoundedPad1.0x1.5mm
JP5: OLED pin 1; SolderJumper-3_P1.3mm_Bridged12_RoundedPad1.0x1.5mm_NumberL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
JP6: OLED pin 2; SolderJumper-3_P1.3mm_Bridged12_RoundedPad1.0x1.5mm_NumberL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
R1, R2: 5k1; R_0603_1608Metric
R1#2, R2#2: 4k7; R_0805_2012Metric
R3, R11, R12: 2k2; R_0603_1608Metric
R4, R5, R14, R15, R22: 10k; R_0603_1608Metric
R6, R25, R26: 100R; R_0603_1608Metric
R7, R8, R20: 100k; R_0603_1608Metric
R9, R10, R21: 22k; R_0603_1608Metric
R13: 33k; R_0603_1608Metric
R16: 470R; R_0603_1608Metric
R17: 1k5; R_0603_1608Metric
R18, R19: 4k7; R_0603_1608Metric
R23: 47R; R_0603_1608Metric
R24: 47k; R_0603_1608Metric
RV1: B100K; Potentiometer_Alpha_RD901F-40-00D_Single_Vertical_CircularH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
RV2: A10K dual; Potentiometer_Alpha_RD902F-40-00D_Dual_Vertical_CircularHol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
RV3: A50K; Potentiometer_Alpha_RD901F-40-00D_Single_Vertical_CircularH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
RV4: A10K; Potentiometer_Alpha_RD901F-40-00D_Single_Vertical_CircularH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
SW1: EC11, 20 mm shaft; RotaryEncoder_Alps_EC11E-Switch_Vertical_H20mm
SW1#2: LP BP HP; SW_Slide_SP3T_Straight_CK_OS103012MU1QP1
SW2: 12 mm tactile + cap; SW_PUSH-12mm
U1, U2: MCP6004; SOIC-14_3.9x8.7mm_P1.27mm
U1#2: ESP32-S3_SuperMini
U2#2: PCM5102A; GY-PCM5102
U3: INMP441; INMP441_Round
U4: MPU6050; GY-521_MPU6050
U5: OLED 0.96in; SSD1306_0.96in_I2C_NoHoles

Connections:
+3V3: C2#2.1, C3#2.1, C4.1, C5#2.1, J3#2.2, J5.4 (3V3), JP5.3, JP6.1, R1#2.1, R2#2.1, U1#2.12 (3V3), U3.5 (VDD), U4.1 (VCC)
+5V: C1.1, C1#2.1, C2.1, C10.1, C11.1, D1.1, D2.1, J2#2.7 (VIN), J5.3 (5V), R3.1, R4.1, U1.4, U1#2.10 (5V), U2.4, U2#2.6 (VIN)
/5V_EXT: D2.2, J2.1
/AC_L: C5.2, R9.1
/AC_R: C6.2, R10.1
/AMP_SD: J2#2.5 (SD), U1#2.15 (11)
/BP: C8.2, R16.1, RV2.6, SW1#2.3, U1.8
/CC1: J1.A5, R1.1
/CC2: J1.B5, R2.1
/CF1: R25.1, RV2.1
/CF2: R26.1, RV2.4
/CLP: D4.2, D5.1, R12.2
/DAC_3V3: JP1.1, JP2.1, JP3.1, JP4.1, U2#2.11 (A3V3)
/DAC_DEMP: JP2.2, U2#2.8 (DEMP)
/DAC_FLT: JP1.2, U2#2.7 (FLT)
/DAC_FMT: JP4.2, U2#2.10 (FMT)
/DAC_XSMT: JP3.2, U2#2.9 (XSMT)
/DRV: C7.2, D4.1, D5.2, R13.1, RV1.2, RV1.3, U1.1
/DRV_N: C7.1, R9.2, R10.2, R11.1, R12.1, U1.2
/DRV_R: R11.2, RV1.1
/ENC_A: SW1.A, U1#2.6 (4)
/ENC_B: SW1.B, U1#2.7 (5)
/ENC_SW: SW1.S1, U1#2.8 (6)
/GPIO1: J4#2.3 (1), U1#2.3 (1)
/GPIO2: J4#2.4 (2), U1#2.4 (2)
/GPIO14: J5.19 (14), U1#2.38 (GPIO14)
/GPIO15: J5.20 (15), U1#2.37 (GPIO15)
/GPIO16: J5.17 (16), U1#2.36 (GPIO16)
/GPIO17: J5.18 (17), U1#2.35 (GPIO17)
/GPIO18: J5.22 (18), U1#2.34 (GPIO18)
/GPIO21: J5.21, U1#2.33 (GPIO21)
/GPIO33: J5.24 (33), U1#2.32 (GPIO33)
/GPIO34: J5.23 (34), U1#2.31 (GPIO34)
/GPIO35: J5.15 (35), U1#2.30 (GPIO35)
/GPIO36: J5.16 (36), U1#2.29 (GPIO36)
/GPIO37: J5.14 (37), U1#2.28 (GPIO37)
/GPIO38: J5.12 (38), U1#2.27 (GPIO38)
/GPIO39: J5.6 (39), U1#2.26 (GPIO39)
/GPIO40: J5.5 (40), U1#2.25 (GPIO40)
/GPIO41: J5.8 (41), U1#2.24 (GPIO41)
/GPIO42: J5.7 (42), U1#2.23 (GPIO42)
/GPIO43: J4#2.1 (43), U1#2.1 (TX)
/GPIO44: J4#2.2 (44), U1#2.2 (RX)
/GPIO45: J5.10 (45), U1#2.22 (GPIO45)
/GPIO46: J5.9 (46), U1#2.21 (GPIO46)
/GPIO47: J5.11 (47), U1#2.20 (GPIO47)
/GPIO48: J5.13 (48), U1#2.19 (GPIO48)
/HP: R15.1, RV2.3, SW1#2.4, U1.7
/I1_N: C8.1, R18.2, U1.9
/I1_W: R18.1, RV2.2
/I2C_SCL: J3#2.4, R2#2.2, U1#2.13, U4.3 (SCL), U5.3 (SCL)
/I2C_SDA: J3#2.3, R1#2.2, U1#2.14 (12), U4.4 (SDA), U5.4 (SDA)
/I2S_BCLK: J2#2.2 (BCLK), U1#2.9 (7), U2#2.2 (BCK), U3.1 (SCK)
/I2S_DIN: U1#2.16 (10), U3.4 (SD)
/I2S_DOUT: J2#2.3 (DIN), U1#2.17 (9), U2#2.3 (DIN)
/I2S_WS: J2#2.1 (LRC), U1#2.18 (8), U2#2.4 (LCK), U3.2 (WS)
/I2_N: C9.1, R19.2, U1.13
/I2_W: R19.1, RV2.5
/IN_L: C5.1, J3.T, R7.1
/IN_R: C6.1, J3.R1, R8.1
/LED_A: D3.2, R3.2
/LEV_W: RV4.2, U2.3
/LP: C9.2, R14.1, SW1#2.1, U1.14
/MODE: R20.1, RV4.3, SW1#2.2
/OLED_P1: JP5.2, U5.1
/OLED_P2: JP6.2, U5.2
/OUT: C12.2, J4.R1, J4.T, R24.1
/OUT_A: R21.1, R23.1, U2.1
/OUT_B: C12.1, R23.2
/OUT_N: R21.2, R22.1, U2.2
/Q_A: R16.2, RV3.1
/REC: SW2.1, U1#2.5 (3)
/SPB: U2.6, U2.7
/SPC: U2.8, U2.9
/SUM_N: R13.2, R14.2, R15.2, U1.6
/SUM_P: R17.1, RV3.2, RV3.3, U1.5
/VBUS: D1.2, J1.A9, J1.B9
/VREF: C4#2.1, R6.2, R17.2, R20.2, R22.2, R25.2, R26.2, RV4.1, U1.3, U1.10, U1.12, U2.5, U2.10
/VREF_D: C3.1, R4.2, R5.1, U2.12
/VREF_O: R6.1, U2.13, U2.14
GND: C1.2, C1#2.2, C2.2, C2#2.2, C3.2, C3#2.2, C4.2, C4#2.2, C5#2.2, C10.2, C11.2, D3.1, H1.1, H2.1, H3#2.1, H4.1, J1.A12, J1.B12, J1.SH, J2.2, J2#2.6 (GND), J3.R2, J3.S, J3#2.1, J3#2.MP, J4.R2, J4.S, J4#2.5 (GND), J4#2.6 (GND), J5.1 (GND), J5.2 (GND), JP1.3, JP2.3, JP3.3, JP4.3, JP5.1, JP6.3, R1.2, R2.2, R5.2, R7.2, R8.2, R24.2, SW1.C, SW1.S2, SW2.2, U1.11, U1#2.11 (GND), U2.11, U2#2.1 (SCK), U2#2.5 (GND), U2#2.12 (AGND), U2#2.14 (AGND), U3.3 (L/R), U3.6 (GND), U4.2 (GND), U4.7 (AD0)
