willbearfruits/samplooler/hardware/gen/render.py

#!/usr/bin/env python3
"""Renders for the README: every board, the assembled stack, and the Mini from both faces.

KiCad renders one board at a time, so the stack is faked honestly: the top board is exported
as VRML (with all its parts) and hung, as a 3D model, 11 mm above a copy of the bottom board
that exists only for this render (in hardware/.stack, a sibling of the project folders so the
relative 3D-model paths still resolve). Output: hardware/images/*.png
"""
import os
import subprocess
import sys

HERE = os.path.dirname(os.path.abspath(__file__))
sys.path.insert(0, HERE)
import pcbnew                    # noqa: E402
import kit                       # noqa: E402
import stack                     # noqa: E402

HW = kit.HW
IMG = os.path.join(HW, 'images')
TMP = os.path.join(HW, '.stack')


def run(cmd):
    r = subprocess.run(cmd, capture_output=True, text=True)
    if r.returncode:
        raise RuntimeError(r.stdout + r.stderr)


def render(pcb, out, rotate=None, zoom=1.0, side='top', w=1800, h=1200):
    cmd = ['kicad-cli', 'pcb', 'render', '--side', side, '--quality', 'high', '--width', str(w),
           '--height', str(h), '--background', 'opaque', '--perspective', '--zoom', str(zoom), '-o', out, pcb]
    if rotate:
        cmd[3:3] = ['--rotate', rotate]
    run(cmd)
    print(os.path.relpath(out, HW))


def stack_board():
    os.makedirs(TMP, exist_ok=True)
    top_wrl = os.path.join(TMP, 'top.wrl')
    run(['kicad-cli', 'pcb', 'export', 'vrml', '-f', '--units', 'tenths',
         '--user-origin', f'{kit.ORIGIN[0]}x{kit.ORIGIN[1]}mm', '-o', top_wrl, kit.paths(stack.TOP)[2]])
    b = pcbnew.LoadBoard(kit.paths(stack.BOTTOM)[2])
    fp = pcbnew.FOOTPRINT(b)
    fp.SetPosition(pcbnew.VECTOR2I_MM(*kit.ORIGIN))
    m = pcbnew.FP_3DMODEL()
    m.m_Filename = top_wrl
    m.m_Offset.z = stack.GAP + 0.8          # the export centres the 1.6 mm board on z = 0
    fp.Models().append(m)
    b.Add(fp)
    path = os.path.join(TMP, 'stack.kicad_pcb')
    pcbnew.SaveBoard(path, b)
    return path


if __name__ == '__main__':
    os.makedirs(IMG, exist_ok=True)
    bot, top = kit.paths(stack.BOTTOM)[2], kit.paths(stack.TOP)[2]
    mini = os.path.join(HW, 'mini', 'samplooler-mini.kicad_pcb')
    render(bot, os.path.join(IMG, 'stack-bottom-3d.png'), '-45,0,-20', 0.95)
    render(top, os.path.join(IMG, 'stack-top-3d.png'), '-45,0,-20', 0.95)
    render(bot, os.path.join(IMG, 'stack-bottom-plan.png'))
    render(top, os.path.join(IMG, 'stack-top-plan.png'))
    s = stack_board()
    render(s, os.path.join(IMG, 'stack-3d.png'), '-55,0,-25', 0.9)
    render(s, os.path.join(IMG, 'stack-nose.png'), '-80,0,180', 0.9)
    render(mini, os.path.join(IMG, 'mini-front-3d.png'), '-45,0,-20', 0.95)
    render(mini, os.path.join(IMG, 'mini-back-3d.png'), '-45,0,160', 0.95, side='bottom')
    render(mini, os.path.join(IMG, 'mini-front-plan.png'))
    render(mini, os.path.join(IMG, 'mini-back-plan.png'), side='bottom')
    render(mini, os.path.join(IMG, 'mini-side.png'), '-80,0,180', 0.9)
    for name in ('stack', 'mini'):          # made by panel.py
        panel = os.path.join(HW, f'panel-{name}', f'samplooler-panel-{name}.kicad_pcb')
        if os.path.exists(panel):
            render(panel, os.path.join(IMG, f'panel-{name}.png'), zoom=0.85, w=1400, h=1400)
            render(panel, os.path.join(IMG, f'panel-{name}-back.png'), zoom=0.85, side='bottom', w=1400, h=1400)
