willbearfruits/samplooler/instruments/band/firmware/main/layer_drums.c

// DRUMS: KNOCK as a layer of the band, and a GRID to draw beats on. Knock on the box: the mic hears when and how hard, the
// accelerometer's 1 kHz stream says which side was hit (face, left, right, top, bottom edge), and each side
// is its own drum (VOICE) over the knock itself ringing a set of tuned resonators (BODY). The KIT picks the
// five drums and the body; tonal drums and BY SIDE bodies play the song's chord, so they follow the key and
// the progression. REC is an event loop in the song's loop: the first loop of the jam (on any layer) sets
// its length; hold REC to add, tap to mute the drums' loop. GRID, SWING and MUTATE act at playback and never
// change what was recorded. The stick: up rolls the last drum, down repeats the last slice of the drums,
// left/right a filter on them. Tilt tunes; leaning mutates. The kicks of the loop go to song.kicks for the bass.
//
// The GRID: four drums (the kit's face, left, right and top: kick, snare, hat, tom on most kits) by eight steps,
// drawn with the knob. Hold the knob while DRUMS is live (or DRUMS > EDIT GRID) and the scene becomes the grid:
// turn to move, press to set a step (off, on, accent), press and turn to paint, hold to leave. GRID STEP makes the
// eight steps a bar of eighths, half a bar of sixteenths (played twice) or two bars of quarters. It plays on the
// song's beats (with a loop, from its start) whether DRUMS is live or not, through the same drums as a knock, and
// its kicks go to song.kicks when the knock loop has none. GRID BEAT loads a ready beat; drawing makes it MINE.
// The pattern is four hidden params (on bits low, accent bits high), so sounds and flash keep it.
//
// Ported from ../knock (inst_engine.c + instrument.c); the numbers measured there hold here.
#include "band.h"
#include "ui.h"
#include "params.h"
#include "spsc.h"
#include <stdio.h>
#include <string.h>
#ifdef ESP_PLATFORM
#include "esp_attr.h"          // the audio path in internal RAM by itself, whatever the linker fragment says
#else
#define IRAM_ATTR
#define DRAM_ATTR
#endif

// ---------------------------------------------------------------- params
enum { DP_KIT, DP_GEDIT, DP_GON, DP_GBEAT, DP_GSTEP, DP_KNOCK, DP_TUNE, DP_DECAY, DP_SENSE, DP_SIDES, DP_GRID, DP_STRENGTH, DP_SWING,
       DP_MUTATE, DP_UNDO, DP_BODY, DP_PITCH, DP_RING, DP_DRIVE, DP_PUNCH, DP_SEND, DP_GR0, DP_GR1, DP_GR2, DP_GR3, DP_N };
enum { SD_FACE, SD_LEFT, SD_RIGHT, SD_TOP, SD_BOTTOM, NSIDE };
enum { V_NONE, V_KICK, V_SNARE, V_HAT, V_OHAT, V_TOM, V_CLAP, V_RIM, V_COWBELL, V_SHAKER, V_CONGA, V_ZAP, NVTYPE };
enum { B_OFF, B_WOOD, B_MARIMBA, B_BELL, B_GLASS, B_TABLA, B_STEEL, B_MEMBRANE, B_METAL, NBODY };
enum { SRC_LIVE, SRC_LOOP, SRC_MIDI, SRC_ROLL, SRC_GRID };
#define GROWS  4               // the grid: the kit's first four sides
#define GSTEPS 8
#define GX0 29                 // the editor on the screen: the first step's x, the step pitch, the first row's y, the row pitch
#define GDX 12
#define GY0 19
#define GDY 9
// ready beats: per row the on steps (bit s = step s) and, above them, the accented ones; and the step
typedef struct { const char *name; uint16_t r[GROWS]; uint8_t step; } beat_t;
static const beat_t beats[] = {
    { "MINE",       { 0, 0, 0, 0 }, 0 },
    { "ROCK",       { 0x0111, 0x4444, 0x55FF, 0 }, 0 },
    { "FUNK",       { 0x0109, 0x1090, 0x55FF, 0 }, 1 },
    { "HIP HOP",    { 0x0129, 0x4444, 0x55FF, 0 }, 0 },
    { "FOUR FLOOR", { 0x5555, 0x0044, 0xAAAA, 0 }, 0 },
    { "ONE DROP",   { 0x1010, 0x1010, 0xAAFF, 0 }, 0 },
    { "HALF TIME",  { 0x0109, 0x1010, 0x55FF, 0x0080 }, 0 },
    { "TRAP",       { 0x0141, 0x1010, 0x11FF, 0 }, 1 },
};
#define NBEATS ((int)(sizeof beats / sizeof beats[0]))
static const char *const beat_l[NBEATS] = { "MINE", "ROCK", "FUNK", "HIP HOP", "FOUR FLOOR", "ONE DROP", "HALF TIME", "TRAP" };

typedef struct {
    const char *name;
    uint8_t v[NSIDE];          // the drum on each side
    uint8_t body, by_side;     // the body, and whether its pitch follows the side (chord tones)
    int8_t  octave;            // the body's octave (scale_note's o)
    float   body_lvl, decay, ring, touch_ms, click;
} kit_t;
static const kit_t kits[] DRAM_ATTR = {
    { "STREET",    { V_KICK, V_SNARE, V_HAT, V_TOM, V_CLAP }, B_WOOD, 0, 4, 0.35f, 1.0f, 1.0f, 10, 0.5f },
    { "808",       { V_KICK, V_CLAP, V_HAT, V_COWBELL, V_OHAT }, B_OFF, 0, 4, 0, 1.8f, 1.0f, 10, 0.4f },
    { "BOOM BAP",  { V_KICK, V_SNARE, V_HAT, V_RIM, V_SHAKER }, B_OFF, 0, 4, 0, 0.8f, 1.0f, 10, 0.7f },
    { "TECHNO",    { V_KICK, V_CLAP, V_OHAT, V_HAT, V_RIM }, B_OFF, 0, 4, 0, 1.2f, 1.0f, 10, 0.8f },
    { "HAND DRUM", { V_CONGA, V_CONGA, V_RIM, V_CONGA, V_SHAKER }, B_MEMBRANE, 0, 3, 0.8f, 1.0f, 1.2f, 20, 0.3f },
    { "MARIMBA",   { V_NONE, V_NONE, V_NONE, V_NONE, V_NONE }, B_MARIMBA, 1, 4, 0.95f, 1.0f, 1.2f, 10, 0.5f },
    { "BELLS",     { V_NONE, V_NONE, V_NONE, V_NONE, V_NONE }, B_BELL, 1, 4, 0.75f, 1.0f, 1.5f, 10, 0.5f },
    { "GLASS",     { V_NONE, V_NONE, V_NONE, V_NONE, V_NONE }, B_GLASS, 1, 5, 0.85f, 1.0f, 1.4f, 10, 0.5f },
    { "TABLA",     { V_NONE, V_NONE, V_SHAKER, V_NONE, V_NONE }, B_TABLA, 1, 4, 0.9f, 1.0f, 1.0f, 14, 0.5f },
    { "STEEL PAN", { V_NONE, V_NONE, V_NONE, V_NONE, V_NONE }, B_STEEL, 1, 4, 0.9f, 1.0f, 1.2f, 10, 0.5f },
    { "SCRAP",     { V_KICK, V_NONE, V_NONE, V_NONE, V_RIM }, B_METAL, 0, 3, 0.85f, 1.0f, 2.0f, 30, 0.5f },
    { "ZAPS",      { V_ZAP, V_ZAP, V_ZAP, V_ZAP, V_ZAP }, B_OFF, 0, 4, 0, 1.0f, 1.0f, 10, 0.5f },
    { "COWBELLS",  { V_KICK, V_COWBELL, V_COWBELL, V_COWBELL, V_CLAP }, B_OFF, 0, 4, 0, 1.0f, 1.0f, 10, 0.5f },
    { "SCRATCH",   { V_NONE, V_NONE, V_NONE, V_NONE, V_NONE }, B_GLASS, 0, 3, 0.95f, 1.0f, 2.5f, 30, 0.5f },
};
#define NKITS ((int)(sizeof kits / sizeof kits[0]))
static const char *const kit_l[NKITS] = { "STREET", "808", "BOOM BAP", "TECHNO", "HAND DRUM", "MARIMBA", "BELLS", "GLASS",
                                          "TABLA", "STEEL PAN", "SCRAP", "ZAPS", "COWBELLS", "SCRATCH" };
static const char *const sides_l[] = { "SIDE", "TONE", "ONE DRUM" };
static const char *const grid_l[] = { "OFF", "1/4", "1/8", "1/8T", "1/16", "1/16T", "1/32" };
static const char *const pitch_l[] = { "KIT", "ONE", "BY SIDE" };
static const char *const gon_l[] = { "OFF", "ON" };
static const char *const knock_l[] = { "OFF", "ON" };
static const char *const gstep_l[] = { "1/8", "1/16", "1/4" };
static const char *const pages[2] = { "DRUMS", "DRUM KIT" };
static const param_t params[DP_N] = {
    [DP_KIT]      = { "KIT", "dkit", 0, PK_ENUM, 0, 0, NKITS - 1, 1, 0, "", kit_l, "FIVE DRUMS, WHAT THEY RING" },
    [DP_GEDIT]    = { "EDIT GRID", "dged", 0, PK_ACT, PF_NOCC, 0, 0, 0, 0, "", NULL, "DRAW A BEAT, 4 DRUMS X 8" },
    [DP_GON]      = { "GRID", "dgon", 0, PK_ENUM, 0, 0, 1, 1, 0, "", gon_l, "THE DRAWN BEAT PLAYS" },
    [DP_GBEAT]    = { "GRID BEAT", "dgbt", 0, PK_ENUM, 0, 0, NBEATS - 1, 1, 1, "", beat_l, "A READY BEAT, OR YOURS" },
    [DP_GSTEP]    = { "GRID STEP", "dgst", 0, PK_ENUM, 0, 0, 2, 1, 0, "", gstep_l, "8 STEPS: A BAR, HALF, TWO" },
    [DP_KNOCK]    = { "KNOCKS", "dkno", 0, PK_ENUM, PF_SYS, 0, 1, 1, 1, "", knock_l, "OFF: ONLY THE GRID PLAYS" },
    [DP_TUNE]     = { "TUNE", "dtun", 0, PK_NUM, PF_INT | PF_SIGNED, -12, 12, 1, 0, "st", NULL, "THE DRUMS UP OR DOWN" },
    [DP_DECAY]    = { "DECAY", "ddcy", 0, PK_NUM, PF_LOG, 0.25f, 4.0f, 1.12f, 1.0f, "x", NULL, "SHORTER OR LONGER DRUMS" },
    [DP_SENSE]    = { "SENSE", "dsns", 0, PK_NUM, PF_INT, 0, 100, 5, 60, "%", NULL, "HOW SOFT A KNOCK COUNTS" },
    [DP_SIDES]    = { "SIDES", "dsid", 0, PK_ENUM, 0, 0, 2, 1, 0, "", sides_l, "HOW A KNOCK PICKS ITS DRUM" },
    [DP_GRID]     = { "QUANTIZE", "dgrd", 0, PK_ENUM, 0, 0, 6, 1, 4, "", grid_l, "WHAT KNOCKS ARE PULLED TO" },
    [DP_STRENGTH] = { "STRENGTH", "dstr", 0, PK_NUM, PF_INT, 0, 100, 5, 70, "%", NULL, "HOW HARD THEY ARE PULLED" },
    [DP_SWING]    = { "SWING", "dswg", 0, PK_NUM, PF_INT, 0, 75, 5, 0, "%", NULL, "LATE OFFBEATS" },
    [DP_MUTATE]   = { "MUTATE", "dmut", 0, PK_NUM, PF_INT, 0, 100, 5, 0, "%", NULL, "HITS DROP OUT OR CHANGE" },
    [DP_UNDO]     = { "UNDO LAST", "dund", 0, PK_ACT, PF_NOCC, 0, 0, 0, 0, "", NULL, "TAKE AWAY THE LAST LAYER" },
    [DP_BODY]     = { "BODY", "dbdy", 1, PK_NUM, PF_INT, 0, 100, 5, 100, "%", NULL, "HOW LOUD THE RINGING IS" },
    [DP_PITCH]    = { "BODY PITCH", "dpit", 1, PK_ENUM, 0, 0, 2, 1, 0, "", pitch_l, "ONE NOTE, OR CHORD BY SIDE" },
    [DP_RING]     = { "RING", "drng", 1, PK_NUM, PF_LOG, 0.25f, 4.0f, 1.12f, 1.0f, "x", NULL, "HOW LONG IT RINGS" },
    [DP_DRIVE]    = { "DRIVE", "ddrv", 1, PK_NUM, PF_INT, 0, 100, 5, 0, "%", NULL, "DIRT" },
    [DP_PUNCH]    = { "PUNCH", "dpch", 1, PK_NUM, PF_INT, 0, 100, 5, 35, "%", NULL, "SQUEEZE: FATTER, LOUDER" },
    [DP_SEND]     = { "FX SEND", "dsnd", 1, PK_NUM, PF_INT, 0, 100, 5, 15, "%", NULL, "INTO THE ECHO AND REVERB" },
    // the pattern: steps in the low byte, accents in the high one (ROCK by default)
    [DP_GR0]      = { "GRID ROW 1", "dgr0", 0, PK_NUM, PF_INT | PF_HIDE | PF_NOCC, 0, 65535, 1, 0x0111, "", NULL, "STEPS, ACCENTS ABOVE" },
    [DP_GR1]      = { "GRID ROW 2", "dgr1", 0, PK_NUM, PF_INT | PF_HIDE | PF_NOCC, 0, 65535, 1, 0x4444, "", NULL, "STEPS, ACCENTS ABOVE" },
    [DP_GR2]      = { "GRID ROW 3", "dgr2", 0, PK_NUM, PF_INT | PF_HIDE | PF_NOCC, 0, 65535, 1, 0x55FF, "", NULL, "STEPS, ACCENTS ABOVE" },
    [DP_GR3]      = { "GRID ROW 4", "dgr3", 0, PK_NUM, PF_INT | PF_HIDE | PF_NOCC, 0, 65535, 1, 0, "", NULL, "STEPS, ACCENTS ABOVE" },
};
#define P(i) LP(L_DRUMS, i)

// ---------------------------------------------------------------- tables
static const char *const vt_label[NVTYPE] = { "BODY", "KICK", "SNARE", "HAT", "OPEN", "TOM", "CLAP", "RIM", "BELL", "SHAKE", "CONGA", "ZAP" };
static const int vt_gm[NVTYPE] = { 0, 36, 38, 42, 46, 45, 39, 37, 56, 70, 63, 81 };
static const int side_gm[NSIDE] = { 36, 38, 42, 45, 39 };
static const int side_degree[NSIDE] DRAM_ATTR = { 0, 2, 4, 6, 7 };          // chord tones by side: root, 3rd, 5th, 7th, octave
#define NMODE 6
typedef struct { int n; float r[NMODE], d[NMODE], g[NMODE]; float trim; } body_t;
static const body_t bodies[NBODY] DRAM_ATTR = {
    [B_OFF]      = { 0, { 0 }, { 0 }, { 0 }, 0 },
    [B_WOOD]     = { 4, { 1, 2.756f, 5.404f, 8.933f }, { 0.16f, 0.07f, 0.04f, 0.022f }, { 1, 0.5f, 0.28f, 0.15f }, 0.9f },
    [B_MARIMBA]  = { 3, { 1, 3.99f, 9.9f }, { 0.75f, 0.2f, 0.07f }, { 1, 0.32f, 0.12f }, 0.5f },
    [B_BELL]     = { 6, { 0.5f, 1, 1.183f, 1.506f, 2.0f, 2.514f }, { 3.2f, 2.4f, 1.7f, 1.3f, 1.0f, 0.6f }, { 0.55f, 1, 0.6f, 0.45f, 0.4f, 0.22f }, 0.22f },
    [B_GLASS]    = { 4, { 1, 2.32f, 4.25f, 6.63f }, { 1.7f, 1.0f, 0.6f, 0.35f }, { 1, 0.6f, 0.4f, 0.25f }, 0.3f },
    [B_TABLA]    = { 5, { 1, 2, 3, 4, 5 }, { 0.5f, 0.35f, 0.25f, 0.18f, 0.12f }, { 1, 0.7f, 0.5f, 0.3f, 0.2f }, 0.45f },
    [B_STEEL]    = { 4, { 1, 2, 3.01f, 4.02f }, { 1.4f, 0.9f, 0.5f, 0.3f }, { 1, 0.6f, 0.35f, 0.2f }, 0.35f },
    [B_MEMBRANE] = { 6, { 1, 1.594f, 2.136f, 2.296f, 2.653f, 2.918f }, { 0.38f, 0.26f, 0.2f, 0.18f, 0.15f, 0.12f }, { 1, 0.6f, 0.45f, 0.4f, 0.3f, 0.25f }, 0.45f },
    [B_METAL]    = { 6, { 1, 1.41f, 2.24f, 2.92f, 3.83f, 4.69f }, { 1.8f, 1.4f, 1.0f, 0.8f, 0.6f, 0.4f }, { 1, 0.8f, 0.6f, 0.5f, 0.4f, 0.3f }, 0.2f },
};

static IRAM_ATTR const kit_t *kit(void) { int k = (int)P(DP_KIT); return &kits[k < 0 ? 0 : k >= NKITS ? NKITS - 1 : k]; }
static IRAM_ATTR bool by_side(void) { int p = (int)P(DP_PITCH); return p == 0 ? kit()->by_side != 0 : p == 2; }
// the note a side plays: tonal drums and BY SIDE bodies take the chord's tones (in the song's scale)
static IRAM_ATTR int side_note(int side, int octave) { return scale_note(song.degree + side_degree[side], octave); }

// ---------------------------------------------------------------- shared state (UI <-> audio)
#define SNIP_LEN 512           // 16 ms of mic per knock (int16, PSRAM), 16 samples before the onset
#define SNIP_PRE 16
#define NSNIP    160           // 128 can be pinned by the loop, the rest rotate
#define MAXHITS  128
typedef struct { uint32_t frame; float bright, level; int16_t snip; } onset_t;
typedef struct { uint8_t side, vel, src; int16_t snip; } trig_t;
typedef struct { uint32_t frame; uint8_t side, vel, src; int8_t step; } played_t;   // step: the grid's (-1 none)
// off: where it plays in the loop; while the first take is being made (no loop yet), frames since the take began,
// with rel set until the loop exists and it is placed (rebase_hits)
typedef struct { uint32_t off; uint8_t side, vel, layer; volatile uint8_t dead; int16_t snip; uint16_t born; volatile uint8_t rel; } hit_t;
SPSC(d_onsetq, onset_t, 16)
SPSC(d_trigq, trig_t, 32)
SPSC(d_playq, played_t, 64)
static d_onsetq_t onsets;
static d_trigq_t  trigs;
static d_playq_t  played;
static hit_t hits[MAXHITS];
static volatile int nhits;
static volatile int loop_on = 1;            // the drums' loop plays (a tap on REC mutes it)
static volatile float tune_now, mutate_now, filter_now, roll_hz, stutter_s, knock_avg = 0.1f;
static volatile int   roll_side, roll_vel = 90;
static volatile uint8_t pinned[NSNIP];
static volatile float env_now, thr_now, body_lvl[NSIDE];
static volatile bool  live_now;
static volatile bool  knocks_heard = true;    // KNOCKS on and the grid's editor closed (pressing the knob jolts the box)

// ---------------------------------------------------------------- audio: voices
static uint32_t seed = 0x9e3779b9u, frame0;
#define NV 10
typedef struct {
    uint8_t type, side; bool on; int delay, t;
    float amp, ph, ph2, f0, f1, ae, kae, pe, kpe, xe, carry, last;
    svf_t fa;
} voice_t;
static voice_t vo[NV];

static IRAM_ATTR void voice_start(int type, int side, float amp, int delay)
{
    int k = -1; float q = 1e9f;
    for (int i = 0; i < NV; i++) {
        if (!vo[i].on) { k = i; break; }
        float l = vo[i].ae * vo[i].amp;
        if (l < q) { q = l; k = i; }
    }
    voice_t *v = &vo[k];
    float carry = v->on ? v->last + v->carry : 0.0f;             // a stolen voice fades out, never cut
    if (type == V_HAT) for (int i = 0; i < NV; i++) if (vo[i].on && vo[i].type == V_OHAT) vo[i].kae = 0.992f;
    memset(v, 0, sizeof *v);
    v->carry = carry;
    v->type = (uint8_t)type; v->side = (uint8_t)side; v->on = true; v->delay = delay; v->amp = amp; v->ae = v->pe = v->xe = 1.0f;
    bool tonal = type == V_TOM || type == V_CONGA || type == V_ZAP || type == V_COWBELL;
    // tonal drums: the side's chord tone, relative to C4 (their base tunings are for C)
    float tn = exp2f((tune_now + (tonal ? (float)(side_note(side, 4) - 60) : 0.0f)) / 12.0f);
    float dc = P(DP_DECAY) * kit()->decay, pk = kit()->click;
    switch (type) {
    case V_KICK:    v->f0 = 46.0f * exp2f(tune_now / 12.0f); v->kpe = 1.0f - onepole_s(0.03f); v->kae = 1.0f - onepole_s(0.30f * dc); v->f1 = 2.0f + 3.0f * pk; break;
    case V_SNARE:   v->f0 = 185.0f * tn; svf_set(&v->fa, 1600.0f * tn, 0.7f); v->kpe = 1.0f - onepole_s(0.05f); v->kae = 1.0f - onepole_s(0.15f * dc); break;
    case V_HAT:     svf_set(&v->fa, 7200.0f * tn, 0.8f); v->kae = 1.0f - onepole_s(0.04f * dc); break;
    case V_OHAT:    svf_set(&v->fa, 6500.0f * tn, 0.9f); v->kae = 1.0f - onepole_s(0.32f * dc); break;
    case V_TOM:     v->f0 = 130.8f * tn; v->kpe = 1.0f - onepole_s(0.05f); v->kae = 1.0f - onepole_s(0.38f * dc); break;
    case V_CLAP:    svf_set(&v->fa, 1100.0f * tn, 1.5f); v->kpe = 1.0f - onepole_s(0.004f); v->kae = 1.0f - onepole_s(0.14f * dc); break;
    case V_RIM:     v->f0 = 520.0f * tn; svf_set(&v->fa, 1800.0f * tn, 2.0f); v->kae = 1.0f - onepole_s(0.028f * dc); v->kpe = 1.0f - onepole_s(0.006f); break;
    case V_COWBELL: v->f0 = 523.3f * tn; v->f1 = 784.0f * tn; svf_set(&v->fa, 2400.0f * tn, 1.2f); v->kpe = 1.0f - onepole_s(0.02f); v->kae = 1.0f - onepole_s(0.22f * dc); break;
    case V_SHAKER:  svf_set(&v->fa, 5500.0f * tn, 1.2f); v->kae = 1.0f - onepole_s(0.07f * dc); v->xe = 0.0f; break;
    case V_CONGA:   v->f0 = 261.6f * tn; v->kpe = 1.0f - onepole_s(0.008f); v->kae = 1.0f - onepole_s(0.2f * dc); break;
    case V_ZAP:     v->f0 = 85.0f * tn; v->f1 = 2600.0f * tn; v->kpe = 1.0f - onepole_s(0.03f); v->kae = 1.0f - onepole_s(0.17f * dc); break;
    }
}

static inline IRAM_ATTR float voice_run(voice_t *v, float pk)
{
    if (v->delay > 0) { v->delay--; float c = v->carry; v->carry *= 0.93f; return c; }
    float y = 0;
    const float isr = 1.0f / (float)AUDIO_SR;
    switch (v->type) {
    case V_KICK:
        v->ph = wrap1(v->ph + v->f0 * (1.0f + v->f1 * v->pe) * isr);
        y = sin_turns(v->ph) * v->ae;
        if (v->t < 48) y += (0.2f + 0.4f * pk) * rng_bi(&seed) * (1.0f - (float)v->t / 48.0f);
        break;
    case V_SNARE:
        v->ph = wrap1(v->ph + v->f0 * (1.0f + 0.4f * v->pe) * isr);
        y = 0.45f * sin_turns(v->ph) * v->pe + 0.75f * svf_hp(&v->fa, rng_bi(&seed)) * v->ae;
        break;
    case V_HAT: case V_OHAT: y = 0.75f * svf_hp(&v->fa, rng_bi(&seed)) * v->ae; break;
    case V_TOM: case V_CONGA:
        v->ph = wrap1(v->ph + v->f0 * (1.0f + (v->type == V_TOM ? 0.45f : 0.25f) * v->pe) * isr);
        y = sin_turns(v->ph) * v->ae;
        if (v->type == V_CONGA && v->t < 40) y += 0.25f * rng_bi(&seed);
        break;
    case V_CLAP: {
        if (v->t == 352 || v->t == 704) v->pe = 1.0f;
        float e = v->t > 704 && v->ae > v->pe ? v->ae : v->pe;
        y = 1.5f * svf_bp(&v->fa, rng_bi(&seed), NULL) * e;
        break;
    }
    case V_RIM:
        v->ph = wrap1(v->ph + v->f0 * isr);
        y = 0.6f * sin_turns(v->ph) * v->ae + 1.2f * svf_bp(&v->fa, rng_bi(&seed), NULL) * v->pe;
        break;
    case V_COWBELL: {
        float d0 = v->f0 * isr, d1 = v->f1 * isr;
        v->ph = wrap1(v->ph + d0); v->ph2 = wrap1(v->ph2 + d1);
        y = 0.8f * svf_bp(&v->fa, 0.5f * (square_blep(v->ph, d0) + square_blep(v->ph2, d1)), NULL) * (0.4f * v->pe + 0.6f) * v->ae;
        break;
    }
    case V_SHAKER: v->xe += (1.0f - v->xe) * 0.03f; y = 1.1f * svf_bp(&v->fa, rng_bi(&seed), NULL) * v->ae * v->xe; break;
    case V_ZAP: v->ph = wrap1(v->ph + (v->f0 + v->f1 * v->pe) * isr); y = sin_turns(v->ph) * v->ae; break;
    }
    v->ae *= v->kae; v->pe *= v->kpe; v->t++;
    y *= v->amp; v->last = y;
    float c = v->carry; v->carry = flush_denormal(v->carry * 0.93f);
    if (v->ae < 1e-3f && v->t > 64) v->on = false;              // -60 dB: under the mix, and the voice is free again
    return y + c;
}

// ---------------------------------------------------------------- audio: bodies, one bank of modes per side
typedef struct { float c1, c2, g, y1, y2; } mode_t;
typedef struct { mode_t m[NMODE]; int nm, snip, pos, len, delay; float gain, lp, note, note_done; } bank_t;
static bank_t bank[NSIDE];
static int   body_cur = -1, body_fade;
static float last_ring = -1, live_gate, exc_lp_live;
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
