willbearfruits/samplooler/(commit log)

2026-09-23 Gesture recorder: tilt-controlled looper for ESP32-S3 and ESP32-C3 SuperMini
    Firmware (float DSP on S3, Q15 on C3 with OLED), USB MIDI + UAC2,
    WAV sample slots, roll effects, JUCE plugin, OpenSCAD enclosure,
    host UI simulator and flashing tools.
    Claude-Session: https://claude.ai/code/session_01EaE6nM6C8t4DmuFHtU7Bma
2026-09-25 Hardware: two-board PCB stack for the S3 build
    A bottom board carries the modules (ESP32-S3 SuperMini, GY-PCM5102, INMP441,
    GY-521, KY-023 and a header for the optional MAX98357A); a top panel carries
    the SSD1306 OLED and the EC11 encoder, with an opening for the joystick and
    access holes over BOOT and RST. They mate through a 2x4 socket and header at
    11 mm on M3 standoffs. Same pin map as firmware/main/pins.h.
    hardware/gen generates everything: symbols, footprints and VRML bodies for the
    modules, both schematics, placement, hand-routed power, Freerouting for the
    signals, GND pours, JLCPCB Gerber zips with BOM/CPL, and renders. ERC and DRC
    (every severity, on the saved fill that is plotted)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
2026-09-25 Hardware rev B: stack with the encoder below, a one-board Mini, pogo pins and breakouts
    Two designs, both generated by hardware/gen and checked by every build: ERC 0, DRC 0 at
    every severity with schematic parity, every net routed, 0 collisions in the 3D mechanical
    model.
    - Stack: the encoder moves to the bottom board next to the joystick and reaches up through
    the top board; the mic moves to the top board. The link carries I2C and I2S, GND on its
    bottom row.
    - Mini: one 82 x 56 mm board without the joystick, parts on both faces (OLED, mic,
    encoder, record button in front; SuperMini, DAC, IMU, amp header behind); the mechanical
    model works out the solder order.
    - Pogo pins reach the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
2026-09-25 Showcase video with sound, its pipeline, and a PCB playbook skill
    tools/showcase/make_showcase.sh builds the full product video (hardware/images/
    samplooler-showcase-full.mp4, 89 s). Its soundtrack is the device itself: twin.c compiles the
    firmware's recorder_f32.c, fx.c, ui.c and oled.c on the host and drives them the way main.c does
    (10 ms ticks, the button debounce, the 50 Hz tilt curve) from a scripted performance in score.py.
    The same score gives the OLED frames and the angles Blender tilts the stack by, so sound, screen
    and motion stay in sync. Then the PCB shots, the copper, the C3 case from the OpenSCAD model and
    the website. make_hardware_video.sh is the boards-only cut (samplooler-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
2026-09-25 Samplooler: firmware/ layout, web flasher and demo, CI, licences, build guide
    - The ESP-IDF project moves into firmware/; the tools, plugin and enclosure take the Samplooler
    name (tools/gr_midi.py becomes tools/sl_midi.py).
    - site/: the project page with a browser flasher (esp-web-tools) and an in-browser demo of the
    playback engine, plus the screens and the case renders.
    - CI builds both targets on every push, deploys site/ with fresh images to GitHub Pages from
    main, and attaches the images to a release on v* tags. tools/release.sh does the same locally.
    - docs/BUILD.md: the build guide for both versions.
    - Licences: GPL-3.0 for the firmware and tools, AGPL-3.0 for the plugin (JUCE),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
2026-09-25 README for GitHub, the showcase video on the project page, a licence for the boards
    - README: what it is, where it stands (nothing built yet), the two versions, pointers to the
    flasher, the build guide, the boards and the case, licences, a build badge.
    - site: a video section; the Pages job copies the full showcase next to the page. A note on
    the S3 circuit boards in "Build one"; the boards join the CC BY-SA row.
    - hardware/LICENSE: the board files are CC BY-SA 4.0 like the case; hardware/gen stays GPL-3.0.
    - CLAUDE.md: the README is current now.
    Claude-Session: https://claude.ai/code/session_01Q2QvYhdngnPuWQ8uKpeasY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
2026-10-08 Stack boards at 94 x 46 mm, one-piece JLC panels for the stack and the Mini + Filter
    The stack's two boards shrink to 94 x 46 mm with the DAC straps under the
    bottom board and both breakout rows in the middle, under the top board.
    New hardware/gen/panel.py copies built boards onto one panel with 5 mm
    tabs and mouse bites: the stack at 94 x 94 mm (panel-stack/), and the Mini
    with the Samplooler Filter at 82 x 94 mm (panel-mini/), with their JLC zips,
    BOM and CPL files and renders. kit.py checks router sessions for crossing
    tracks of different nets before accepting them. hardware/README.md, CLAUDE.md
    and the pcb-design skill describe the panels and the ordering settings.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
2026-10-08 Production pass: settings in NVS, muted chunked slot saves, crash capture, audio health, status SysEx
    Modelled on TWOFOLD's hardening. Settings persist under 4-character tags (old blobs still load),
    written 3 s after a change and never while recording. Slot save and load fade the output out,
    move the file in 16 KB chunks from the 10 ms loop with a progress screen, and save through a temp
    file. diag.c keeps a crumb and the panic text plus backtrace in RTC memory through a --wrap of
    esp_panic_handler; the next boot shows CRASH/BROWNOUT/WATCHDOG on the screen. The audio task has
    bounded I2S reads, counts overruns, underruns and flash stalls, and raises the speaker amp only
    after 50 ms of good c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
2026-10-08 Screen revamp: a tape between two reels, a stick-figure operator, TWOFOLD's fonts and pills
    The loop's waveform runs as a tape between two spinning reels; the operator stands on it and runs with
    the real speed and direction, tumbles above 4.5x, is echoed by the delay, stutters with the stutter and
    juggles grains in GRAIN mode. The splash has them carry the cassette in and trip over a reel; slot jobs
    carry it to the shelf; a crash flattens them under a falling cassette, a watchdog reset brings a dog,
    a brownout a flickering bulb; three idle minutes and they sleep, drifting so the OLED does not burn in.
    Proportional faces (tiny, small, med, big) and the ASCII-art font format come from TWOFOLD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
2026-10-08 Record button instead of the joystick; the encoder runs the menu: tap to open, dive, back; hold to leave
    PIN_REC (GPIO 3 on the S3, the Mini board's REC; the C3 keeps BOOT) records. The encoder is the same on
    both chips: tap opens the menu, dives into the chosen setting (or runs Save/Load) and climbs back out,
    hold leaves, turn chooses in the list, adjusts while editing, and in play mode adjusts the last setting
    with a toast. The menu pill is outlined while choosing and filled while editing, with a hint under it.
    HAS_JOY is 0; a kit with the joystick can set it to 1 for Y = speed when tilt is off and X = pitch.
    tools/flash.sh also reboots a board that still runs TWOFOLD into the bootloader.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
2026-10-08 diag: the status report as two log lines, so neither is cut at the MIDI line limit
2026-10-08 S3: main task stack 8 KB (6 KB left 1.3 KB free on the board)
2026-10-11 Get one: prebuilt on request, the ESP32 workshop, one board with TWOFOLD
2026-10-11 The current screen on the page and README: a tour of the tape and its operator
    tools/uisim/tour.sh drives ui.c through a scripted session (boot gag, record, forwards,
    backwards, delay, stutter, grains, flung at 8x, the crawl) and writes tour.mp4 and tour.gif.
    The page's hero and Screens show the new design; the old screen stills are gone.
2026-10-11 Showcase video re-rendered with the current screen and the rev C boards
    make_showcase.sh: the C3 case shot reads 09_play_forward.pbm (the simulator's stills were
    renamed in the screen revamp, so stage 4 could not find 5_play_delay.pbm). New poster frame.
2026-10-17 Rev D boards, firmware and page changes (work in progress, before the launch cleanup)
2026-10-17 Stack only, for launch: the boards, the manual, the build guide
    - hardware/ holds the Stack's release files only (KiCad schematics and boards, parts library, JLCPCB
    files, pictures); the board generator, the Mini and the Filter moved out of the repo.
    - No case: the enclosure is out.
    - docs/MANUAL.md (playing it, every setting, MIDI, updating, troubleshooting) and docs/BUILD.md (making a
    Stack) replace the old guide; design notes, ideas and the production review are no longer published.
    - README rewritten for the Stack; media/ holds the pictures; PHOTO/VIDEO lines mark what is still to shoot.
    - CLAUDE.md, AGENTS.md and the agent skills are no longer in the repo; the video tooling is gone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
2026-10-18 Samplooler: SING's voices on the input, and a Speaker switch
    Voice, Key, Scale and Monitor settings (CC 30-33; program change picks the voice) put SING's
    18 voices before the recorder; Speaker OFF holds the amp's SD pin low so only the line out
    plays. The plugin follows the new CC map; tools/voicesim runs every voice on the host.
    Claude-Session: https://claude.ai/code/session_01Py9xdVyp7XVjTpqdhvdaDW
2026-10-18 core: SPEAKER and REC BUTTON settings, a stuck REC at boot, hardening
    SYSTEM > SPEAKER holds the amp off (the line out plays on); SYSTEM > REC BUTTON can ignore the
    REC pin (BOOT and MIDI still record; INST.rec_button_off starts it off). The factory reset
    needs REC let go after 3 s, and a REC still down after 6 s counts as stuck. The menu's sound
    list is bounded. Copied into BAND and SING; SING's vocoder RELEASE is in ms as labelled.
    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
2026-10-18 WRECK: REC starts off (BOOT samples), the production sweep
    The REC pin is ignored until SYSTEM > REC BUTTON is on (a board has it stuck low). The sweep:
    RESAMPLE at DRONE waited for the ring (it recorded stale audio); the amp's strings start at
    rest so the drone is the same every time; a DC step in the tape stop; a feel change spinning
    the tape up during a REC stop; sound loads no longer push the tempo to the link; the sampling
    hint learned on the hold. Soaks of hours a zone; 164 checks; the docs match the code.
    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
2026-10-18 MANTRA: a formant voice, a singing Buddha and a wall of amps
    Monks chanting OM, overtone singing (khoomei, sygyt, kargyraa), the chorus of Daisy Bell as
    the IBM 7094 sang it, a vowel player and HUM ALONG; the knob blends the chant into Daisy.
    Tilt is the jaw, roll the pitch, yaw the overtone, pumping the breath, a knock the singing
    bowl. The DRONE module is WRECK's amp at its doom end (the same engine, so linked boards are
    one amp wall): a chord held from the song's chords, swells, feedback, sub, hum, organ; SUNN,
    DOOM DAISY and ORGAN have it up. 160 simulator checks; the chant ran on a board.
    Claude-Session: https://claude.ai/code/se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
2026-10-19 HUFF: the current core, the link, the production sweep
    Core-copied onto the current core (REC BUTTON, SPEAKER, the hardened front). The ESP-NOW link:
    ECHO BEATS on the flock's tempo, TEMPO on CC 54, LINK/GROUP/RANGE and WHO IS THERE, KEY and SCALE
    on the flock's harmony (PHRYGIAN and HARM MINOR added so every linked scale has a name here).
    The sweep: jet fold hysteresis, sleeping voices, echo and reverb when silent (idle 1.1 us a block),
    smoothed controls, HUMMING's snap reset. 104 checks, 720 KB image. Host-tested only.
    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
2026-10-19 Samplooler: the production sweep and the link to the library boards
    The five known issues fixed (tilt off is 1x, Speed's max on its CC, the actions, program change,
    a stuck REC at boot no longer factory-resets; a Rec button setting). NaN guard and a frame clock in
    audio, bounded trims, cached slot lengths, voice engines skipped when unused, a BEAT pill and a
    radio glyph on the screen. flock.c + link.c: a free take sets the flock's tempo (n beats in 1, 2, 4,
    8, 16 into 60..180 BPM); with a tempo the take snaps to whole beats and plays on the grid (snap end,
    lock, jump); Voice Key/Scale follow and publish the harmony. Release images in two parts. Host
    tools: flocksim (30 checks), a soak, host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
2026-10-19 A launcher: the library and a one-click install onto any board
    app/: a Tauri 2 desktop app (Rust + plain HTML). Reads library.json as tools/library.py site
    writes it (online, cached, or a local folder). The instruments with their pictures, README and
    manual; Install downloads the parts with a sha256 check, reboots the board into download mode over
    its own MIDI port and writes bootloader, partition table and app with espflash, keeping the slots
    and settings. A board view (settings, log) and a local ESP-IDF build. Boards are found by USB
    name only; the TWOFOLD is on a never-list; the write refuses a port whose MAC is not the board
    asked. library.py: the Samplooler first in the list, the docs c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
2026-10-19 Launch: only the instruments that have run on a board, the page with their install buttons, a roadmap
    The page, the app and instruments/README.md list the Samplooler, WRECK, MANTRA and HUFF; the other eight stay in
    the repository with "listed": false until they run on a board with the current core (library.py: listed(),
    ids --listed). build.yml now builds the listed instruments, runs their simulators and publishes library.json with
    their firmware next to the page, so the page and the app have the list (it was never published). The page: the C3,
    the case and "not built yet" are gone, the instruments install from it, and the Samplooler flashes as parts, so
    loops and settings stay. README, manu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
2026-10-19 The app's line: a board's settings in the desktop app
    The core and the Samplooler answer the app over MIDI SysEx: I (who are you), D (describe every setting), P (set
    one), V (what changed). The core's front.c serves it for every instrument on the current core (WRECK, MANTRA,
    HUFF, BAND, SING, copied in); the Samplooler's app_line.c describes its 23 settings in six groups, Save asks first.
    A board that hears nothing for 5 s stops sending and catches up when the app speaks again; a message that cannot
    go out quiets the line. The app pings every 2 s and has step and act controls; a board in download mode is still
    written only when it is the only one. Instruments take their version from entry.js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
2026-10-19 The page in the app's look, without the 3D renders
    site/ wears the desktop app's kit (kit.css copied from app/ui/app.css, the firmware's pixel fonts, one colour per
    instrument): the screen, try it, what it does, the screen's states, the instruments with their install buttons,
    get one, flash, build, licences. The rendered 3D video and the board render are off the page and the README until
    there are better ones; the Pages job no longer fetches the video. Title, description, canonical, Open Graph and
    structured data for search.
    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
2026-10-19 The knob: two clicks put it on the volume, in every firmware; the volume glides
    In play, one click opens the menu 0.3 s later (a second click may still come); two clicks put the knob on
    VOLUME, with its strip or toast, until it rests 3 s or is clicked. The same in the core (WRECK, MANTRA, HUFF,
    BAND, SING) and in the Samplooler; not while an instrument holds the knob (BAND's mixer). The volume now glides
    (about 50 ms to settle 63 %) in the core's master stage and on the Samplooler's loop, so encoder steps sound like a
    fader. Checks: the double click, the menu still on one click, the glide (core and flocksim). sim_tap waits out the
    click window. WRECK's dive check measures the chord's fifth (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
